WeymenKoo/dc-electronic-load/hardware/outputs/rev_e_v1/placement_top.png

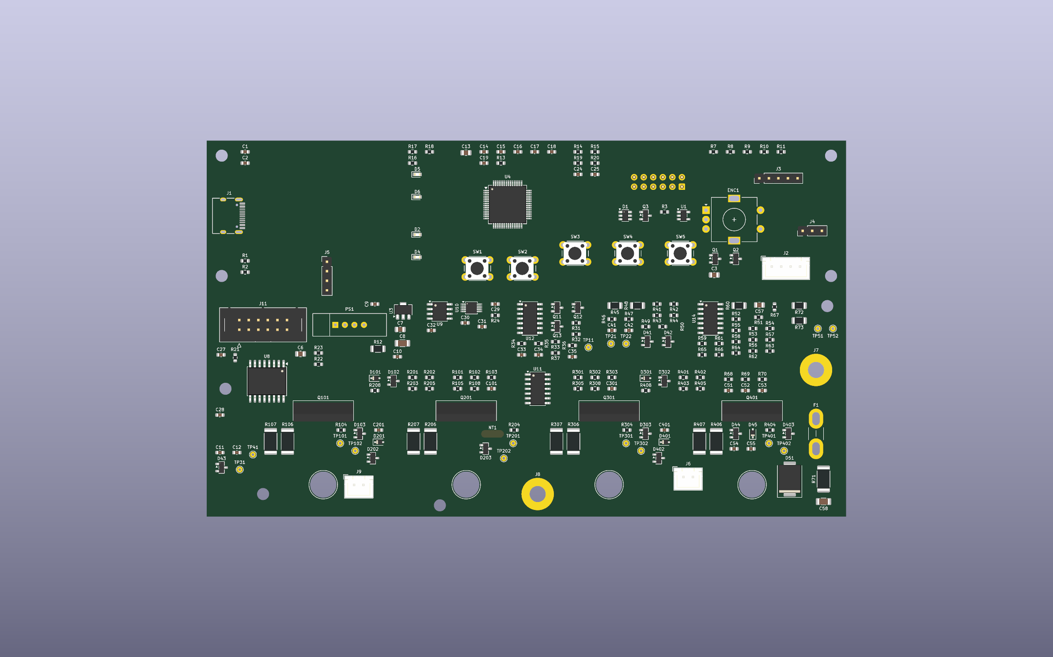
hardware/outputs/rev_e_v1/placement_top.png
