WeymenKoo/dc-electronic-load/simulation/rev_e/README.md

# Rev E decks: the Rev C analog stage with the TLV9154

The same five circuits as `../01_dc_transfer` to `../06_cv_mode` (deck 05, thermal, has no op-amp and is not repeated), generated by the same
`tools/build_decks.py --rev-e` with three differences: the op-amps are TI's TLV9152 PSpice macromodel (`../lib/tlv915x.lib`, one amplifier,
shared by the TLV9154), the channel offset resistor Rb is 15M instead of 22M (+2.6 mV against the TLV9154's 0.83 mV Vos limit), and deck 03's
lowest current corner is 50 mA instead of 25 mA (25 mA per channel is now inside the dead zone). Everything else, including every `.meas`, is
identical so the two result sets compare line by line. The Rev C decks and their results are untouched.

```
rev_e/
├── 01_dc_transfer/      <name>.asc, <name>.plt, plot_<name>.py, README.md, results/ (reference .log and fig*.png)   exactly like the Rev C folders
├── 02_step_response/
├── 03_loop_gain/
├── 04_faults/
├── 06_cv_mode/
└── measurements_summary.txt
```

**Run them from a local copy.** LTspice (the CrossOver build) cannot write its `.raw` incrementally into a Google Drive File Stream folder
("Trouble writing ... to the disk"): `../tools/ltrun_local.sh rev_e/<deck>/<deck>.asc` mirrors the deck and `../lib` into `$TMPDIR/ltrun_local`,
runs LTspice there and copies `.log`, `.raw` and `.net` back. In the LTspice GUI, copy the `simulation` folder somewhere local first.
The TI macromodel is slow to find the operating point when every op-amp output sits at 0 V (dead zone): deck 01 takes about 13 minutes, deck 03
about 4; the "Direct Newton iteration failed" lines followed by "Pseudo Transient succeeded" are that fallback, not a failed run.

| # | Result | Rev E (TLV9154) | Rev C (LT1014 / LT1013) | Figure |
|---|---|---|---|---|
| 01 | Transfer gain | 2.501 A/V | 2.500 A/V | fig01a |
| 01 | Full scale (LOAD_CTRL = 4.096 V) | 10.14 A (106 mA zero offset) | 10.17 A (72 mA) | fig01a |
| 01 | ISEN error after zero subtraction, full scale | −0.002 % | −0.008 % | fig01b |
| 01 | VSEN error against its ideal transfer | +0.13 mV (0.005 % of reading at 48 V) | < 0.02 mV | log |
| 02 | 10–90 % rise, 1 A → 9 A, planar FETs | 22.5–31 µs | 21–31 µs | fig02a |
| 02 | Overshoot, planar FETs | 0 % | 0 % | fig02 |
| 02 | Overshoot, IXTH big-die proxy, 1 µH | **53 % (13.6 A), then a ~300 kHz ring** | 0 % | fig02a |
| 03 | Phase margin, planar FETs, worst of 18 corners | 87.5° | ≥ 86° | fig03 |
| 03 | Gain margin, planar FETs, worst | 21.8 dB | ≥ 22 dB | fig03 |
| 03 | IXTH proxy, worst | 80.2° / **9.1 dB** | 80.3° / 13.2 dB | fig03 |
| 03 | Crossover, 2.5 A per channel | 16–36 kHz | 15–35 kHz | fig03 |
| 04 | Peak current on hot-plug / recovery at 8 A, planar FETs | 8.09 A = set point | 8.12 A = set point | fig04 |
| 04 | Same, IXTH proxy | **13.2 A** (hot-plug and recovery) | 8.12 A | fig04 |
| 04 | OTP trip: time to < 0.8 A | 1–33 µs | 2–35 µs | fig04 |
| 06 | CV on a current source, 1 A and 8 A, with or without 47 µF | 12.00 / 9.998 V, < 0.2 mV pp by 50 ms | 11.97 / 9.97 V, < 4 mV pp | fig06 |
| 06 | CV at 0.1 A, no capacitor | settled, 0.2 mV pp | settled, 3 mV pp | fig06 |
| 06 | CV at 0.1 A with 47 µF | **underdamped: 10.6 V pp ring at 50 ms, still 4.1 V pp at 149 ms** | 7.3 V pp, 1.7 V pp at 149 ms | fig06 |

**What this means for the design.** Deck 06: the CV loop holds 1 A and 8 A sources exactly (the rail-to-rail output removes the LT1013's
0.25 % floor error), but at 0.1 A with 47 µF across the DUT it rings harder and longer than with the LT1013; 0.1 A stays the stated CV minimum
and a capacitive source at that current should be loaded in CC or given a few seconds.

 The IRFP250N (and the IRFP240 / IRF530 fallbacks) keep the Rev C margins with the 6× faster op-amp; the
3.3k / 1n / 47R compensation stays. The big-die IXTH proxy, which stands in for IXYS linear-rated parts that are not in the BOM, loses gain margin
and overshoots on hot-plug; if one is ever fitted, raise Cc to 2.2 nF and re-run decks 02 to 04. The 15M offset resistor moves the dead zone from
72 mA to 106 mA (the first 42 DAC codes); the firmware clamp (code ≥ 42 → 0 A) is the same mechanism as before.

Model-dependent numbers: the TLV9152 macromodel is TI's (SBOMB53B, 2021); treat rise times and margins as ±30 % and verify on the bench
(bring-up step 8 in `../../docs/rev_e_specification.md`).
