WeymenKoo/dc-electronic-load/docs/comparison_cheap_loads.md

# Rev C compared with the AliExpress loads (DL24 / DL24P / DTL150 family)

Evidence is mostly forum measurements and one teardown of an older Atorch unit, not lab reports. Treat each row as "reported", and note that units vary.

| Reported problem on the cheap loads | Source | Rev C answer | Status |
|---|---|---|---|
| Gate spikes to 27.6 V on a ±20 V FET, ringing about 37 V; three FETs blown at about 40 V | [teardown](https://mirror.sevarg.net/2018/06/24/the-atorch-purple-fan-mosfet-destroyer/) | 15 V gate-source zener, Rg at the gate, compensated loop (PM ≥ 80°) | Simulated; bench step test pending |
| No fuse found; a shorted FET across a battery is unlimited | same | F1 15 A 58 V DC | Designed |
| Smoke at 20 V / 9 A, bang under 90 W on a 36 V pack, "practical maximum about 100 W" | [EEVblog DL24P thread](https://eevblog.com/forum/testgear/cheezeball-dc-load-dl24p-pump-or-dump/150) | 4 × TO-247 at 37.5 W each, Tj 127.5 °C at 150 W | Depends on heatsink Rsa, **still an estimate** |
| Advice to stay below 32 V and 10 A despite a 200 V / 20 A label | [done.land](https://done.land/tools/devices/electronicload/dl24atorch/) | 58 V, 10.2 A are the real limits, each with a reason | Designed |
| Weak LM321 driving the gate; instability and high current on reconnect | EEVblog, same thread | KILL line: peak = setpoint on hot-plug and recovery | Simulated, deck 04 |
| Non-CC modes likely in software, slow, with overshoot | EEVblog, same thread | Hardware CV loop | Simulated, deck 06 |
| Unbalanced FET heating, shunts of mismatched value | [EEVblog p. 14](https://eevblog.com/forum/testgear/cheezeball-dc-load-dl24p-pump-or-dump/325) | One op-amp loop per FET | Simulated, deck 01 |
| Series reverse-protection Schottky at 0.42 V, 85–100 °C; limits low-voltage use | EEVblog p. 14 | No series diode, works from about 0.6 V; reverse polarity clears the fuse instead | Designed |
| 4-wire voltage error growing with current | EEVblog, same thread | Separate sense amp and pair (J7) | Designed |
| Low-voltage cut-off re-enables on battery rebound | teardown | Firmware latch (requirement) | Firmware not written |
| Possibly used or counterfeit FETs in the unit | EEVblog p. 14 | You choose the source: buy from an authorised distributor | – |

## Where Rev C does NOT win
- **Price of a finished unit.** One older listing had a 150 W tester [at about $30](https://budgetlightforum.com/t/mini-review-150w-load-unit/43730). Rev E's parts come to US$23.46 at JLCPCB / LCSC prices (2026-11-03, `hardware/outputs/rev_e_v1/BOM_RevE_JLC.csv`) plus about $7 of off-board items (OLED module, 5 V blower, NTC, ribbon, M4 hardware) and $4 to $6 of PCB, so about $35 per instrument excluding the scrap heatsink and the enclosure. (Rev C's parts were about US$65–90 at distributor prices.) It beats a [Siglent SDL1020X-E at about $574](https://valuetronics.com/apps/aeo/ai/md/default/products/8359457521911.md), not a DL24.
- **Very low current.** A DL24 was reported usable down to about 10 mA. Rev C has a deliberate 72 mA dead zone in CC (Rev E: 106 mA, because the TLV9154's offset limit is larger) and a 0.1 A minimum in CV. For a small current source, use a resistor or decade box.
- **Readback resolution.** The 12-bit ADC gives 2.7 mA and 16 mV per LSB. For a precision current source, the DMM in series is the reference and the load only sets the compliance voltage.
- **Ground.** DUT− is common with USB ground, the same class of problem the DL24P thread reports. See the warning in the spec.
- **It exists today.** Firmware for every mode above CC is unwritten.

## Cost estimate (not quotes; check before ordering)
| Item | Estimate | Basis |
|---|---|---|
| 4 × IRFP250NPBF | $13 | [about $3.29 each at Mouser](https://www.flux.ai/jecstronic/irfp250npbf~3kd.md), aggregator figure |
| LT1014DSW#TRPBF | $10 | [about €9.73](https://punchouttest.digikey.es/en/products/detail/analog-devices-inc/LT1014DSW-TRPBF/962051); the non-reel #PBF showed out of stock |
| 2 × LT1013DS8 | $10–15 | my estimate, no price found |
| Passives including 0.1 % parts, LM339, small FETs, diodes | $10–15 | my estimate |
| Connectors, fuse + holder, 2 binding posts + 2 sense terminals | $10–15 | my estimate |
| 2 oz PCB | $5–15 | my estimate |

**Saving taken in Rev E:** the LT parts were replaced by two TLV9154 quads (16 V, Vos 0.83 mV max, $1.34 each at LCSC) with the zero-offset resistor changed from 22M to 15M, and the whole stage was re-simulated (`simulation/rev_e`). The IRFP250N is the genuine Infineon part at LCSC (C2580, $1.00), not the sub-$1 clones.
