WeymenKoo/dc-electronic-load/docs/design_notes_and_calculations_rev_b.xlsx

Sheet: Top
 | Study Material:
 | https://eepower.com/technical-articles/understanding-linear-mosfets-and-their-applications/#
 | https://eevblog.com/forum/projects/dynamic-electronic-load-project/
 | https://www.vishay.com/docs/91019/irf530.pdf
 | https://community.element14.com/members-area/personalblogs/b/blog/posts/lt-spice-loop-gain-and-an-electronic-load
 | https://www.electrical4u.com/bode-plot-gain-margin-phase-margin/#What-is-a-Bode-Plot
 | High level plan:
 | Control Board: |  |  |  |  |  | Power Board:
Led | MCU |  |  |  |  |  | Power MOSFET
 | DAC |  |  |  |  |  | Eload control circuit
Led | 12V buck 5V LDO 3V3 |  |  |  |  |  | DUT power monitoring
 | Input RPP, Fuse |  |  |  |  |  | DUT interface, Banana Plugs
 | Keypad 4x4 |  |  |  |  |  | Hardware OCP, Over Temp |  | Just a Fuse
 | Rotary Encoder |  |  |  |  |  | Heatsink
 | LCD display |  |  |  |  |  | RPP for DUT
 | Opamp Vref
 | Thermocouple circuit
 | Fan control circuit
 | B2B connector to power board |  |  | 3V3 | 3V3 | > | B2B connector to control board
 |  |  |  | 4.096V | Opamp Vref (4.096V) | >
 |  |  |  | A1 | DAC Voltage input for Eload | >
 |  |  |  | A2 | Eload Isense | <
 |  |  |  | A3 | Eload Vsense | <
 |  |  |  | D1 | OCP Trip signal | >
 |  |  |  | D2 | Them Runaway signal | >
 |  |  |  | G | Gnd | <>
 |  |  |  |  | Standoff Gnd
 | B2B Connector arrangement 16pin
 | 1 | 2 | 3 | 4 | 5 | 6 | 7 | 8
 | G | 5V | A1 | G | A2 | G | D2 | G
 | G | 3V3 | A3 | G | D1 | G | 5V | G
 | https://electronics.stackexchange.com/questions/207752/how-many-ground-and-power-pins-to-have-in-a-connector
 | Design Notes:
 | 1. Grounding for Signal Integrity and EMI Control:
 | Ground pins are interleaved between analog and digital signals, creating a shield to reduce cross-talk and EMI.
 | Both rows have ground pins near each reference voltage (3.3V and 5V) to help stabilize and isolate power delivery from signals, reducing potential noise interference.
 | 2. Symmetry for Connector Reversal Protection:
 | Power and ground pins are symmetrically placed across both rows, so accidental reversal won’t lead to shorts or cross-connection of signals.
 | Critical analog signals are placed with ground separation, enhancing signal accuracy and stability for current, voltage, and op-amp control.
 | 3. Pin Isolation and Shielding:
 | Analog signals are separated from digital signals by ground pins to reduce noise coupling and improve overall analog signal integrity.
 | Digital signals are spaced out with grounding to mitigate potential EMI from digital switching activities.

Sheet: MCU
Required features | Quantity | Purpose | Notes |  | MCU Selection:
UART | 1 | Serial Monitor on Laptop | UART to USB Bridge | 1 | ~~STM32F103CBT6~~ | Not enough ADC
SWD | 1 | Program and Debug |  |  | ~~Digikey:~~ | ~~https://www.digikey.ca/en/products/detail/stmicroelectronics/STM32F103CBT6/1754420 ~~
ADC | 3 | Vsense Isense Themocouple | Sensing circuit for the Eload part |  | ~~JLCPCB:~~ | ~~https://jlcpcb.com/partdetail/Stmicroelectronics-STM32F103CBT6/C8304 ~~
I2C Bus | 1 | External DAC with EEPROM LCD Display | Bus, make sure devices have different addr
PWM | 1 | Fan control |  | 2 | STM32F103RET6
Encoder | 1 | Eload Setting |  |  | JLCPCB: | https://jlcpcb.com/partdetail/Stmicroelectronics-STM32F103RET6/C8322
Digital In | 4 | Button Input
 |  | Pgood 5V |  | 3 | ~~Atmega~~ | ~~Only has 10bit adc~~
 |  | Pgood 3V3
 |  | Pgood 12V |  | 4 | ~~STM32F411CEU~~ | ~~Only has 1 adc~~
Digital Out | 2 | OCP trip | Signals to shut off power MOSFETs circuit
 |  | Temp Trip | Signals to shut off power MOSFETs circuit
 |  |  |  |  |  | OSC capacitors sizing
https://www.st.com/resource/en/application_note/an2586-getting-started-with-stm32f10xxx-hardware-development-stmicroelectronics.pdf |  |  |  |  |  | Reference:
 |  |  |  |  |  | https://blog.adafruit.com/2012/01/24/choosing-the-right-crystal-and-caps-for-your-design/
 | Decoupling capacitor placement

Sheet: IO
Rotary encoder
https://www.digikey.ca/en/products/detail/bourns-inc/PEC11L-4120K-S0020/4699173
https://www.bourns.com/docs/Product-Datasheets/PEC11L.pdf
https://www.digikey.ca/en/products/detail/jst-sales-america-inc/B16B-PHDSS/926671 | Connector
https://www.digikey.ca/en/products/detail/jst-sales-america-inc/PHDR-16VS/608615 | Plug
https://www.digikey.ca/en/products/detail/jst-sales-america-inc/APAPA22K152/6009461 | Wire

Sheet: DAC
MCP4725A
Datasheet: | https://www.lcsc.com/datasheet/lcsc_datasheet_1811151442_Microchip-Tech-MCP4725A0T-E-CH_C144198.pdf
JLCPCB: | https://jlcpcb.com/partdetail/MicrochipTech-MCP4725A0T_ECH/C144198
Digikey: | https://www.digikey.ca/en/products/detail/microchip-technology/MCP4725A0T-E-CH/1818537
Widely available, good datasheet, widely used online
https://www.sparkfun.com/products/12918
https://www.adafruit.com/product/935
Has builtin eeprom to store config data
Design: |  | Calculations:
 |  | 12bit | 4095 | decimal
 |  | Vref | 4.096 | V
 |  |  | 0.0010002442 | V/bit

Sheet: Power In
Power Flow chart:
Source 12V PSU | Barrel Connector |  | ~~Reverse Polarity Protection~~ | 03/11/2024: No need cuz barrel connector is mech polarized, also unlikely to vary in current draw
 |  |  | ~~~~OVP Circuit~~, 2A Fuse~~
Wall adapter
Bench PSU
4S Lipo
 | USB 5V |  | 12-20ish V buck to 5V | Tp
 |  |  |  | Pgood Led | https://www.lcsc.com/datasheet/lcsc_datasheet_1811081920_Texas-Instruments-TPS5430DDAR_C9864.pdf
 |  |  | OR
 |  | 5V LDO to 3V3 |  | 5V to 4.096V DAC Vref
 |  | Tp |  | Tp
 |  | Pgood Led |  | Place Close to DAC
DUT in RPP:
Low forward voltage drop

Sheet: Temp
Thermocouple design
Thermal budget
Heatsink sizing
Fan circuit design
 | https://www.ti.com/lit/an/sbaa274a/sbaa274a.pdf?ts=1730026208831
Fan control using NTC | https://www.youtube.com/watch?v=hU86hCRVi3g

Sheet: Eload Stability
4.096V for opamp votlage reference due to it being a stable source. 5V from buck converter is noisy
5V from USB is also very noisy
Max current sink for each mosfet | 5 | A | Max power across resistor | 2.5 | W
Source resistor | 0.1 | Ohm | Max current across Eload | 12.288 | A
Max gate votage | 0.6144 | V
R1 | 68000 | Ohm | Transfer function of Eload | 3 | A/V
R2 | 12000 | Ohm
Vcontrol Max | 4.096 | V

Sheet: MOSFET
https://www.vishay.com/docs/91019/irf530.pdf

Sheet: Pwr Monitor
Voltage sensor
https://www.ti.com/power-management/power-switches/efuse-hotswap-controllers/overview.html |  |  |  | ADC bit |  | ADC cnts | Vout | Vin
 |  |  |  | 4096 | 12 bit | 124.1212121 | 0.1 | 1.0000
https://www.ti.com/lit/ds/symlink/tps1663.pdf?ts=1730614123864 |  |  |  | 0.0008056640625 | V/bit | 248.2424242 | 0.2 | 2.0000
https://www.ti.com/lit/ds/symlink/lmv324.pdf |  |  |  | 3.3 | ADV vref | 372.3636364 | 0.3 | 3.0000
 |  |  |  |  |  | 496.4848485 | 0.4 | 4.0000
EUT Max spec |  |  |  |  |  | 620.6060606 | 0.5 | 5.0000
30 | V |  |  |  |  | 744.7272727 | 0.6 | 6.0000
5 | A |  |  |  |  | 868.8484848 | 0.7 | 7.0000
Vout = (R3/R1) * (V2-V1) |  |  |  |  |  | 992.969697 | 0.8 | 8.0000
3 | V |  |  |  |  | 1117.090909 | 0.9 | 9.0000
 |  |  |  |  |  | 1241.212121 | 1 | 10.0000
R1 | 20000 | Ohm |  |  |  | 1365.333333 | 1.1 | 11.0000
R3 | 2000 | Ohm |  |  |  | 1489.454545 | 1.2 | 12.0000
 |  |  |  |  |  | 1613.575758 | 1.3 | 13.0000
 |  |  |  |  |  | 1737.69697 | 1.4 | 14.0000
 |  |  |  |  |  | 1861.818182 | 1.5 | 15.0000
 |  |  |  |  |  | 1985.939394 | 1.6 | 16.0000
 |  |  |  |  |  | 2110.060606 | 1.7 | 17.0000
 |  |  |  |  |  | 2234.181818 | 1.8 | 18.0000
 |  |  |  |  |  | 2358.30303 | 1.9 | 19.0000
 |  |  |  |  |  | 2482.424242 | 2 | 20.0000
 |  |  |  |  |  | 2606.545455 | 2.1 | 21.0000
 |  |  |  |  |  | 2730.666667 | 2.2 | 22.0000
 |  |  |  |  |  | 2854.787879 | 2.3 | 23.0000
 |  |  |  |  |  | 2978.909091 | 2.4 | 24.0000
 |  |  |  |  |  | 3103.030303 | 2.5 | 25.0000
 |  |  |  |  |  | 3227.151515 | 2.6 | 26.0000
 |  |  |  |  |  | 3351.272727 | 2.7 | 27.0000
 |  |  |  |  |  | 3475.393939 | 2.8 | 28.0000
 |  |  |  |  |  | 3599.515152 | 2.9 | 29.0000
 |  |  |  |  |  | 3723.636364 | 3 | 30.0000
Current sensor
https://www.ti.com/product/INA240
https://www.ti.com/lit/ds/symlink/ina240.pdf?ts=1732175159029
https://www.ti.com/lit/ug/tidu447/tidu447.pdf?ts=1732194664933
For a 10A current shunt, and a 50mV voltage drop, what is a current shutn
ChatGPT said:
ChatGPT
For a 10A current shunt with a 50mV voltage drop, the shunt is a precision resistor designed to produce that 50mV voltage when 10A flows through it. Here's the calculation and what it means:
Resistance of the Shunt
Using Ohm’s Law (V=I×RV = I \times RV=I×R):
R=VIR = \frac{V}{I}R=IV R=50 mV10 A=5 mΩR = \frac{50 \, \text{mV}}{10 \, \text{A}} = 5 \, \text{m}\OmegaR=10A50mV=5mΩ
This means the shunt resistor has a resistance of 5 milliohms (5 mΩ).
Power Dissipation
The power dissipated by the shunt resistor due to the current flowing through it is:
P=I2×RP = I^2 \times RP=I2×R P=102×0.005=0.5 WP = 10^2 \times 0.005 = 0.5 \, \text{W}P=102×0.005=0.5W
This means the shunt needs to handle 0.5 watts of power without overheating.
What the Shunt Does
It provides a voltage output (50mV) proportional to the current (10A) flowing through it.
This voltage can be measured and used to determine the current: I=VRI = \frac{V}{R}I=RV
In this case, a current of 10A will produce 50mV across the shunt.
Applications
Current Measurement:
The voltage (50mV) can be fed into an analog-to-digital converter (ADC) or a differential amplifier to monitor the current.
Power Monitoring:
Combined with a voltage measurement, the shunt can help calculate power (P=V×IP = V \times IP=V×I).
Overcurrent Protection:
Used in circuits to detect if the current exceeds safe limits.
Considerations for a 10A Shunt
1. Material:
Use low-TCR materials like manganin to maintain consistent resistance over temperature variations.
2. Power Rating:
The resistor should handle at least 0.5W, with a safety margin (e.g., 1W or higher).
3. Kelvin Connections:
Use 4-wire (Kelvin) connections to eliminate errors from PCB trace resistance.
4. Physical Design:
Ensure the shunt can handle the thermal and mechanical stresses of a 10A current.
5. Parasitic Effects:
Minimize inductance for accurate measurement of AC or pulsed currents.
Would you like help selecting or designing a specific shunt resistor?
4o
You said:
what is a suitable gain of an opamp for an adc with refernce of 3v3 (20v/v, 50v/v, 100, 200)
ChatGPT said:
ChatGPT
To determine a suitable gain for the op-amp, we need to ensure the output voltage range matches the ADC's input range without clipping. Here's how to decide based on your conditions:
Key Parameters
1. ADC Reference Voltage: 3.3 V3.3 \, \text{V}3.3V (full-scale voltage for the ADC).
2. Shunt Voltage Range: 50 mV50 \, \text{mV}50mV maximum.
3. Gain: G=VADC max/Vshunt maxG = V_{\text{ADC max}} / V_{\text{shunt max}}G=VADC max/Vshunt max.
Gain Calculation
The maximum output voltage of the op-amp (after amplification) must not exceed the ADC reference voltage:
Voutput=Vshunt×GV_{\text{output}} = V_{\text{shunt}} \times GVoutput=Vshunt×G
For Vshunt max=50 mVV_{\text{shunt max}} = 50 \, \text{mV}Vshunt max=50mV:
G=VADC maxVshunt max=3.30.05=66G = \frac{V_{\text{ADC max}}}{V_{\text{shunt max}}} = \frac{3.3}{0.05} = 66G=Vshunt maxVADC max=0.053.3=66
This means the gain should be ≤ 66 to avoid clipping.
Evaluating Options
2. 50 V/V: |  |  | 1.24
Output: 50 mV×50=2.5 V50 \, \text{mV} \times 50 = 2.5 \, \text{V}50mV×50=2.5V
Fits within the 3.3V range.
Good trade-off for higher resolution.

Sheet: Reference
https://www.eevblog.com/forum/projects/yet-another-diy-electronic-load/25/
https://www.eevblog.com/forum/projects/dynamic-electronic-load-project/50/
