WeymenKoo/dc-electronic-load/archive/rev_b_netlists/netlist_RevB_power_board.txt

####  IO.SchDoc
 P1       Header_Male_2R_16P           61301621121                    
 XF1      FUSE_HOLDER-4                3568                           JLCPCB: 
C19727305
Fuse Holder, 20 A, 500 V, -50 to 145 de
 -- nets
  [+12V] P1.16(16)
  [+12V,PORT:+12V] 
  [+3V3] P1.3(3)
  [+3V3,PORT:+3V3] 
  [+4.096V] P1.4(4)
  [+4.096V] P1.13(13)
  [+4.096V,PORT:+4.096V] 
  [DUT Input,PORT:DUT+] XF1.3(3) XF1.4(4)
  [GND] P1.12(12) P1.2(2) P1.8(8)
  [GND] P1.1(1) P1.11(11) P1.15(15) P1.7(7)
  [GND,PORT:DUT-] 
  [GND,PORT:GND] 
  [PORT:DRAIN] XF1.1(1) XF1.2(2)
  [PORT:DUT_ISEN] P1.5(5)
  [PORT:DUT_VSEN] P1.10(10)
  [PORT:FAN-] P1.14(14)
  [PORT:LOAD_CTRL] P1.6(6)
  [PORT:TEMP_IN+] P1.9(9)
####  MOSFETs.SchDoc
 C3       Generic CAP 1210             =Value                         {'Value': '220pF'}
 C4       Generic CAP 1210             =Value                         {'Value': '220pF'}
 C5       11868f565c42a9108669ba33697e C3216X7S2A225K160AB            Multilayer Ceramic Capacitors 2.2uF ±10% 100V X7S SMD 1206
 J1       1e4615820a309e3ce90f9e6d957b 5001                           PC TEST POINT MINIATURE BLACK
 J2       1e4615820a309e3ce90f9e6d957b 5001                           PC TEST POINT MINIATURE BLACK
 J3       1e4615820a309e3ce90f9e6d957b 5001                           PC TEST POINT MINIATURE BLACK
 J4       1e4615820a309e3ce90f9e6d957b 5001                           PC TEST POINT MINIATURE BLACK
 J5       1e4615820a309e3ce90f9e6d957b 5001                           PC TEST POINT MINIATURE BLACK
 Q1       277670f45256a45703965f138927 IRF530PBF                      {'Manufacturer Part Number': 'IRF530PBF'}
 Q2       277670f45256a45703965f138927 IRF530PBF                      {'Manufacturer Part Number': 'IRF530PBF'}
 R12      1029c3af85768c4190bb7ad29bc6 =Value                         {'Manufacturer Part Number': 'RL2512FK-070R2L', 'Value': '200mO'}
 R13      1029c3af85768c4190bb7ad29bc6 =Value                         {'Manufacturer Part Number': 'RL2512FK-070R2L', 'Value': '200mO'}
 R14      1029c3af85768c4190bb7ad29bc6 =Value                         {'Manufacturer Part Number': 'RL2512FK-070R2L', 'Value': '200mO'}
 R15      1029c3af85768c4190bb7ad29bc6 =Value                         {'Manufacturer Part Number': 'RL2512FK-070R2L', 'Value': '200mO'}
 R16      Generic RES 0603             =Value                         {'Value': '68K'}
 R17      Generic RES 0603             =Value                         {'Value': '12K'}
 R18      1029c3af85768c4190bb7ad29bc6 CRCW12062R20FKEA               RES Thick Film, 2.2O, 1%, 0.25W, 100ppm/°C, 1206
 R6       Generic RES 0603             =Value                         {'Value': '100R'}
 R7       Generic RES 0603             =Value                         {'Value': '100R'}
 R8       Generic RES 0603             =Value                         {'Value': '3K3'}
 R9       Generic RES 0603             =Value                         {'Value': '3K3'}
 U3       499df5fc91ff7ad023bcaf249d8b LMV358AIDR                     IC OPAMP GP 2 CIRCUIT 8SOIC
 U3       499df5fc91ff7ad023bcaf249d8b LMV358AIDR                     IC OPAMP GP 2 CIRCUIT 8SOIC
 -- nets
  [+4.096V] U3.8(V+)
  [Control_Voltage] U3.3(+IN A)
  [Control_Voltage] U3.5(+IN B)
  [Control_Voltage] J3.1(1) R16.1(1) R17.2(2)
  [GND] C5.2(2)
  [GND] U3.4(V-)
  [GND] R17.1(1)
  [Gate1] J2.1(1) Q1.1(G) R6.2(2)
  [Gate2] J1.1(1) Q2.1(G) R7.2(2)
  [PORT:DRAIN] Q1.2(D) Q2.2(D) R18.2(2)
  [PORT:LOAD_CTRL] R16.2(2)
  [PORT:Rshunt] R12.1(1) R13.1(1) R14.1(1) R15.1(1)
  [Source1] J5.1(1) Q1.3(S) R12.2(2) R13.2(2) R9.2(2)
  [Source2] J4.1(1) Q2.3(S) R14.2(2) R15.2(2) R8.2(2)
  [-] C4.1(1) R9.1(1) U3.2(-IN A)
  [-] C3.1(1) R8.1(1) U3.6(-IN B)
  [-] C4.2(2) R6.1(1) U3.1(OUT A)
  [-] C3.2(2) R7.1(1) U3.7(OUT B)
  [-] C5.1(1) R18.1(1)
####  Power Monitor.SchDoc
 C1       Generic CAP 1210             =Value                         {'Value': '100nF'}
 C2       Generic CAP 1210             =Value                         {'Value': '100nF'}
 R1       Generic RES 0603             =Value                         {'Value': '2K'}
 R10      Generic RES 0603             =Value                         {'Value': '0R'}
 R11      Generic RES 0603             =Value                         {'Value': '0R'}
 R2       Generic RES 0603             =Value                         {'Value': '20K'}
 R3       Generic RES 0603             =Value                         {'Value': '20K'}
 R4       Generic RES 0603             =Value                         {'Value': '2K'}
 R5       1029c3af85768c4190bb7ad29bc6 WSLP25125L000FEA               WSLP25125L000FEA Res Metal Strip 2512 0.005 Ohm 1% 3W ±110pp
 TP1      TP1                          TP1                            Testpoint double sided
 TP2      TP1                          TP1                            Testpoint double sided
 U1       499df5fc91ff7ad023bcaf249d8b LMV358AIDR                     IC OPAMP GP 2 CIRCUIT 8SOIC
C182039
 U1       499df5fc91ff7ad023bcaf249d8b LMV358AIDR                     IC OPAMP GP 2 CIRCUIT 8SOIC
C182039
 U2       98c6b1d0971071ba4d7dac1d4a4e INA240A2PWR                    {'Manufacturer Part Number': 'INA240A2PWR'}
 -- nets
  [+4.096V] C2.2(2) U2.5(VS)
  [+4.096V] C1.2(2) U1.8(V+)
  [DUT_ISEN_P,PORT:Rshunt] R5.2(2) U2.2(IN+)
  [GND] C2.1(1)
  [GND] R4.2(2)
  [GND] R10.1(1) R11.1(1) U2.1(NC) U2.4(GND)
  [GND] R5.1(1) U2.3(IN-)
  [GND] C1.1(1)
  [GND] U1.4(V-)
  [PORT:DUT+] R2.1(1)
  [PORT:DUT-] R3.1(1)
  [PORT:DUT_ISEN] TP2.1(1) U2.8(OUT)
  [PORT:DUT_VSEN] TP1.1(1) U1.1(OUT A) U1.2(-IN A)
  [-] R3.2(2) R4.1(1) U1.6(-IN B)
  [-] R11.2(2) U2.7(REF1)
  [-] R1.1(1) R2.2(2) U1.5(+IN B)
  [-] R10.2(2) U2.6(REF2)
  [-] R1.2(2) U1.3(+IN A) U1.7(OUT B)
####  Top.SchDoc
 J6       49575d61908034f7a5505a4f8bf3 S3B-XH-SM4-TB(LF)(SN)          CONN HEADER SMD R/A 3POS 2.5MM
 -- nets
  [+12V] J6.2(2)
  [FAN] J6.3(3)
  [GND] J6.4(MNT 1) J6.5(MNT 2)
  [-] J6.1(1)
 SHEETSYM  
  sheettxt U_IO
  sheettxt IO.SchDoc
 SHEETSYM  
  sheettxt U_Power Monitor
  sheettxt Power Monitor.SchDoc
 SHEETSYM  
  sheettxt U_MOSFETs
  sheettxt MOSFETs.SchDoc
