WeymenKoo/dc-electronic-load/simulation/00_baseline_rev_b/results/schematic_preview.png

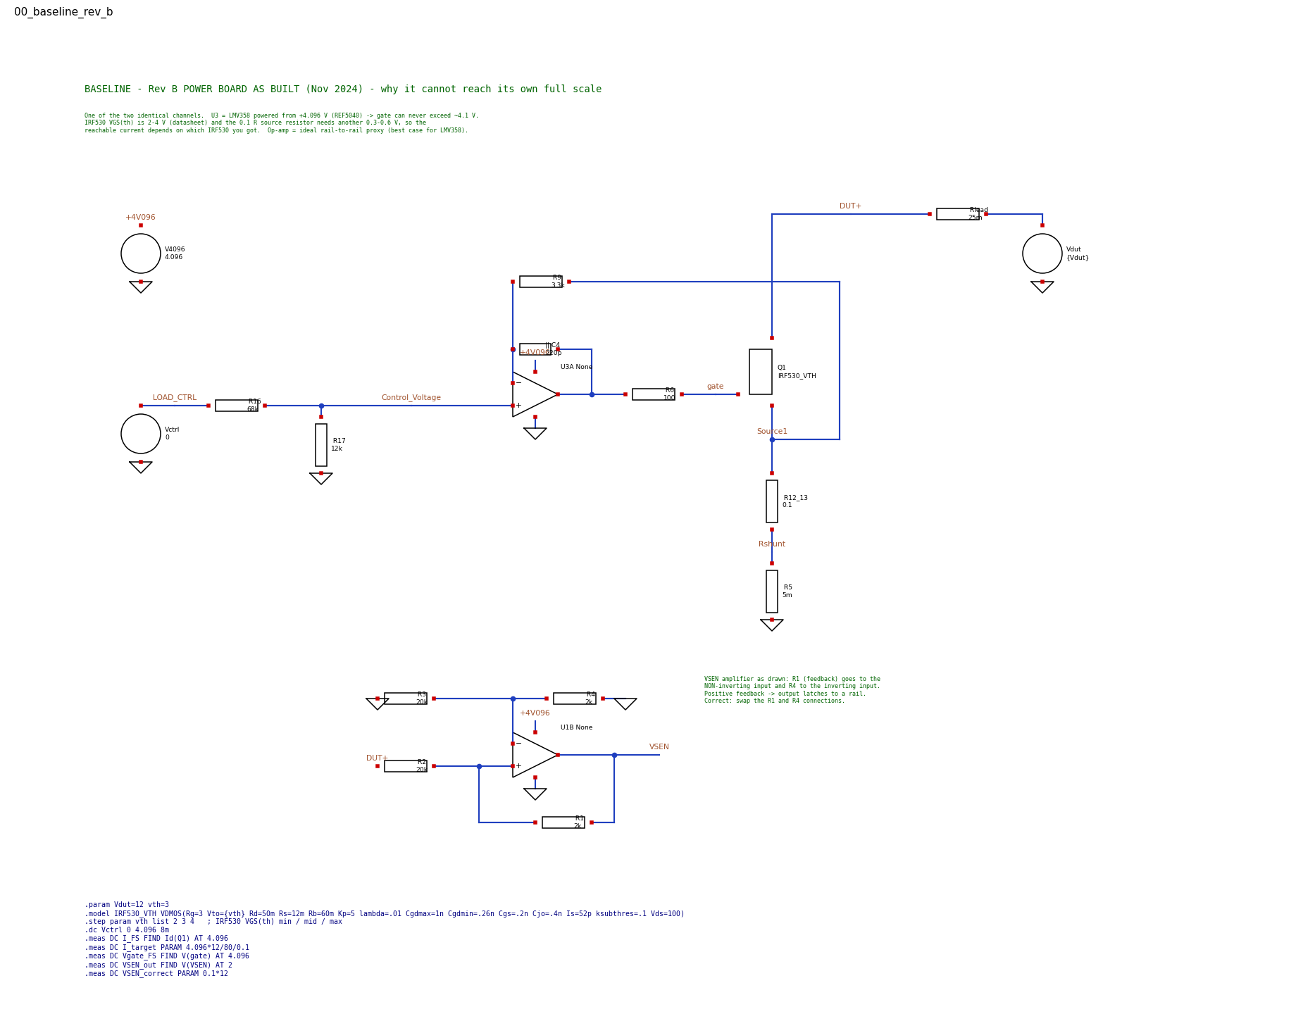
simulation/00_baseline_rev_b/results/schematic_preview.png
