WeymenKoo/dc-electronic-load/simulation/05_thermal/results/schematic_preview.png

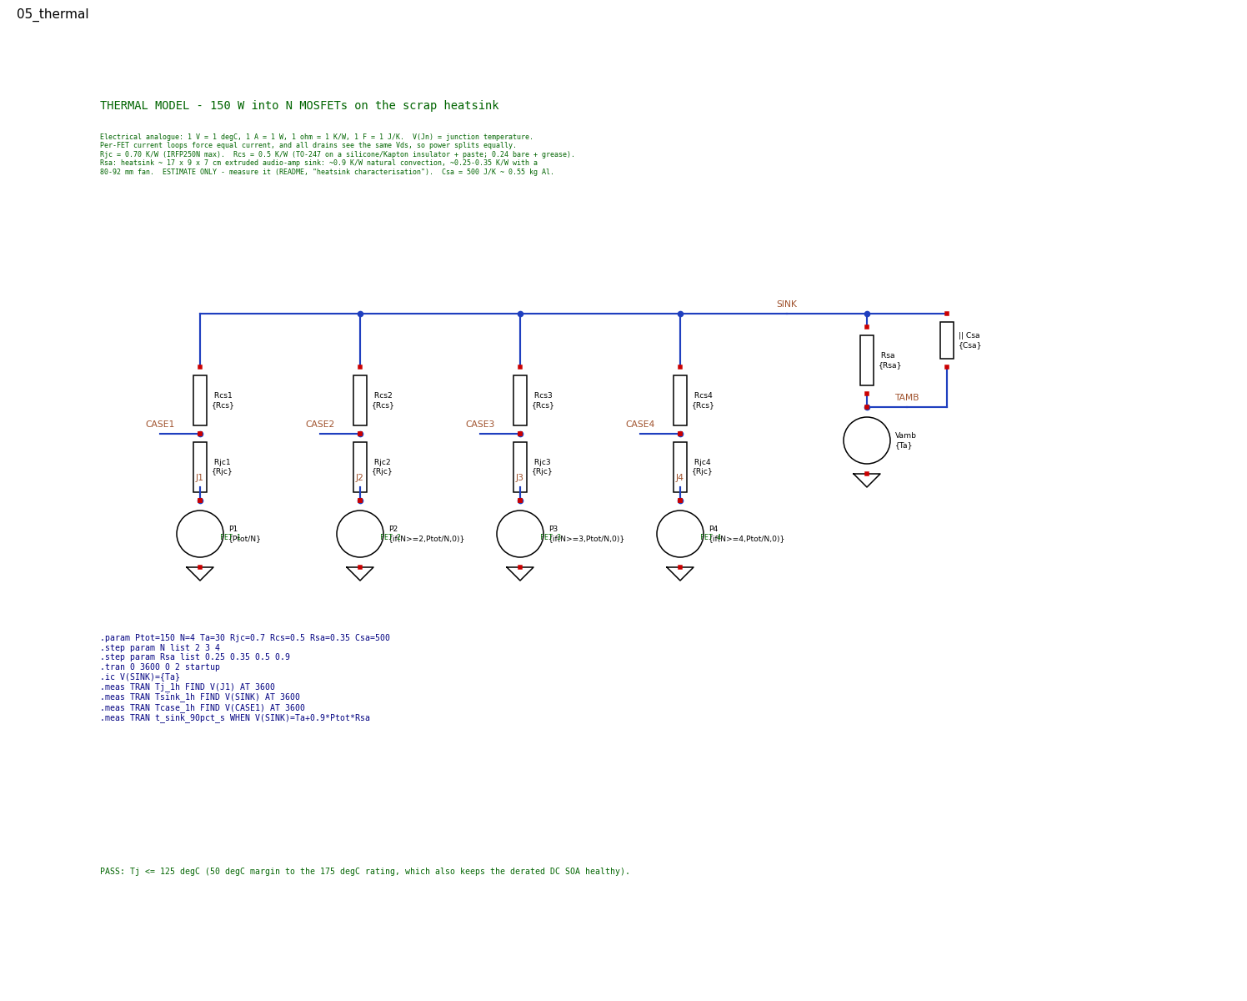
simulation/05_thermal/results/schematic_preview.png
