WeymenKoo/dc-electronic-load/simulation/rev_e/01_dc_transfer/results/schematic_preview.png

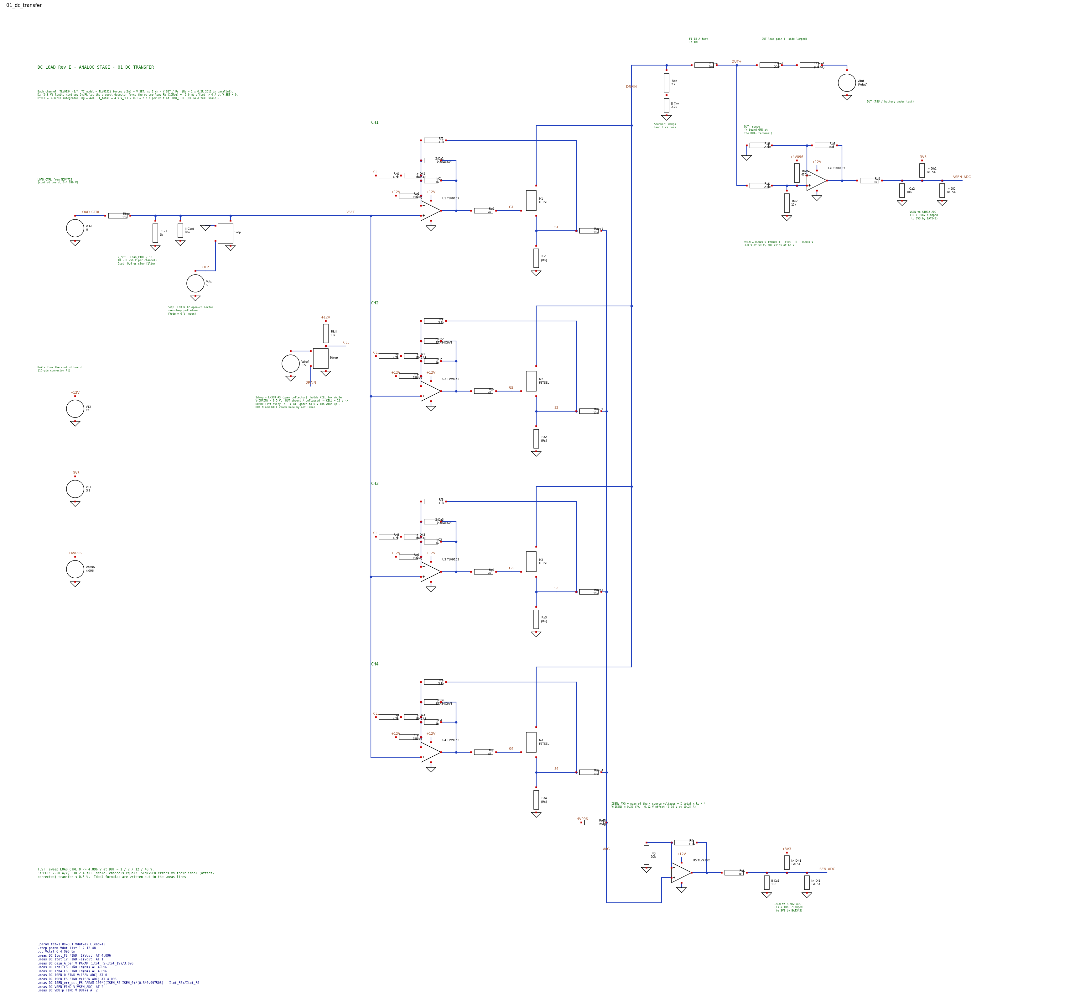
simulation/rev_e/01_dc_transfer/results/schematic_preview.png
