WeymenKoo/dc-electronic-load/simulation/rev_e/03_loop_gain/results/schematic_preview.png

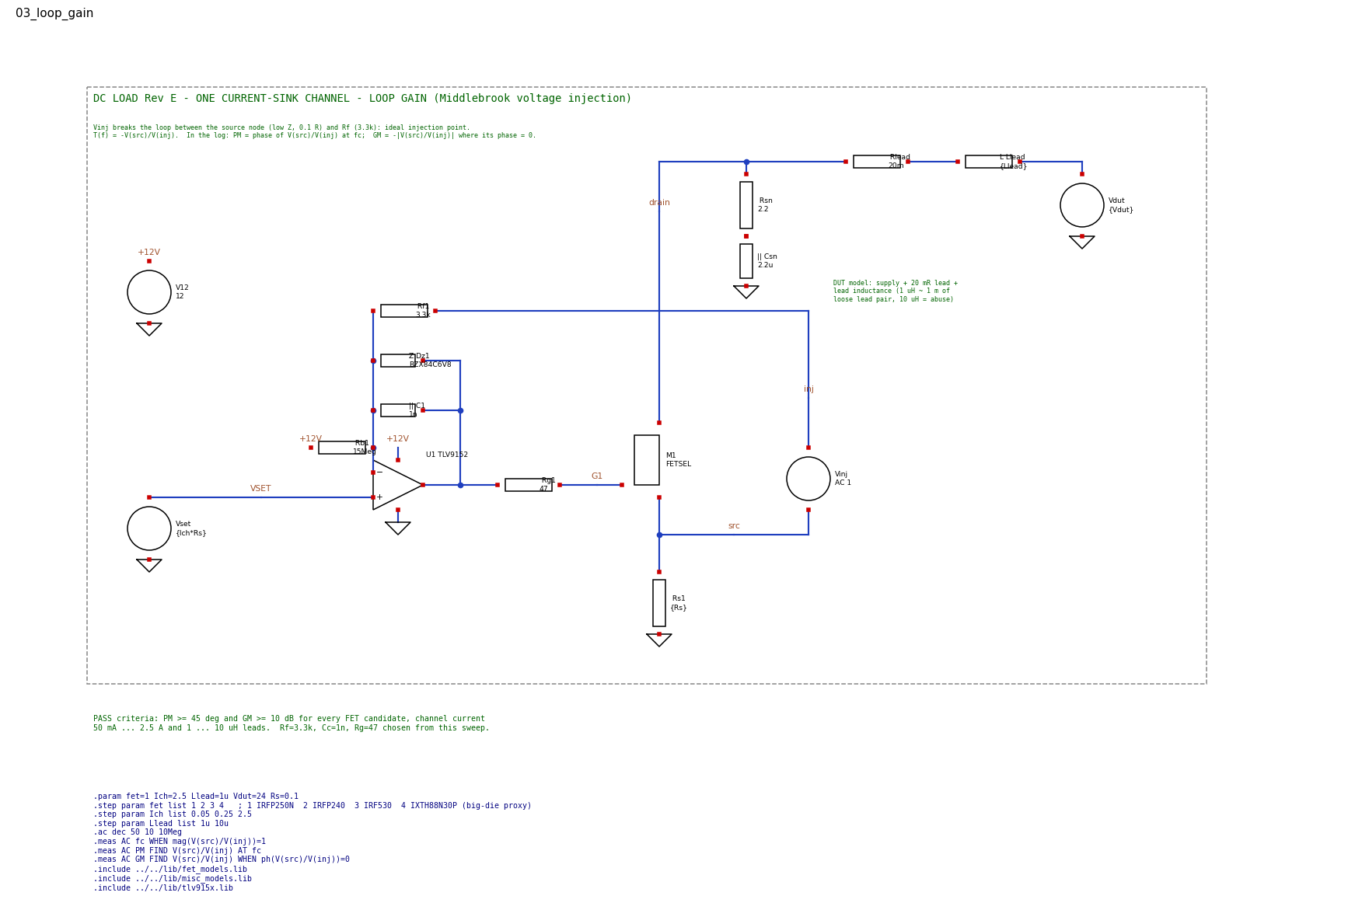
simulation/rev_e/03_loop_gain/results/schematic_preview.png
