WeymenKoo/dc-electronic-load/hardware/outputs/rev_e_v1/BOM_RevE.csv

Refs | Value | Footprint | MPN | LCSC | Tolerance | Qty
C1,C2,C11,C18,C32 | 1uF | Capacitor_SMD:C_0603_1608Metric |  |  |  | 5
C3,C6 | 10uF | Capacitor_SMD:C_0805_2012Metric |  |  |  | 2
C7,C57 | 10uF 25V | Capacitor_SMD:C_0805_2012Metric |  |  |  | 2
C8 | 22uF 25V | Capacitor_SMD:C_1206_3216Metric |  |  |  | 1
C9,C12,C14,C15,C16,C17,C19,C27,C28,C29,C31,C34,C51 | 100nF | Capacitor_SMD:C_0603_1608Metric |  |  |  | 13
C10 | 1uF 25V | Capacitor_SMD:C_0603_1608Metric |  |  |  | 1
C13 | 4.7uF | Capacitor_SMD:C_0805_2012Metric |  |  |  | 1
C24,C25 | 10nF | Capacitor_SMD:C_0603_1608Metric |  |  |  | 2
C30,C33 | 10nF C0G | Capacitor_SMD:C_0603_1608Metric |  |  |  | 2
C35 | 47nF X7R | Capacitor_SMD:C_0603_1608Metric |  |  |  | 1
C41,C42 | 10nF C0G 50V | Capacitor_SMD:C_0603_1608Metric |  |  |  | 2
C52 | 100nF X7R | Capacitor_SMD:C_0603_1608Metric |  |  |  | 1
C53,C54,C55 | 100nF 50V | Capacitor_SMD:C_0603_1608Metric |  |  |  | 3
C58 | 2.2uF 100V X7R | Capacitor_SMD:C_1206_3216Metric |  | C170101 |  | 1
C101,C201,C301,C401 | 1nF C0G 50V | Capacitor_SMD:C_0603_1608Metric |  |  |  | 4
CBL1 | IDC ribbon 2x6, ~80 mm |  | 12-way 1.27 mm ribbon, about 80 mm, two 2x6 IDC sockets (FC-12P type, LCSC C65556 or AliExpress), pin 1 to pin 1 |  |  | 1
D1 | USBLC6-2SC6 | Package_TO_SOT_SMD:SOT-23-6 |  | C5261088 |  | 1
D2 | LED green | LED_SMD:LED_0603_1608Metric | KT-0603G | C12624 |  | 1
D4 | LED blue | LED_SMD:LED_0603_1608Metric | KT-0603B | C2288 |  | 1
D5 | LED green | LED_SMD:LED_0603_1608Metric | KT-0603N | C12624 |  | 1
D6 | LED red | LED_SMD:LED_0603_1608Metric | KT-0603D | C2286 |  | 1
D41,D42 | BAT54S | Package_TO_SOT_SMD:SOT-23 |  | C12765 |  | 2
D43 | BZX84C12 | Package_TO_SOT_SMD:SOT-23 |  | C118577 |  | 1
D44 | BAT54C | Package_TO_SOT_SMD:SOT-23 |  | C2135 |  | 1
D45,D101,D201,D301,D401 | 1N4148WS | Diode_SMD:D_SOD-323 |  | C2128 |  | 5
D51 | SMCJ70A TVS | Diode_SMD:D_SMC |  | C2943781 |  | 1
D102,D202,D302,D402 | BZX84C6V8 | Package_TO_SOT_SMD:SOT-23 |  | C118571 |  | 4
D103,D203,D303,D403 | BZX84C15 | Package_TO_SOT_SMD:SOT-23 |  | C328579 |  | 4
ENC1 | PEC11R-4215F-S0024 | Rotary_Encoder:RotaryEncoder_Alps_EC11E-Switch_Vertical_H20mm | Bourns PEC11R-4215F-S0024 (24 detents, push switch, 15 mm flatted shaft; any EC11 with switch fits) | C143790 |  | 1
F1 | 15A 58VDC mini blade | Fuse:Fuse_Blade_Mini_directSolder | Littelfuse 0997015.WXN, soldered in (pluggable option: holder 178.6764.0001, LCSC C142933) | C207027 |  | 1
J1 | USB-C 16P | Connector_USB:USB_C_Receptacle_HRO_TYPE-C-31-M-12 | HRO TYPE-C-31-M-12 (16 pin, USB 2.0) | C165948 |  | 1
J2 | FAN 4-pin | Connector_JST:JST_XH_B4B-XH-A_1x04_P2.50mm_Vertical | JST B4B-XH-A(LF)(SN) | C144395 |  | 1
J3 | SWD | Connector_PinHeader_2.54mm:PinHeader_1x05_P2.54mm_Vertical | B-2100S05P-A110 | C124379 |  | 1
J4 | UART 3V3 | Connector_PinHeader_2.54mm:PinHeader_1x03_P2.54mm_Vertical | B-2100S03P-A110 | C124376 |  | 1
J5 | I2C OLED | Connector_PinHeader_2.54mm:PinHeader_1x04_P2.54mm_Vertical | B-2100S04P-A110 (the OLED module itself comes from AliExpress) | C124378 |  | 1
J6 | NTC 10k B3950 | Connector_JST:JST_XH_B2B-XH-A_1x02_P2.50mm_Vertical | JST B2B-XH-A(LF)(SN); NTC = 10k B3950 ring-lug thermistor | C158012 |  | 1
J7 | DUT+ | MountingHole:MountingHole_4.3mm_M4_Pad | M4 x 12 bolt, nut, 2 washers (hardware store) |  |  | 1
J8 | DUT- | MountingHole:MountingHole_4.3mm_M4_Pad | M4 x 12 bolt, nut, 2 washers (hardware store) |  |  | 1
J9 | SENSE | Connector_JST:JST_XH_B2B-XH-A_1x02_P2.50mm_Vertical | JST B2B-XH-A(LF)(SN) | C158012 |  | 1
J10 | IDC 2x6 CTRL | Connector_IDC:IDC-Header_2x06_P2.54mm_Vertical | 2x6 shrouded box header 2.54 mm, BOOMELE 2.54-2*6P (LCSC C9136). Pin n = ribbon conductor n | C9136 |  | 1
J11 | IDC 2x6 PWR | Connector_IDC:IDC-Header_2x06_P2.54mm_Vertical | 2x6 shrouded box header 2.54 mm, BOOMELE 2.54-2*6P (LCSC C9136). Pin n = ribbon conductor n | C9136 |  | 1
NT1 | STAR | NetTie:NetTie-2_SMD_Pad2.0mm |  |  |  | 1
PS1 | B0512S-1W | dcload:SIP-4_P2.54mm_DCDC_1W | DEXU B0512S-1W (LCSC C5244116, 1.5 kV); alt Mornsun B0512S-1WR3 (C5358214, 3 kV) | C5244116 |  | 1
Q1 | AO3401A | Package_TO_SOT_SMD:SOT-23 |  | C15127 |  | 1
Q2,Q3,Q11,Q12,Q13 | 2N7002 | Package_TO_SOT_SMD:SOT-23 |  | C8545 |  | 5
Q101,Q201,Q301,Q401 | IRFP250NPBF | Package_TO_SOT_THT:TO-247-3_Vertical | IRFP250NPBF (Infineon, LCSC C2580; not the sub-$1 clones) | C2580 |  | 4
R1,R2 | 5.1k | Resistor_SMD:R_0603_1608Metric |  |  | 1% | 2
R3,R10,R13,R16,R17,R18,R24,R33,R37 | 1k | Resistor_SMD:R_0603_1608Metric |  |  |  | 9
R7,R9,R19,R20,R21,R22,R23,R52,R56,R61,R64,R70 | 10k | Resistor_SMD:R_0603_1608Metric |  |  |  | 12
R8,R65,R105,R205,R305,R405 | 100k | Resistor_SMD:R_0603_1608Metric |  |  |  | 6
R12 | 4.7R | Resistor_SMD:R_1206_3216Metric |  |  |  | 1
R14,R15 | 4.7k | Resistor_SMD:R_0603_1608Metric |  |  |  | 2
R31 | 15k | Resistor_SMD:R_0603_1608Metric |  |  | 1% | 1
R32,R44,R50 | 1k | Resistor_SMD:R_0603_1608Metric |  |  | 1% | 3
R34,R35,R57 | 100k | Resistor_SMD:R_0603_1608Metric |  |  | 1% | 3
R36,R42,R46,R49,R66,R108,R208,R308,R408 | 10k | Resistor_SMD:R_0603_1608Metric |  |  | 1% | 9
R41,R67 | 1M | Resistor_SMD:R_0603_1608Metric |  |  | 1% | 2
R43 | 110k | Resistor_SMD:R_0603_1608Metric |  |  | 1% | 1
R45,R48 | 200k | Resistor_SMD:R_1206_3216Metric |  | C17954 | 1% | 2
R47 | 470k | Resistor_SMD:R_0603_1608Metric |  |  | 1% | 1
R51,R54,R58,R62,R69 | 10.0k | Resistor_SMD:R_0603_1608Metric |  |  | 1% | 5
R53 | 90.9k | Resistor_SMD:R_0603_1608Metric |  |  | 1% | 1
R55 | 402k | Resistor_SMD:R_0603_1608Metric |  |  | 1% | 1
R59 | 165k | Resistor_SMD:R_0603_1608Metric |  |  | 1% | 1
R60 | 47k | Resistor_SMD:R_1206_3216Metric |  | C102201 | 1% | 1
R63 | 27.4k | Resistor_SMD:R_0603_1608Metric |  |  | 1% | 1
R68 | 5.90k | Resistor_SMD:R_0603_1608Metric |  |  | 1% | 1
R71 | 2.2R 1W | Resistor_SMD:R_2512_6332Metric |  | C25480 | 5% | 1
R72,R73 | 100R | Resistor_SMD:R_1206_3216Metric |  | C17901 |  | 2
R101,R201,R301,R401 | 4.7k | Resistor_SMD:R_0603_1608Metric |  |  | 1% | 4
R102,R202,R302,R402 | 15M | Resistor_SMD:R_0603_1608Metric |  |  | 5% | 4
R103,R203,R303,R403 | 3.3k | Resistor_SMD:R_0603_1608Metric |  |  | 1% | 4
R104,R204,R304,R404 | 47 | Resistor_SMD:R_0603_1608Metric |  |  | 1% | 4
R106,R107,R206,R207,R306,R307,R406,R407 | 0R2 2W | Resistor_SMD:R_2512_6332Metric |  | C5375444 | 1% | 8
SW1 | RESET | Button_Switch_THT:SW_PUSH_6mm | KH-6X6X5H-TJ | C2837515 |  | 1
SW2 | BOOT | Button_Switch_THT:SW_PUSH_6mm | KH-6X6X5H-TJ | C2837515 |  | 1
SW3 | ON/OFF | Button_Switch_THT:SW_PUSH_6mm | KH-6X6X5H-TJ 6 x 6 mm tact switch | C2837515 |  | 1
SW4 | MODE | Button_Switch_THT:SW_PUSH_6mm | KH-6X6X5H-TJ 6 x 6 mm tact switch | C2837515 |  | 1
SW5 | MENU | Button_Switch_THT:SW_PUSH_6mm | KH-6X6X5H-TJ 6 x 6 mm tact switch | C2837515 |  | 1
TP11 | VSET | TestPoint:TestPoint_THTPad_D1.5mm_Drill0.7mm |  |  |  | 1
TP21 | ISEN_ADC | TestPoint:TestPoint_THTPad_D1.5mm_Drill0.7mm |  |  |  | 1
TP22 | VSEN_ADC | TestPoint:TestPoint_THTPad_D1.5mm_Drill0.7mm |  |  |  | 1
TP31 | CV_SET | TestPoint:TestPoint_THTPad_D1.5mm_Drill0.7mm |  |  |  | 1
TP41 | KILL | TestPoint:TestPoint_THTPad_D1.5mm_Drill0.7mm |  |  |  | 1
TP51 | DUT+ | TestPoint:TestPoint_THTPad_D1.5mm_Drill0.7mm |  |  |  | 1
TP52 | DRAIN | TestPoint:TestPoint_THTPad_D1.5mm_Drill0.7mm |  |  |  | 1
TP101,TP201,TP301,TP401 | GATE | TestPoint:TestPoint_THTPad_D1.5mm_Drill0.7mm |  |  |  | 4
TP102,TP202,TP302,TP402 | SOURCE | TestPoint:TestPoint_THTPad_D1.5mm_Drill0.7mm |  |  |  | 4
U1 | AP2112K-3.3 | Package_TO_SOT_SMD:SOT-23-5 |  | C23380830 |  | 1
U3 | L78L05 | Package_TO_SOT_SMD:SOT-89-3 | L78L05ABUTR (SOT-89) | C42738 |  | 1
U4 | STM32G0B1RBT6 | Package_QFP:LQFP-64_10x10mm_P0.5mm | STM32G0B1RBT6 | C5143679 |  | 1
U8 | CA-IS3761HW | Package_SO:SOIC-16W_7.5x10.3mm_P1.27mm | Chipanalog CA-IS3761HW, 5 kVrms, default-HIGH outputs (pin-compatible: TI ISO7761DW, C2871529) | C528656 |  | 1
U9 | MCP4822 | Package_SO:SOIC-8_3.9x4.9mm_P1.27mm | MCP4822-E/SN | C16040 |  | 1
U10 | ADS1118 | Package_SO:TSSOP-10_3x3mm_P0.5mm | ADS1118IDGSR | C55347 |  | 1
U11,U12 | TLV9154 | Package_SO:SOIC-14_3.9x8.7mm_P1.27mm | TLV9154IDR | C2873614 |  | 2
U14 | LM339 | Package_SO:SOIC-14_3.9x8.7mm_P1.27mm | LM339DR | C5236695 |  | 1
