WeymenKoo/dc-electronic-load/archive/rev_a2_2024-07_cheaper_altium/Project Outputs for CHEAPER Dc load/ExportSTEP/DCLoad.step

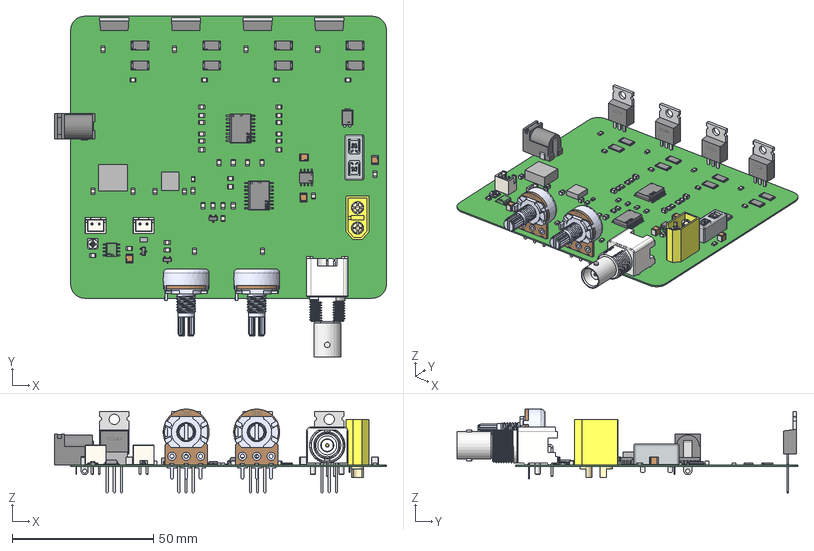
[picture p6: CAD file, 2026-10-31, an earlier design]
archive/rev_a2_2024-07_cheaper_altium/Project Outputs for CHEAPER Dc load/ExportSTEP/DCLoad.step
117.7 x 120.8 x 29.7 mm
POT_WH148_15MM x 14
Extruded x 135
BOUR-TC33X-2_2
pins x 5
part number & logo x 2
B2B-XH-A x 2
JST Logo adjustable x 2
terminals x 4
logo x 7
IC_BODY
circle
IC_LEG x 4
Texas Instruments
IC_LEG_MIR8 x 4
housing
cover
base_2
base
marking
c-5227161-7-b-3d
TE connectivity Logo 1 (2)
pj-002a
logo2
keystone-PN3568
Leader x 3
Diod Logo
Notch
Yageo Logo x 8
Infineon IRF5305PBF 2 x 4
Infineon IRF5305PBF 1 x 4
Infineon IRF5305PBF 4 x 4
Infineon IRF5305PBF 3 x 12
