WeymenKoo/dc-electronic-load/simulation/rev_e/02_step_response/results/fig02_step_response.png

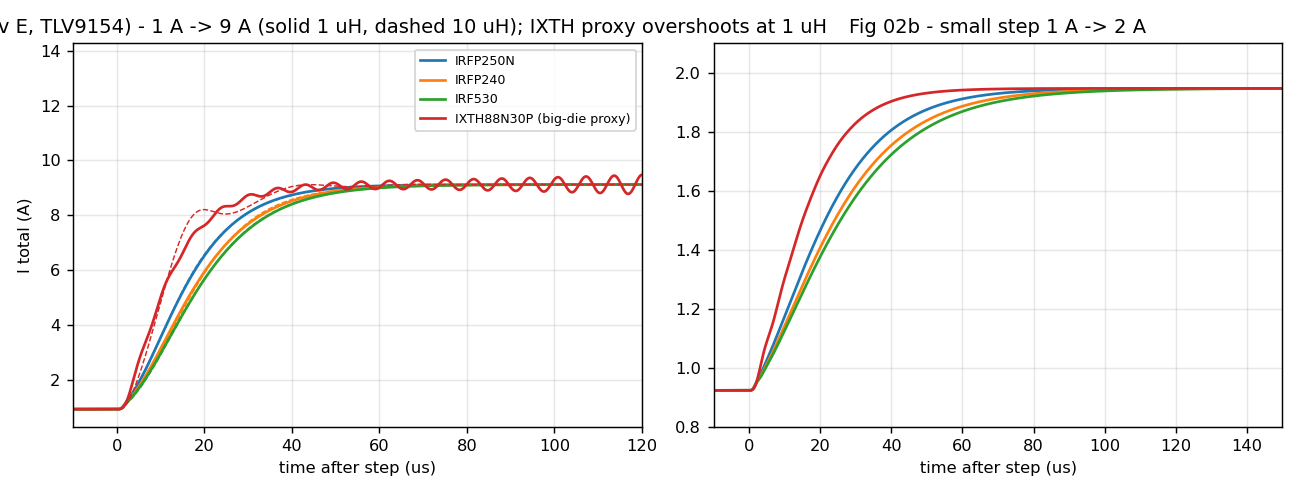
simulation/rev_e/02_step_response/results/fig02_step_response.png
