WeymenKoo/dc-electronic-load/simulation/measurements_summary.txt

===== 00_baseline_rev_b/00_baseline_rev_b.log
  i_fs                   5.681 | 2.047 | 0.04357
  i_target               6.144 | 6.144 | 6.144
  vgate_fs               4.096 | 4.096 | 4.096
  vsen_out               4.1 | 4.1 | 4.1
  vsen_correct           1.2 | 1.2 | 1.2
===== 01_dc_transfer/01_dc_transfer.log
  itot_fs                10.17 | 10.17 | 10.17 | 10.17
  itot_1v                2.427 | 2.427 | 2.427 | 2.428
  gain_a_per_v           2.5 | 2.5 | 2.5 | 2.5
  ich1_fs                2.542 | 2.542 | 2.542 | 2.542
  ich4_fs                2.542 | 2.542 | 2.542 | 2.542
  isen_0                 0.1216 | 0.1216 | 0.1216 | 0.1216
  isen_fs                3.164 | 3.164 | 3.164 | 3.164
  isen_err_pct_fs        -0.007666 | -0.007713 | -0.008182 | -0.009861
  vsen                   0.1294 | 0.1784 | 0.6684 | 2.433
  vdutp                  0.8965 | 1.897 | 11.9 | 47.9
  vsen_ideal             0.1294 | 0.1784 | 0.6684 | 2.433
  vsen_err_mv            -0.001843 | -0.002742 | -0.006313 | -0.01854
  vsen_err_pct_of_reading -0.0042 | -0.002952 | -0.001083 | -0.00079
  ploss_fs               7.48 | 17.65 | 119.3 | 485.4
===== 02_step_response/02_step_response.log
  t_rise_us              2.638e-05 | 2.982e-05 | 3.139e-05 | 2.101e-05 | 2.645e-05 | 2.862e-05 | 3.088e-05 | 2.406e-05
  ipk_up                 9.145 | 9.145 | 9.145 | 9.144 | 9.145 | 9.145 | 9.145 | 9.148
  i_hi                   9.145 | 9.145 | 9.145 | 9.144 | 9.145 | 9.145 | 9.145 | 9.144
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
  tcase_1h               105 | 92.5 | 86.25 | 120 | 107.5 | 101.2 | 142.5 | 130 | 123.7 | 202.5 | 190 | 183.7
  t_sink_90pct_s         86.65 | 86.65 | 86.65 | 254.7 | 254.7 | 254.7 | 447.9 | 447.9 | 447.9 | 923.1 | 923.1 | 923.1
