WeymenKoo/dc-electronic-load/simulation/rev_e/measurements_summary.txt

===== rev_e/01_dc_transfer/01_dc_transfer.log
  itot_fs                10.14 | 10.14 | 10.14 | 10.14
  itot_1v                2.4 | 2.4 | 2.4 | 2.4
  gain_a_per_v           2.501 | 2.501 | 2.501 | 2.501
  ich1_fs                2.535 | 2.535 | 2.535 | 2.535
  ich4_fs                2.535 | 2.535 | 2.535 | 2.535
  isen_0                 0.124 | 0.124 | 0.124 | 0.124
  isen_fs                3.159 | 3.159 | 3.159 | 3.159
  isen_err_pct_fs        -9.005e-05 | -0.0001285 | -0.0006065 | -0.002299
  vsen                   0.1295 | 0.1785 | 0.6686 | 2.433
  vdutp                  0.8971 | 1.897 | 11.9 | 47.9
  vsen_ideal             0.1294 | 0.1784 | 0.6685 | 2.433
  vsen_err_mv            0.1256 | 0.1251 | 0.1254 | 0.1268
  vsen_err_pct_of_reading 0.2862 | 0.1347 | 0.02151 | 0.005404
  ploss_fs               7.468 | 17.61 | 119 | 484.1
===== rev_e/02_step_response/02_step_response.log
  t_rise_us              2.64e-05 | 2.976e-05 | 3.128e-05 | 2.255e-05 | 2.652e-05 | 2.854e-05 | 3.08e-05 | 2.502e-05
  ipk_up                 9.117 | 9.117 | 9.117 | 13.63 | 9.117 | 9.117 | 9.117 | 9.126
  i_hi                   9.117 | 9.117 | 9.117 | 9.203 | 9.117 | 9.117 | 9.117 | 9.117
  i_lo                   0.9229 | 0.9229 | 0.9229 | 0.9229 | 0.9229 | 0.9229 | 0.9229 | 0.9229
  overshoot_pct          0 | 0 | 0 | 53.49 | 0 | 0 | 0 | 0.1017
  i_at_20us              6.741 | 6.163 | 5.895 | 7.766 | 6.782 | 6.121 | 5.899 | 8.179
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
  v_after_istep          12 | 12.57 | 12 | 12 | 12 | 12
  v_10v                  9.998 | 11.83 | 9.998 | 9.998 | 9.998 | 9.998
  vpp_10v                0 | 4.13 | 0 | 0 | 0 | 9.537e-07
  iload                  0.11 | 0.101 | 1.1 | 1.1 | 8.8 | 8.8
