WeymenKoo/dc-electronic-load/simulation/00_baseline_rev_b/results/fig00_baseline_rev_b.png

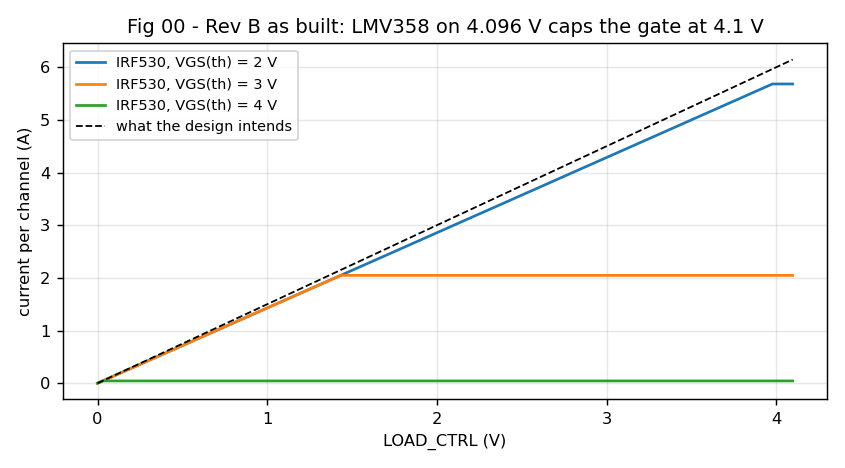
simulation/00_baseline_rev_b/results/fig00_baseline_rev_b.png
