WeymenKoo/dc-electronic-load/simulation/05_thermal/results/fig05_thermal.png

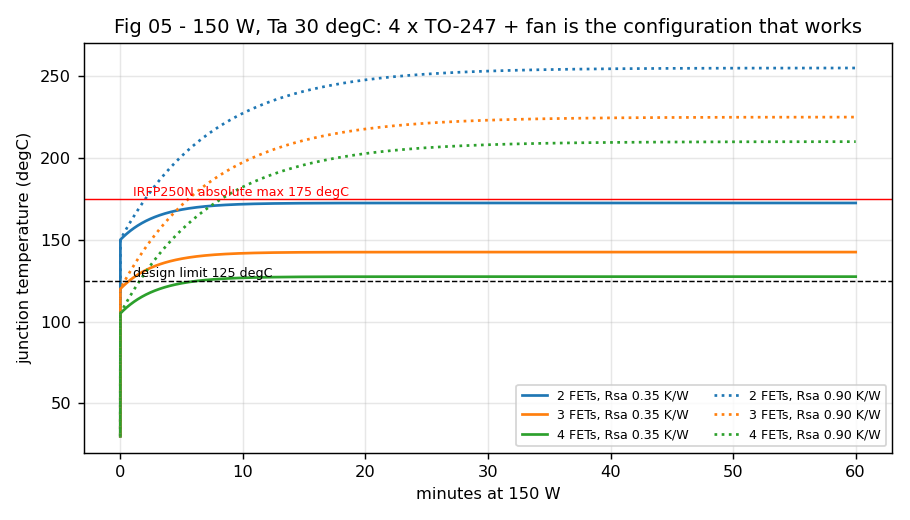
simulation/05_thermal/results/fig05_thermal.png
