WeymenKoo/dc-electronic-load/simulation/rev_e/01_dc_transfer/results/fig01_dc_transfer.png

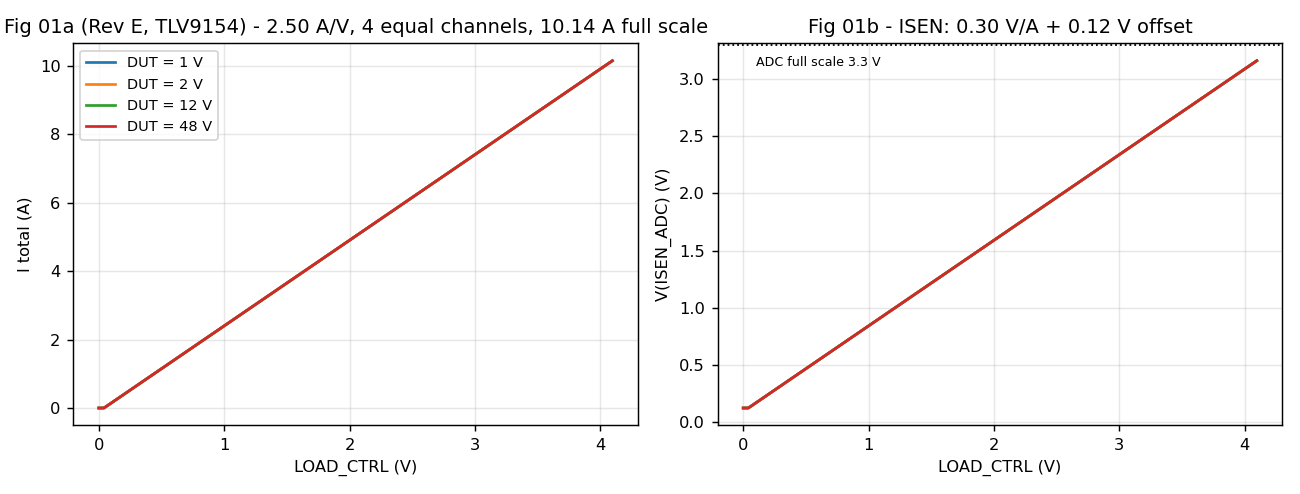
simulation/rev_e/01_dc_transfer/results/fig01_dc_transfer.png
