WeymenKoo/dc-electronic-load/simulation/rev_e/03_loop_gain/results/fig03_loop_gain.png

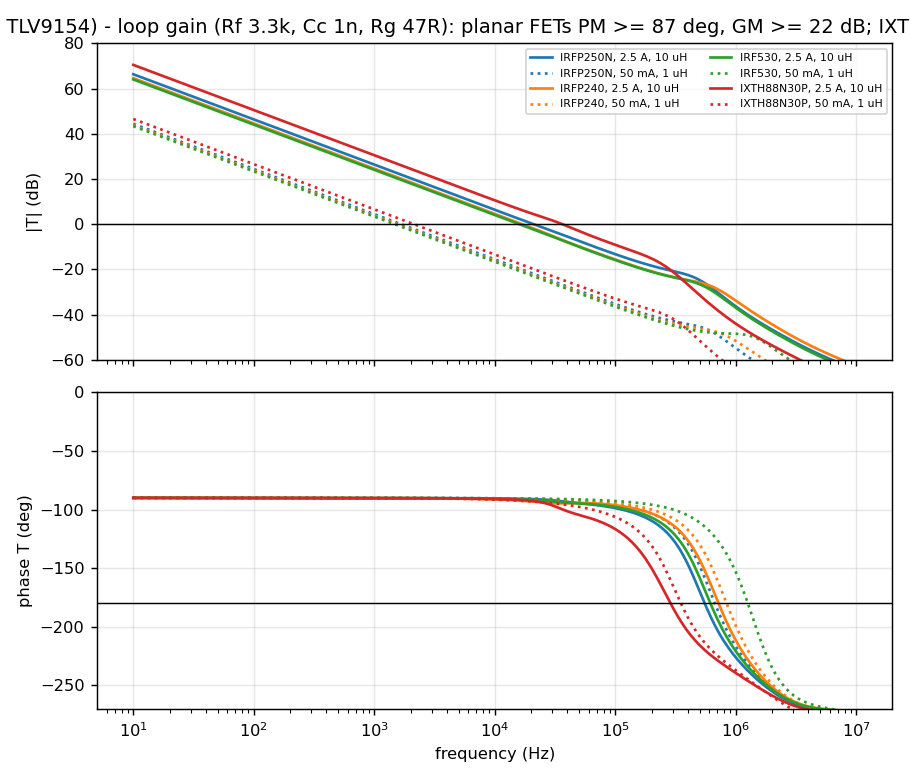
simulation/rev_e/03_loop_gain/results/fig03_loop_gain.png
