WeymenKoo/dc-electronic-load/simulation/rev_e/04_faults/results/fig04_faults.png

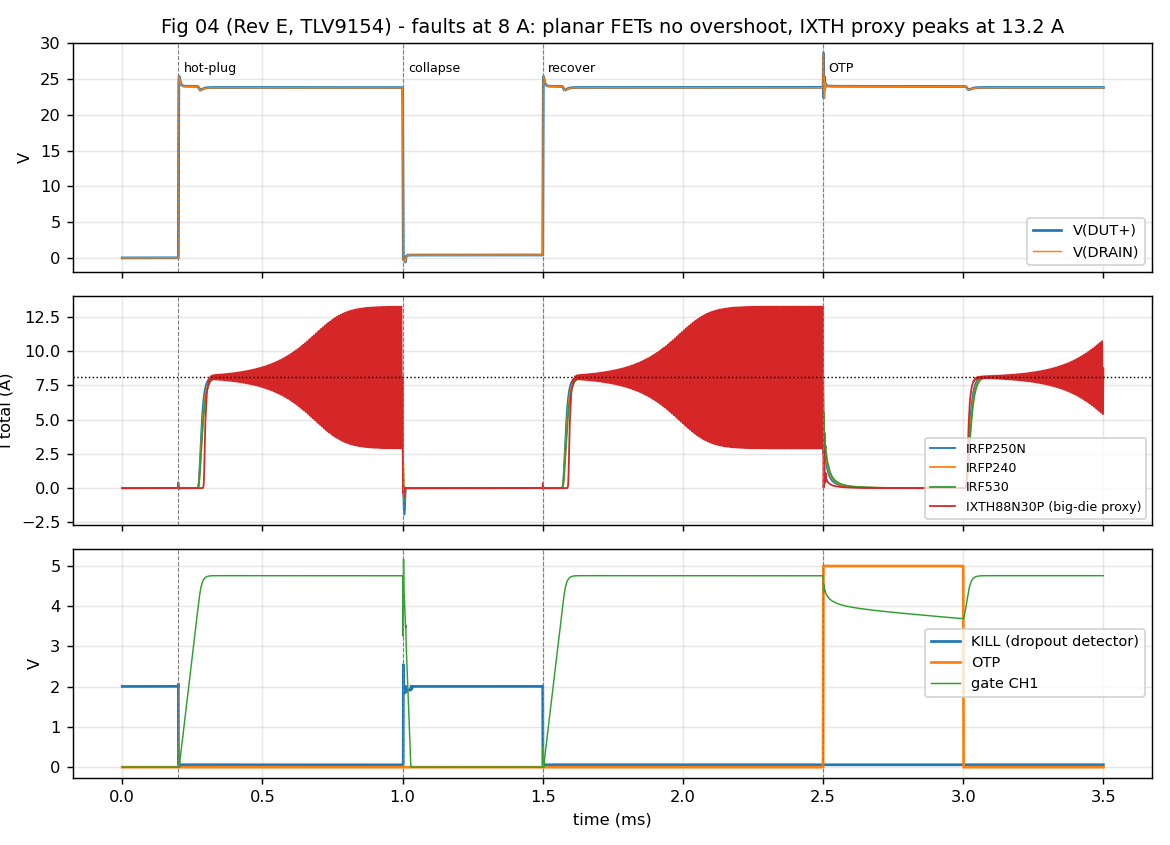
simulation/rev_e/04_faults/results/fig04_faults.png
