WeymenKoo/dc-electronic-load/simulation/rev_e/06_cv_mode/results/fig06_cv_mode.png

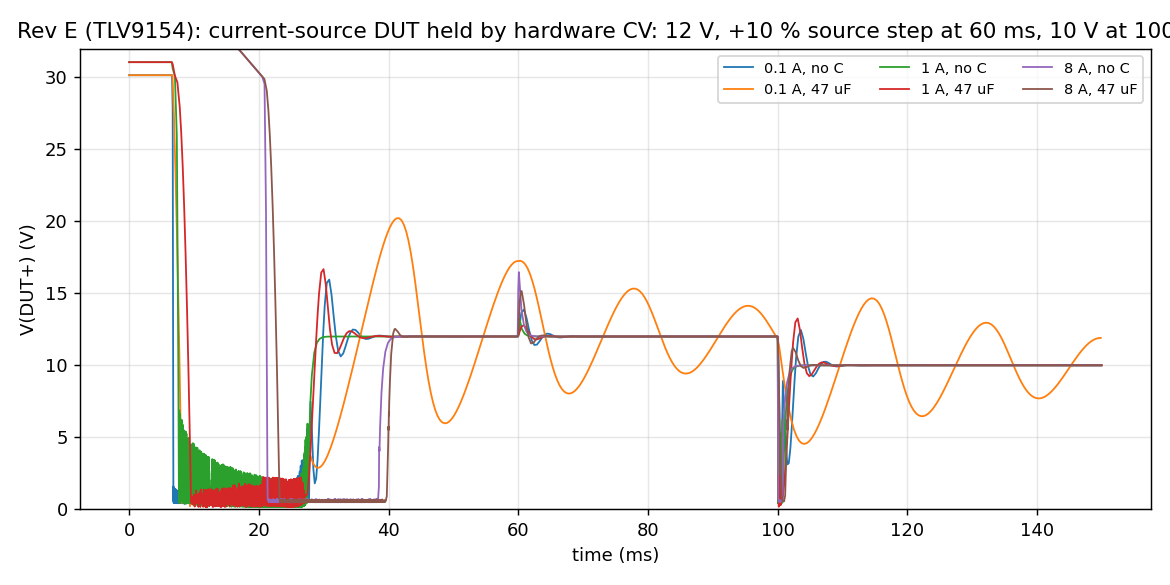
simulation/rev_e/06_cv_mode/results/fig06_cv_mode.png
