WeymenKoo/dc-electronic-load/hardware/outputs/rev_e_v1/DC_Load_RevE_placement.pdf

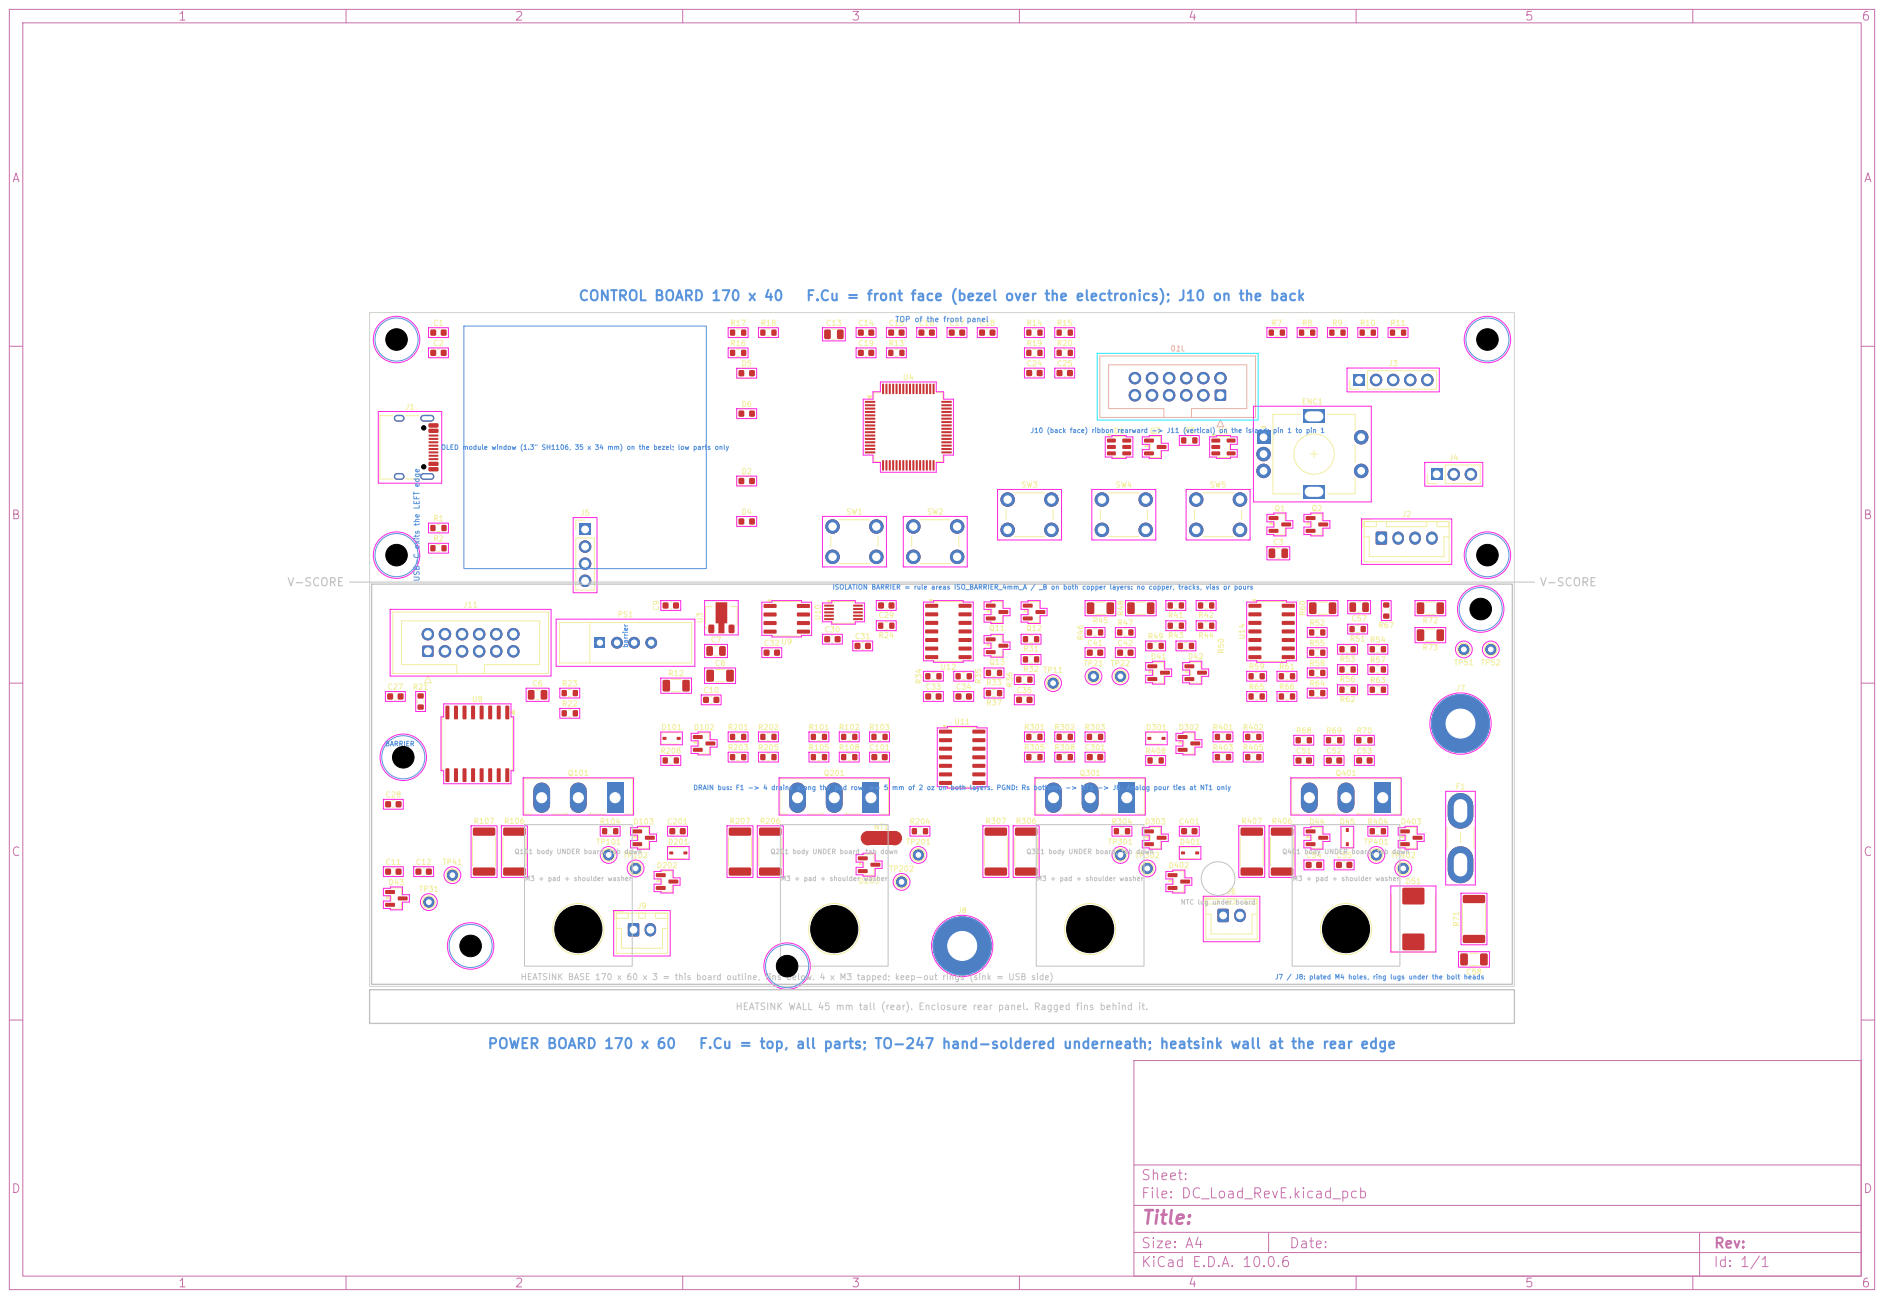
[picture p15: page 1]

ISOLATION BARRIER = rule areas ISO_BARRIER_4mm_A / _B on both copper layers: no copper, tracks, vias or pours

Size: A4 | Rev:
KiCad E.D.A. 10.0.6 | Id: 1/1
