WeymenKoo/dc-electronic-load/archive/rev_a2_2024-07_cheaper_altium/Project Outputs for CHEAPER Dc load/Job1.PDF

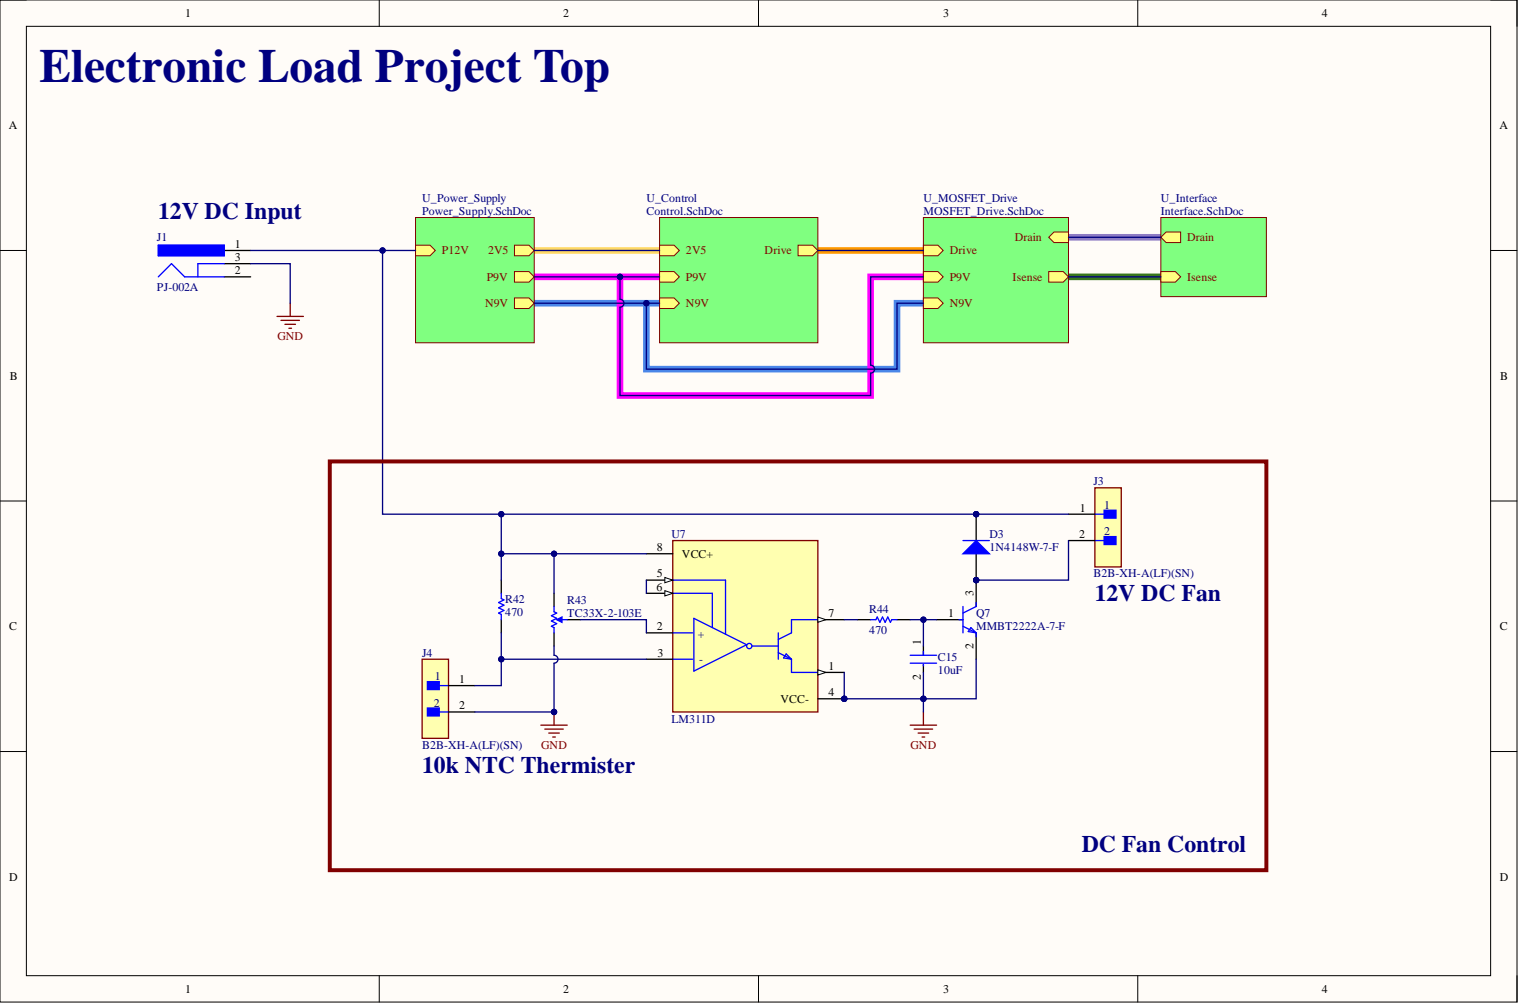
[picture p44: page 1]

Electronic Load Project Top

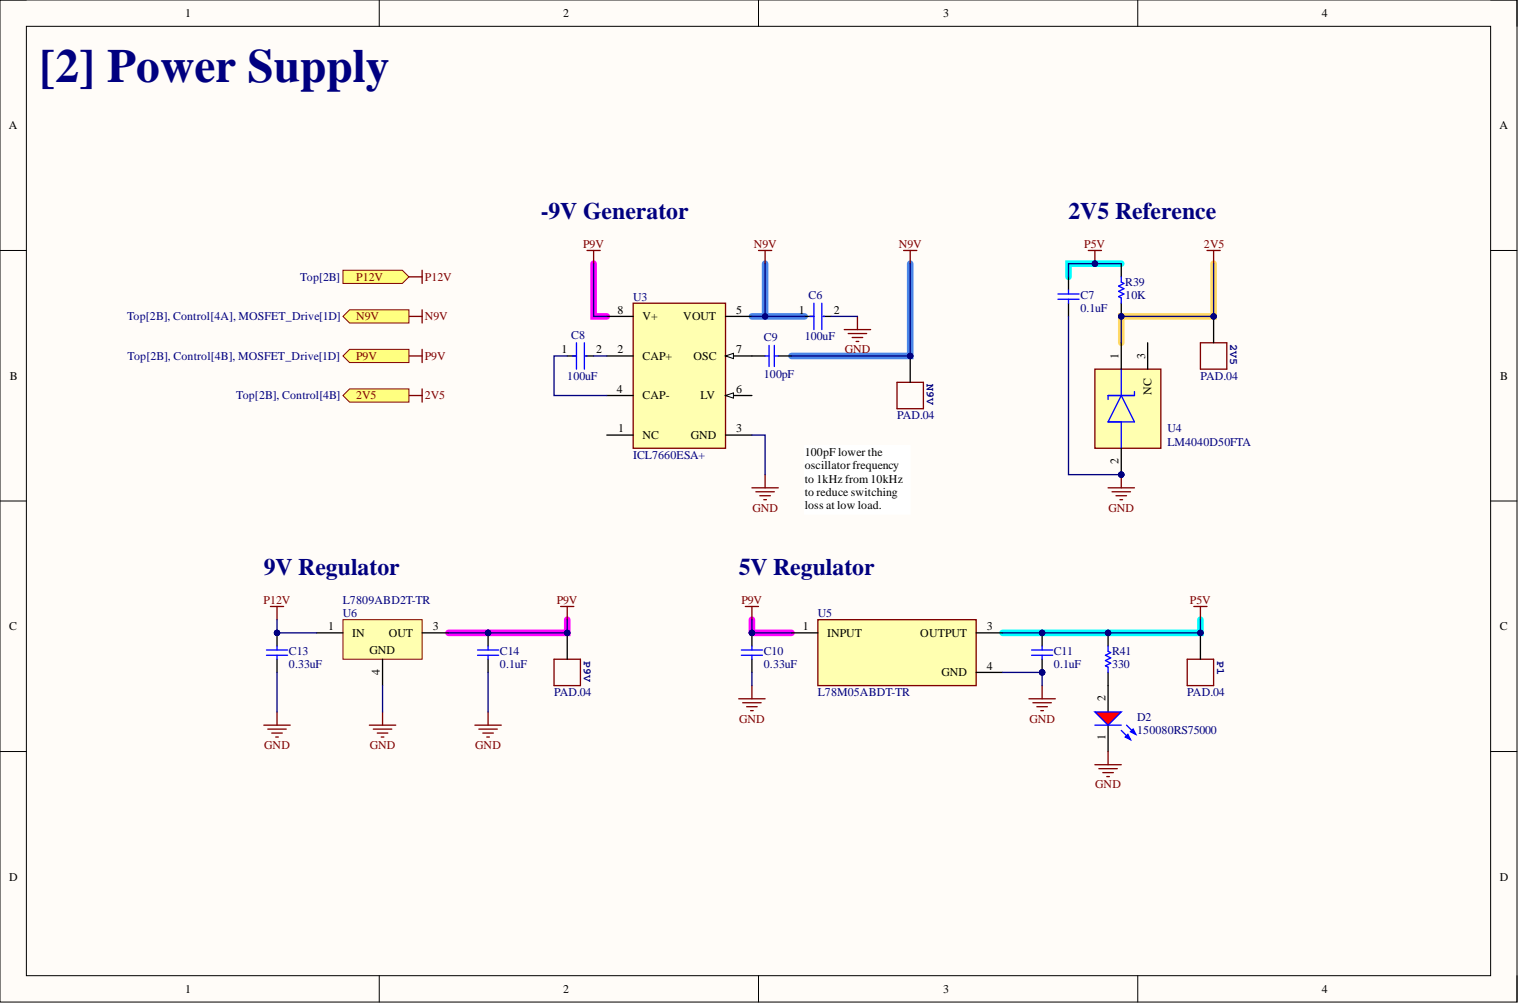
[picture p45: page 2]

CAP+ 2 | GND

100pF lower the
oscillator frequency
to 1kHz from 10kHz
to reduce switching
loss at low load.

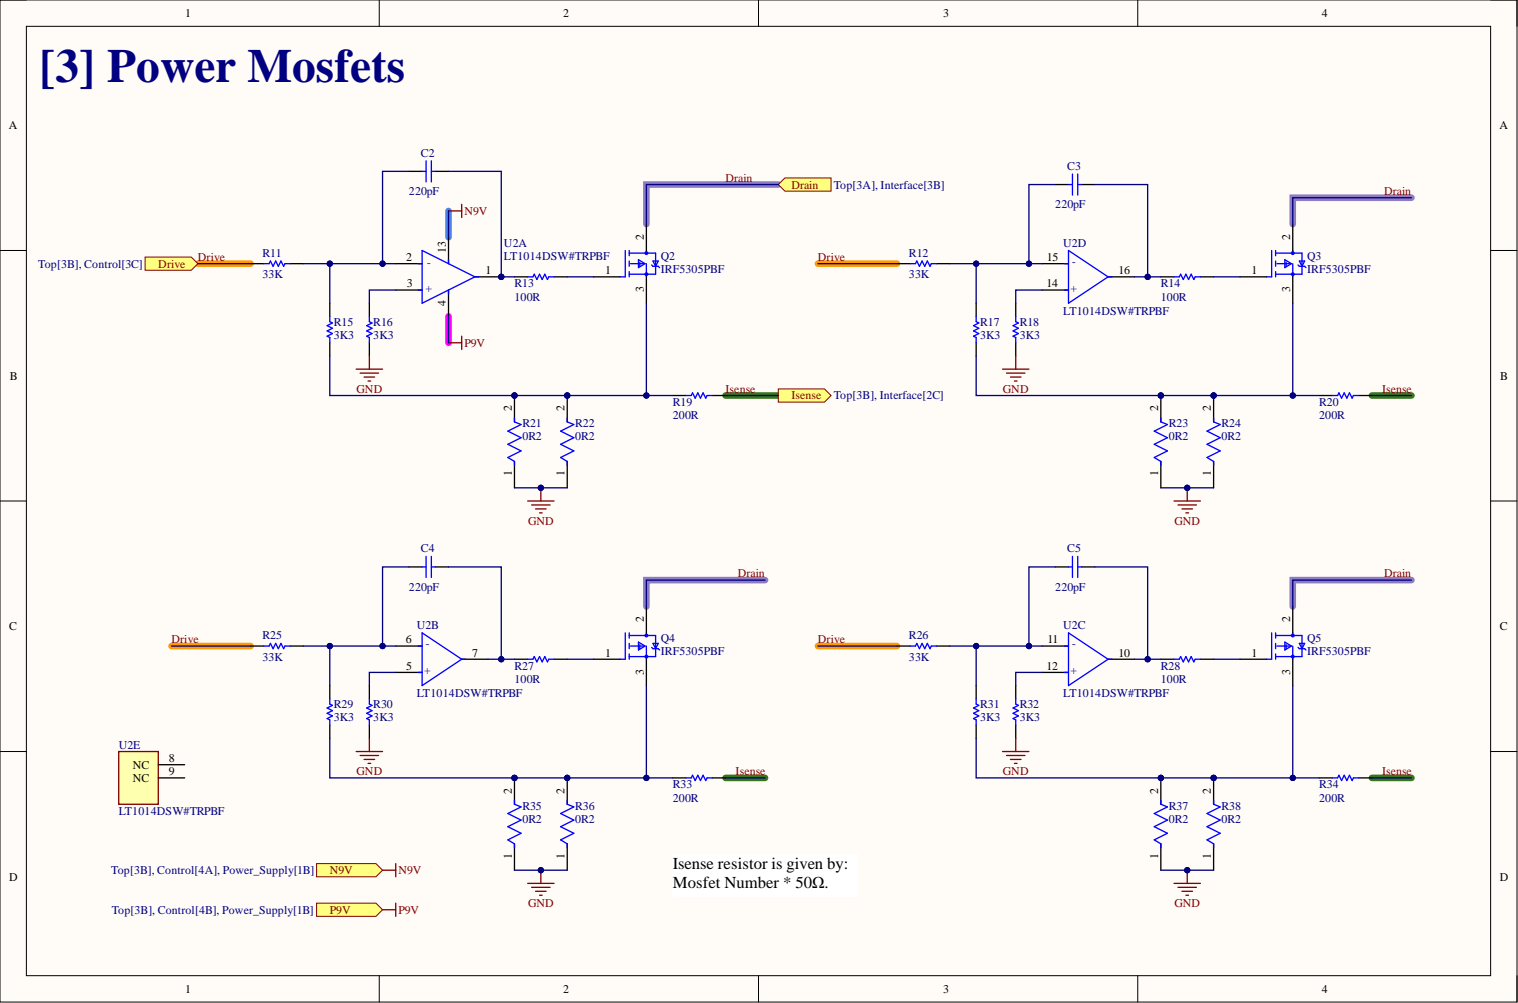
[picture p46: page 3]

Isense resistor is given by:

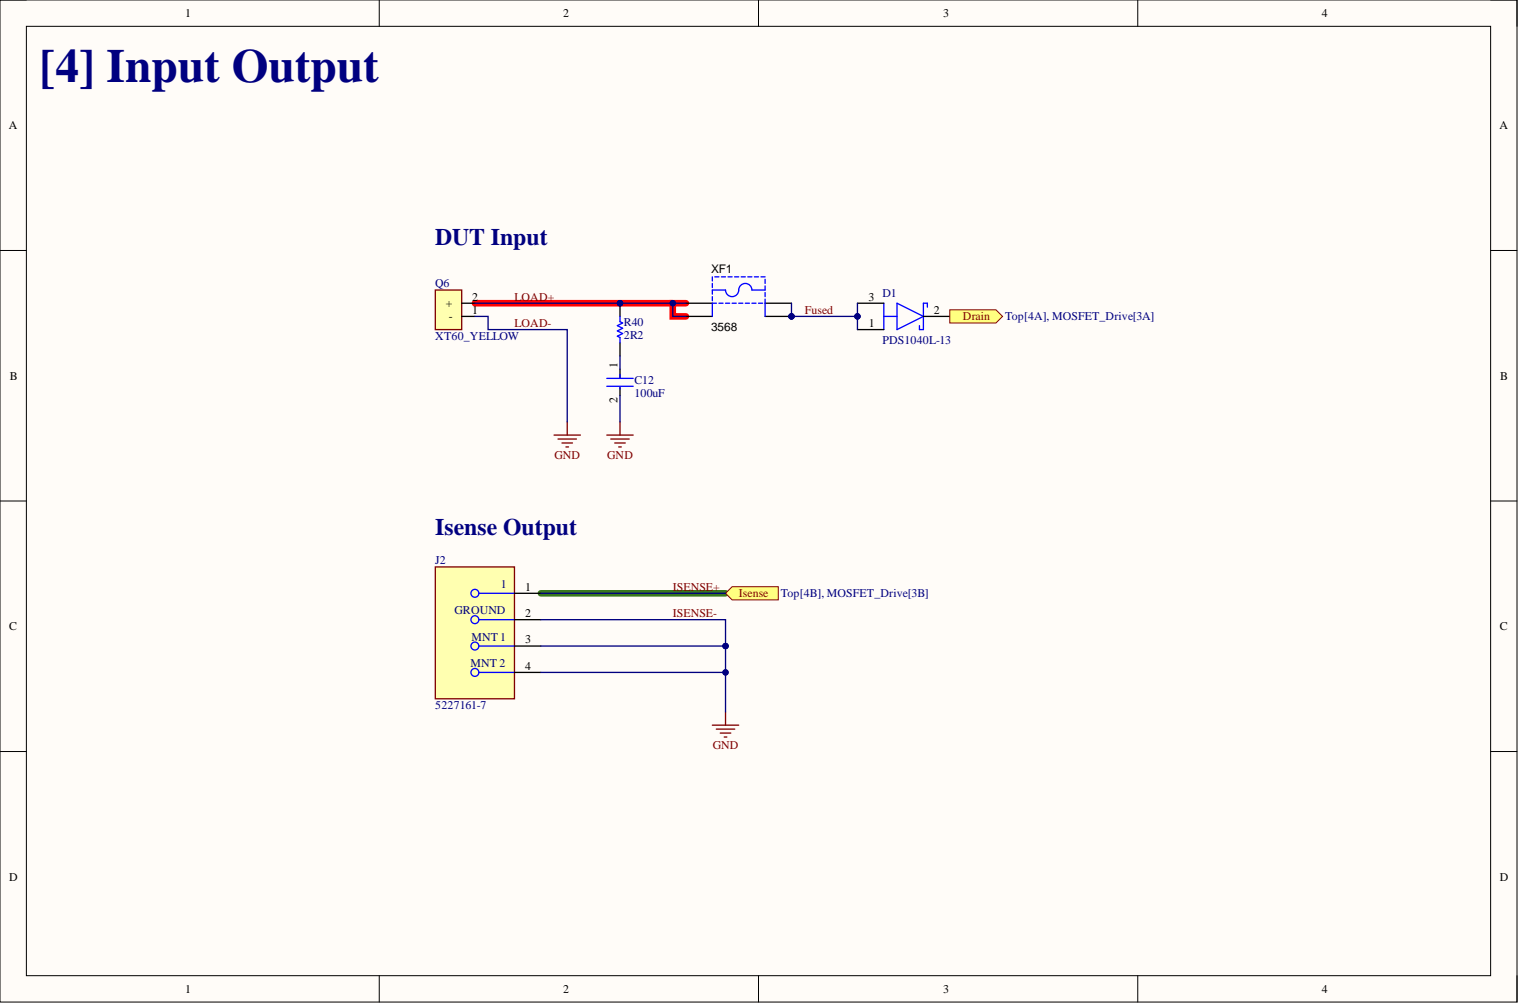
[picture p47: page 4]

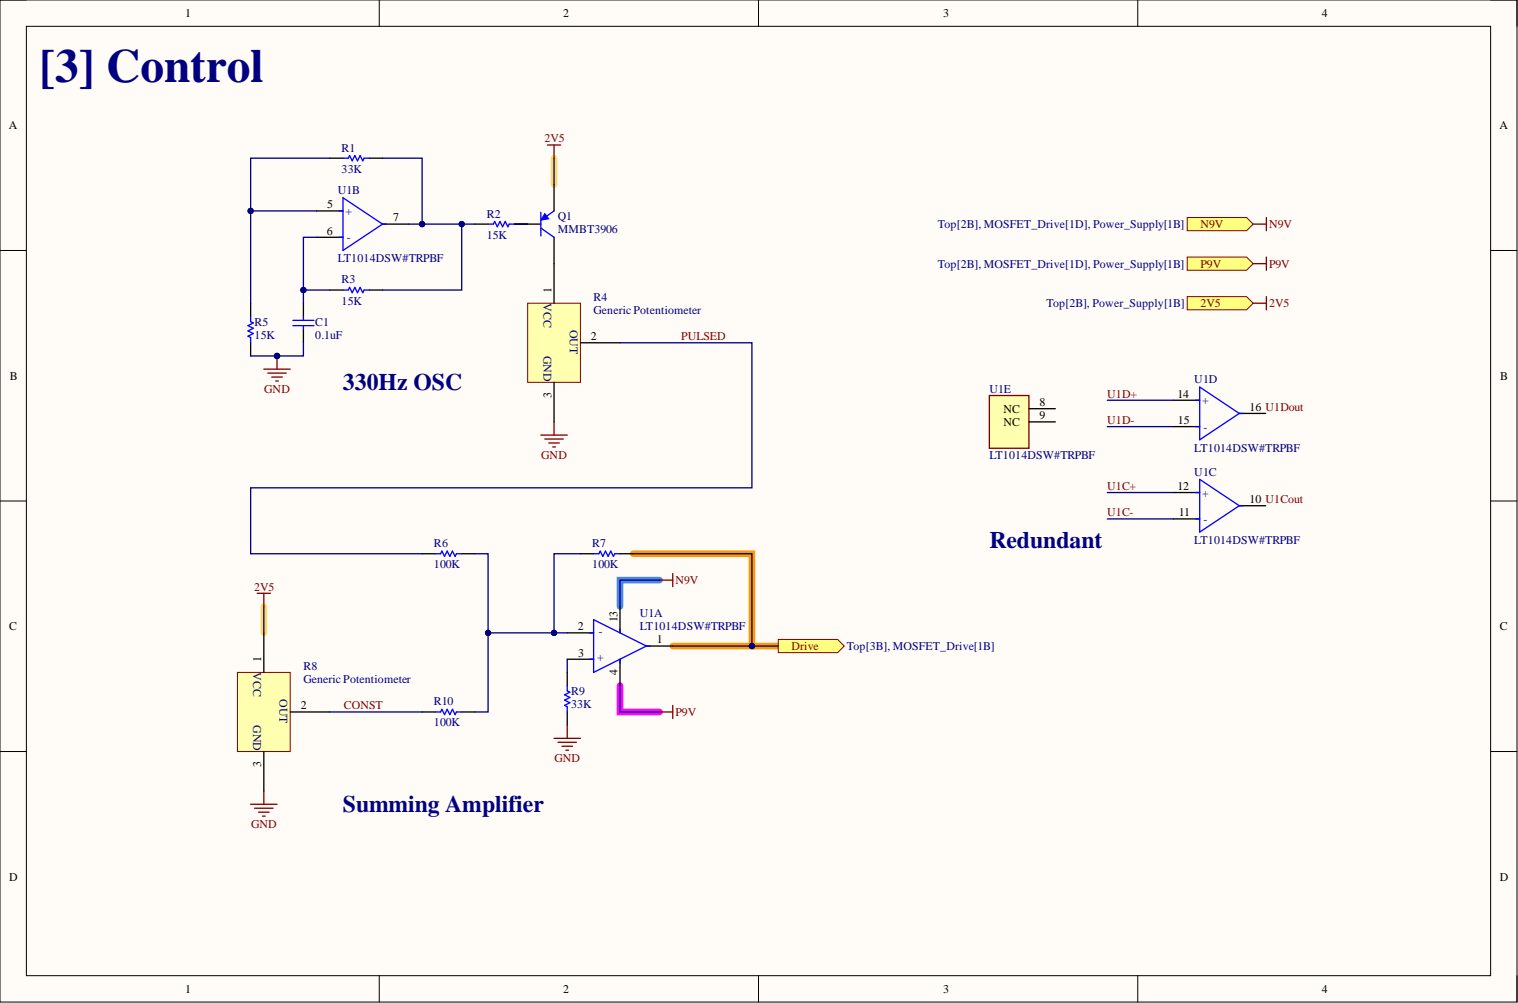
[picture p48: page 5]
