WeymenKoo/dc-electronic-load/simulation/rev_e/02_step_response/02_step_response.asc

C1: cap; 1n
C2: cap; 1n
C3: cap; 1n
C4: cap; 1n
Ca1: cap; 10n
Ca2: cap; 10n
Cset: cap; 10n
Csn: cap; 2.2u
Dh1: schottky; BAT54
Dh2: schottky; BAT54
Dk1: diode; 1N4148
Dk2: diode; 1N4148
Dk3: diode; 1N4148
Dk4: diode; 1N4148
Dl1: schottky; BAT54
Dl2: schottky; BAT54
Dz1: zener; BZX84C6V8
Dz2: zener; BZX84C6V8
Dz3: zener; BZX84C6V8
Dz4: zener; BZX84C6V8
Llead: ind; {Llead}
M1: nmos; FETSEL
M2: nmos; FETSEL
M3: nmos; FETSEL
M4: nmos; FETSEL
Ravg1: res; 10k
Ravg2: res; 10k
Ravg3: res; 10k
Ravg4: res; 10k
Rb1: res; 15Meg
Rb2: res; 15Meg
Rb3: res; 15Meg
Rb4: res; 15Meg
Rbot: res; 1k
Rf1: res; 3.3k
Rf2: res; 3.3k
Rf3: res; 3.3k
Rf4: res; 3.3k
Rfi: res; 110k
Rfuse: res; 5m
Rg1: res; 47
Rg2: res; 47
Rg3: res; 47
Rg4: res; 47
Rgi: res; 10k
Rk1: res; 4.7k
Rk2: res; 4.7k
Rk3: res; 4.7k
Rk4: res; 4.7k
Rkill: res; 10k
Rlead: res; 20m
Ro1: res; 1k
Ro2: res; 1k
Roffi: res; 1Meg
Roffv: res; 470k
Rs1: res; {Rs}
Rs2: res; {Rs}
Rs3: res; {Rs}
Rs4: res; {Rs}
Rsn: res; 2.2
Rtop: res; 15k
Rv1: res; 200k
Rv2: res; 10k
Rv3: res; 200k
Rv4: res; 10k
Sdrop: sw; SWDROP
Sotp: sw; SWOTP
U1: opamp2; TLV9152
U2: opamp2; TLV9152
U3: opamp2; TLV9152
U4: opamp2; TLV9152
U5: opamp2; TLV9152
U6: opamp2; TLV9152
V12: voltage; 12
V33: voltage; 3.3
V4096: voltage; 4.096
Vctrl: voltage; PWL(0 0.4096 100u 0.4096 101u 3.6864 400u 3.6864 401u 0.4096 700u 0.4096 701u 0.8192 1m 0.8192 1.001m 0.4096)
Vdref: voltage; 0.5
Vdut: voltage; {Vdut}
Votp: voltage; 0
Named nets: 0, LOAD_CTRL, OTP, +12V, KILL, DRAIN, VSET, G1, G2, G3, G4, S1, S2, S3, S4, AVG, +4V096, +3V3, ISEN_ADC, DUT+, VSEN_ADC
LOAD_CTRL from MCP4725
(control board, 0-4.096 V)
V_SET = LOAD_CTRL / 16
(0 - 0.256 V per channel)
Cset: 9.4 us slew filter
Sotp: LM339 #2 open-collector
over-temp pull-down
(Votp = 0 V: open)
Sdrop = LM339 #3 (open collector): holds KILL low while
V(DRAIN) > 0.5 V.  DUT absent / collapsed -> KILL = 12 V ->
Dk/Rk lift every In- -> all gates to 0 V (no wind-up).
DRAIN and KILL reach here by net label.
CH1
CH2
CH3
CH4
ISEN to STM32 ADC
(1k + 10n, clamped
 to 3V3 by BAT54S)
ISEN: AVG = mean of the 4 source voltages = I_total x Rs / 4
V(ISEN) = 0.30 V/A + 0.12 V offset (3.19 V at 10.24 A)
F1 15 A fast
(5 mR)
DUT lead pair (+ side lumped)
DUT (PSU / battery under test)
Snubber: damps
lead L vs Coss
VSEN to STM32 ADC
(1k + 10n, clamped
 to 3V3 by BAT54S)
DUT- sense
(= board GND at
the DUT- terminal)
VSEN = 0.049 x (V(DUT+) - V(DUT-)) + 0.085 V
3.0 V at 59 V, ADC clips at 65 V
Rails from the control board
(16-pin connector P1)
DC LOAD Rev E - ANALOG STAGE - 02 STEP RESPONSE
Each channel: TLV9154 (1/4, TI model = TLV9152) forces V(Sn) = V_SET, so I_ch = V_SET / Rs  (Rs = 2 x 0.2R 2512 in parallel).
Dz (6.8 V) limits wind-up; Dk/Rk let the dropout detector force the op-amp low; Rb (15Meg) = +2.6 mV offset -> 0 A at V_SET = 0.
Rf/Cc = 3.3k/1n integrator, Rg = 47R.  I_total = 4 x V_SET / 0.1 = 2.5 A per volt of LOAD_CTRL (10.24 A full scale).
.param fet=1 Rs=0.1 Vdut=24 Llead=1u
.step param fet list 1 2 3 4
.step param Llead list 1u 10u
.tran 0 1.3m 0 100n
.meas TRAN t_rise_us TRIG (I(Rs1)+I(Rs2)+I(Rs3)+I(Rs4))=2.6 RISE=1 TARG (I(Rs1)+I(Rs2)+I(Rs3)+I(Rs4))=8.4 RISE=1
.meas TRAN Ipk_up MAX (I(Rs1)+I(Rs2)+I(Rs3)+I(Rs4)) FROM 100u TO 400u
.meas TRAN I_hi FIND (I(Rs1)+I(Rs2)+I(Rs3)+I(Rs4)) AT 395u
.meas TRAN I_lo FIND (I(Rs1)+I(Rs2)+I(Rs3)+I(Rs4)) AT 95u
.meas TRAN overshoot_pct PARAM 100*(Ipk_up-I_hi)/(I_hi-I_lo)
.meas TRAN I_at_20us FIND (I(Rs1)+I(Rs2)+I(Rs3)+I(Rs4)) AT 121u
.meas TRAN I_at_50us FIND (I(Rs1)+I(Rs2)+I(Rs3)+I(Rs4)) AT 151u
.meas TRAN t_fall_us TRIG (I(Rs1)+I(Rs2)+I(Rs3)+I(Rs4))=8.4 FALL=1 TARG (I(Rs1)+I(Rs2)+I(Rs3)+I(Rs4))=2.6 FALL=1
.meas TRAN Imin_dn MIN (I(Rs1)+I(Rs2)+I(Rs3)+I(Rs4)) FROM 400u TO 700u
.meas TRAN undershoot_pct PARAM 100*(I_lo-Imin_dn)/(I_hi-I_lo)
.meas TRAN Ipk_small MAX (I(Rs1)+I(Rs2)+I(Rs3)+I(Rs4)) FROM 700u TO 1m
.meas TRAN I_small FIND (I(Rs1)+I(Rs2)+I(Rs3)+I(Rs4)) AT 995u
.meas TRAN small_overshoot_pct PARAM 100*(Ipk_small-I_small)/(I_small-I_lo)
.include ../../lib/fet_models.lib
.include ../../lib/tlv915x.lib
.model SWOTP SW(Ron=2 Roff=1G Vt=1 Vh=0)    ; LM339 + 2N7002 pull-down
.model SWDROP SW(Ron=50 Roff=1G Vt=0 Vh=50m) ; LM339 output, 50 mV hysteresis
.include ../../lib/misc_models.lib
TEST: LOAD_CTRL steps 1 A -> 9 A -> 1 A (large signal) then 1 A -> 2 A (small signal),
1 us DAC edge, DUT = 24 V with 1 uH / 10 uH leads, all four MOSFET candidates.
EXPECT: no ringing, overshoot < 5 %, 10-90 % rise in tens of us (filter + loop).
