WeymenKoo/dc-electronic-load/simulation/00_baseline_rev_b/00_baseline_rev_b.asc

C4: cap; 220p
Q1: nmos; IRF530_VTH
R1: res; 2k
R2: res; 20k
R3: res; 20k
R4: res; 2k
R5: res; 5m
R6: res; 100
R9: res; 3.3k
R12_13: res; 0.1
R16: res; 68k
R17: res; 12k
Rlead: res; 25m
U1B: UniversalOpAmp2; Avol=100k GBW=1Meg Slew=1Meg; Ilimit=40m Rail=0 Vos=0
U3A: UniversalOpAmp2; Avol=100k GBW=1Meg Slew=1Meg; Ilimit=40m Rail=0 Vos=0
V4096: voltage; 4.096
Vctrl: voltage; 0
Vdut: voltage; {Vdut}
Named nets: 0, LOAD_CTRL, Control_Voltage, +4V096, gate, Source1, Rshunt, DUT+, VSEN
BASELINE - Rev B POWER BOARD AS BUILT (Nov 2024) - why it cannot reach its own full scale
One of the two identical channels.  U3 = LMV358 powered from +4.096 V (REF5040) -> gate can never exceed ~4.1 V.
IRF530 VGS(th) is 2-4 V (datasheet) and the 0.1 R source resistor needs another 0.3-0.6 V, so the
reachable current depends on which IRF530 you got.  Op-amp = ideal rail-to-rail proxy (best case for LMV358).
VSEN amplifier as drawn: R1 (feedback) goes to the
NON-inverting input and R4 to the inverting input.
Positive feedback -> output latches to a rail.
Correct: swap the R1 and R4 connections.
.param Vdut=12 vth=3
.model IRF530_VTH VDMOS(Rg=3 Vto={vth} Rd=50m Rs=12m Rb=60m Kp=5 lambda=.01 Cgdmax=1n Cgdmin=.26n Cgs=.2n Cjo=.4n Is=52p ksubthres=.1 Vds=100)
.step param vth list 2 3 4   ; IRF530 VGS(th) min / mid / max
.dc Vctrl 0 4.096 8m
.meas DC I_FS FIND Id(Q1) AT 4.096
.meas DC I_target PARAM 4.096*12/80/0.1
.meas DC Vgate_FS FIND V(gate) AT 4.096
.meas DC VSEN_out FIND V(VSEN) AT 2
.meas DC VSEN_correct PARAM 0.1*12
