WeymenKoo/dc-electronic-load/simulation/rev_e/03_loop_gain/03_loop_gain.asc

C1: cap; 1n
Csn: cap; 2.2u
Dz1: zener; BZX84C6V8
Llead: ind; {Llead}
M1: nmos; FETSEL
Rb1: res; 15Meg
Rf1: res; 3.3k
Rg1: res; 47
Rlead: res; 20m
Rs1: res; {Rs}
Rsn: res; 2.2
U1: opamp2; TLV9152
V12: voltage; 12
Vdut: voltage; {Vdut}
Vinj: voltage; AC 1
Vset: voltage; {Ich*Rs}
Named nets: +12V, 0, G1, VSET, inj, src, drain
DC LOAD Rev E - ONE CURRENT-SINK CHANNEL - LOOP GAIN (Middlebrook voltage injection)
Vinj breaks the loop between the source node (low Z, 0.1 R) and Rf (3.3k): ideal injection point.
T(f) = -V(src)/V(inj).  In the log: PM = phase of V(src)/V(inj) at fc;  GM = -|V(src)/V(inj)| where its phase = 0.
DUT model: supply + 20 mR lead +
lead inductance (1 uH ~ 1 m of
loose lead pair, 10 uH = abuse)
PASS criteria: PM >= 45 deg and GM >= 10 dB for every FET candidate, channel current
50 mA ... 2.5 A and 1 ... 10 uH leads.  Rf=3.3k, Cc=1n, Rg=47 chosen from this sweep.
.param fet=1 Ich=2.5 Llead=1u Vdut=24 Rs=0.1
.step param fet list 1 2 3 4   ; 1 IRFP250N  2 IRFP240  3 IRF530  4 IXTH88N30P (big-die proxy)
.step param Ich list 0.05 0.25 2.5
.step param Llead list 1u 10u
.ac dec 50 10 10Meg
.meas AC fc WHEN mag(V(src)/V(inj))=1
.meas AC PM FIND V(src)/V(inj) AT fc
.meas AC GM FIND V(src)/V(inj) WHEN ph(V(src)/V(inj))=0
.include ../../lib/fet_models.lib
.include ../../lib/misc_models.lib
.include ../../lib/tlv915x.lib
