WeymenKoo/dc-electronic-load/simulation/rev_e/04_faults/04_faults.asc

C1: cap; 1n
C2: cap; 1n
C3: cap; 1n
C4: cap; 1n
Ca1: cap; 10n
Ca2: cap; 10n
Cset: cap; 10n
Csn: cap; 2.2u
Dh1: schottky; BAT54
Dh2: schottky; BAT54
Dk1: diode; 1N4148
Dk2: diode; 1N4148
Dk3: diode; 1N4148
Dk4: diode; 1N4148
Dl1: schottky; BAT54
Dl2: schottky; BAT54
Dz1: zener; BZX84C6V8
Dz2: zener; BZX84C6V8
Dz3: zener; BZX84C6V8
Dz4: zener; BZX84C6V8
Llead: ind; {Llead}
M1: nmos; FETSEL
M2: nmos; FETSEL
M3: nmos; FETSEL
M4: nmos; FETSEL
Ravg1: res; 10k
Ravg2: res; 10k
Ravg3: res; 10k
Ravg4: res; 10k
Rb1: res; 15Meg
Rb2: res; 15Meg
Rb3: res; 15Meg
Rb4: res; 15Meg
Rbot: res; 1k
Rf1: res; 3.3k
Rf2: res; 3.3k
Rf3: res; 3.3k
Rf4: res; 3.3k
Rfi: res; 110k
Rfuse: res; 5m
Rg1: res; 47
Rg2: res; 47
Rg3: res; 47
Rg4: res; 47
Rgi: res; 10k
Rk1: res; 4.7k
Rk2: res; 4.7k
Rk3: res; 4.7k
Rk4: res; 4.7k
Rkill: res; 10k
Rlead: res; 20m
Ro1: res; 1k
Ro2: res; 1k
Roffi: res; 1Meg
Roffv: res; 470k
Rs1: res; {Rs}
Rs2: res; {Rs}
Rs3: res; {Rs}
Rs4: res; {Rs}
Rsn: res; 2.2
Rtop: res; 15k
Rv1: res; 200k
Rv2: res; 10k
Rv3: res; 200k
Rv4: res; 10k
Sdrop: sw; SWDROP
Sotp: sw; SWOTP
U1: opamp2; TLV9152
U2: opamp2; TLV9152
U3: opamp2; TLV9152
U4: opamp2; TLV9152
U5: opamp2; TLV9152
U6: opamp2; TLV9152
V12: voltage; 12
V33: voltage; 3.3
V4096: voltage; 4.096
Vctrl: voltage; 3.2768
Vdref: voltage; 0.5
Vdut: voltage; PWL(0 0 200u 0 201u 24 1m 24 1.001m 0.4 1.5m 0.4 1.501m 24 3.5m 24)
Votp: voltage; PWL(0 0 2.5m 0 2.501m 5 3m 5 3.001m 0)
Named nets: 0, LOAD_CTRL, OTP, +12V, KILL, DRAIN, VSET, G1, G2, G3, G4, S1, S2, S3, S4, AVG, +4V096, +3V3, ISEN_ADC, DUT+, VSEN_ADC
LOAD_CTRL from MCP4725
(control board, 0-4.096 V)
V_SET = LOAD_CTRL / 16
(0 - 0.256 V per channel)
Cset: 9.4 us slew filter
Sotp: LM339 #2 open-collector
over-temp pull-down
(Votp = 0 V: open)
Sdrop = LM339 #3 (open collector): holds KILL low while
V(DRAIN) > 0.5 V.  DUT absent / collapsed -> KILL = 12 V ->
Dk/Rk lift every In- -> all gates to 0 V (no wind-up).
DRAIN and KILL reach here by net label.
CH1
CH2
CH3
CH4
ISEN to STM32 ADC
(1k + 10n, clamped
 to 3V3 by BAT54S)
ISEN: AVG = mean of the 4 source voltages = I_total x Rs / 4
V(ISEN) = 0.30 V/A + 0.12 V offset (3.19 V at 10.24 A)
F1 15 A fast
(5 mR)
DUT lead pair (+ side lumped)
DUT (PSU / battery under test)
Snubber: damps
lead L vs Coss
VSEN to STM32 ADC
(1k + 10n, clamped
 to 3V3 by BAT54S)
DUT- sense
(= board GND at
the DUT- terminal)
VSEN = 0.049 x (V(DUT+) - V(DUT-)) + 0.085 V
3.0 V at 59 V, ADC clips at 65 V
Rails from the control board
(16-pin connector P1)
DC LOAD Rev E - ANALOG STAGE - 04 FAULT CASES
Set point fixed at 8 A (LOAD_CTRL = 3.2768 V).  Timeline:
 0.2 ms  DUT hot-plugged with the load already enabled (0 -> 24 V in 1 us)
 1.0 ms  DUT collapses to 0.4 V for 0.5 ms (op-amps rail high = integrator wind-up)
 1.5 ms  DUT recovers to 24 V in 1 us  -> current overshoot from wind-up
 2.5 ms  over-temperature trip pulls V_SET to 0 for 0.5 ms
.param fet=1 Rs=0.1 Llead=1u
.step param fet list 1 2 3 4
.tran 0 3.5m 0 100n
.meas TRAN Ipk_hotplug MAX (I(Rs1)+I(Rs2)+I(Rs3)+I(Rs4)) FROM 200u TO 1m
.meas TRAN I_during_dropout FIND (I(Rs1)+I(Rs2)+I(Rs3)+I(Rs4)) AT 1.4m
.meas TRAN Ipk_recovery MAX (I(Rs1)+I(Rs2)+I(Rs3)+I(Rs4)) FROM 1.5m TO 2.4m
.meas TRAN I_rec_20us FIND (I(Rs1)+I(Rs2)+I(Rs3)+I(Rs4)) AT 1.521m
.meas TRAN I_rec_100us FIND (I(Rs1)+I(Rs2)+I(Rs3)+I(Rs4)) AT 1.601m
.meas TRAN Epk_recovery_mJ INTEG 1000*V(DRAIN)*(I(Rs1)+I(Rs2)+I(Rs3)+I(Rs4)) FROM 1.5m TO 1.7m
.meas TRAN t_otp_off TRIG V(OTP)=1 RISE=1 TARG (I(Rs1)+I(Rs2)+I(Rs3)+I(Rs4))=0.8 TD=2.5m FALL=1
.meas TRAN I_otp FIND (I(Rs1)+I(Rs2)+I(Rs3)+I(Rs4)) AT 2.9m
.include ../../lib/fet_models.lib
.include ../../lib/tlv915x.lib
.model SWOTP SW(Ron=2 Roff=1G Vt=1 Vh=0)    ; LM339 + 2N7002 pull-down
.model SWDROP SW(Ron=50 Roff=1G Vt=0 Vh=50m) ; LM339 output, 50 mV hysteresis
.include ../../lib/misc_models.lib
EXPECT: hot-plug overshoot small; dropout recovery shows wind-up overshoot (quantified in log);
OTP pull-down turns all 4 channels off within ~tens of us.
