WeymenKoo/dc-electronic-load/simulation/rev_e/06_cv_mode/06_cv_mode.asc

C1: cap; 1n
C2: cap; 1n
C3: cap; 1n
C4: cap; 1n
Ca1: cap; 10n
Ca2: cap; 10n
Ccv: cap; 47n
Cdut: cap; {Cx}
Cset: cap; 10n
Csn: cap; 2.2u
Dcomp: diode; DCL
Dh1: schottky; BAT54
Dh2: schottky; BAT54
Dk1: diode; 1N4148
Dk2: diode; 1N4148
Dk3: diode; 1N4148
Dk4: diode; 1N4148
Dl1: schottky; BAT54
Dl2: schottky; BAT54
Dz1: zener; BZX84C6V8
Dz2: zener; BZX84C6V8
Dz3: zener; BZX84C6V8
Dz4: zener; BZX84C6V8
Idut: current; PWL(0 {Isrc} 60m {Isrc} 60.01m {1.1*Isrc})
Llead: ind; {Llead}
M1: nmos; FETSEL
M2: nmos; FETSEL
M3: nmos; FETSEL
M4: nmos; FETSEL
Mcv: nmos; M2N7002
Ravg1: res; 10k
Ravg2: res; 10k
Ravg3: res; 10k
Ravg4: res; 10k
Rb1: res; 15Meg
Rb2: res; 15Meg
Rb3: res; 15Meg
Rb4: res; 15Meg
Rbot: res; 1k
Rcv1: res; 100k
Rcv2: res; 10k
Rcvg: res; 1k
Rf1: res; 3.3k
Rf2: res; 3.3k
Rf3: res; 3.3k
Rf4: res; 3.3k
Rfi: res; 110k
Rfuse: res; 5m
Rg1: res; 47
Rg2: res; 47
Rg3: res; 47
Rg4: res; 47
Rgi: res; 10k
Rk1: res; 4.7k
Rk2: res; 4.7k
Rk3: res; 4.7k
Rk4: res; 4.7k
Rkill: res; 10k
Rlead: res; 20m
Ro1: res; 1k
Ro2: res; 1k
Roffi: res; 1Meg
Roffv: res; 470k
Rs1: res; {Rs}
Rs2: res; {Rs}
Rs3: res; {Rs}
Rs4: res; {Rs}
Rsn: res; 2.2
Rtop: res; 15k
Rv1: res; 200k
Rv2: res; 10k
Rv3: res; 200k
Rv4: res; 10k
Sdrop: sw; SWDROP
Sotp: sw; SWOTP
U1: opamp2; TLV9152
U2: opamp2; TLV9152
U3: opamp2; TLV9152
U4: opamp2; TLV9152
U5: opamp2; TLV9152
U6: opamp2; TLV9152
U7: opamp2; TLV9152
V12: voltage; 12
V33: voltage; 3.3
V4096: voltage; 4.096
Vcomp: voltage; 30
Vctrl: voltage; PWL(0 0 5m 0 25m 4.096)
Vcv: voltage; PWL(0 {12*0.049+0.0854} 100m {12*0.049+0.0854} 100.1m {10*0.049+0.0854})
Vdref: voltage; 0.5
Votp: voltage; 0
Named nets: 0, LOAD_CTRL, OTP, +12V, KILL, DRAIN, VSET, G1, G2, G3, G4, S1, S2, S3, S4, AVG, +4V096, +3V3, ISEN_ADC, DUT+, VSEN_ADC, VSEN_OA, QG, CVSET
LOAD_CTRL from MCP4725
(control board, 0-4.096 V)
V_SET = LOAD_CTRL / 16
(0 - 0.256 V per channel)
Cset: 9.4 us slew filter
Sotp: LM339 #2 open-collector
over-temp pull-down
(Votp = 0 V: open)
Sdrop = LM339 #3 (open collector): holds KILL low while
V(DRAIN) > 0.5 V.  DUT absent / collapsed -> KILL = 12 V ->
Dk/Rk lift every In- -> all gates to 0 V (no wind-up).
DRAIN and KILL reach here by net label.
CH1
CH2
CH3
CH4
ISEN to STM32 ADC
(1k + 10n, clamped
 to 3V3 by BAT54S)
ISEN: AVG = mean of the 4 source voltages = I_total x Rs / 4
V(ISEN) = 0.30 V/A + 0.12 V offset (3.19 V at 10.24 A)
F1 15 A fast
(5 mR)
DUT lead pair (+ side lumped)
DUT (PSU / battery under test)
Snubber: damps
lead L vs Coss
VSEN to STM32 ADC
(1k + 10n, clamped
 to 3V3 by BAT54S)
DUT- sense
(= board GND at
the DUT- terminal)
VSEN = 0.049 x (V(DUT+) - V(DUT-)) + 0.085 V
3.0 V at 59 V, ADC clips at 65 V
Rails from the control board
(16-pin connector P1)
DC LOAD Rev E - ANALOG STAGE - 06 HARDWARE CV MODE (current-source DUT)
Each channel: TLV9154 (1/4, TI model = TLV9152) forces V(Sn) = V_SET, so I_ch = V_SET / Rs  (Rs = 2 x 0.2R 2512 in parallel).
Dz (6.8 V) limits wind-up; Dk/Rk let the dropout detector force the op-amp low; Rb (15Meg) = +2.6 mV offset -> 0 A at V_SET = 0.
Rf/Cc = 3.3k/1n integrator, Rg = 47R.  I_total = 4 x V_SET / 0.1 = 2.5 A per volt of LOAD_CTRL (10.24 A full scale).
CV: V_DUT below CV_SET -> U7 output rises -> Mcv pulls V_SET down -> load sinks less. CV_SET = 0: U7 low, Mcv off, plain CC.
.param fet=1 Rs=0.1 Llead=1u
.step param Cx list 1p 47u
.step param Isrc list 0.1 1 8
.tran 0 150m 0 10u
.meas TRAN v_12V FIND V(DUT+) AT 59m
.meas TRAN vpp_12V PP V(DUT+) FROM 50m TO 59m
.meas TRAN vpk_Istep MAX V(DUT+) FROM 60m TO 99m
.meas TRAN v_after_Istep FIND V(DUT+) AT 99m
.meas TRAN v_10V FIND V(DUT+) AT 149m
.meas TRAN vpp_10V PP V(DUT+) FROM 140m TO 149m
.meas TRAN Iload FIND (I(Rs1)+I(Rs2)+I(Rs3)+I(Rs4)) AT 149m
.model M2N7002 VDMOS(Rg=3 Vto=1.6 Rd=0.2 Rs=0.5 Kp=0.16 Cgdmax=30p Cgdmin=5p Cgs=20p Cjo=10p Is=1p ksubthres=.1)
.model DCL D(Is=1n N=0.1 Rs=1)
.include ../../lib/fet_models.lib
.include ../../lib/tlv915x.lib
.model SWOTP SW(Ron=2 Roff=1G Vt=1 Vh=0)    ; LM339 + 2N7002 pull-down
.model SWDROP SW(Ron=50 Roff=1G Vt=0 Vh=50m) ; LM339 output, 50 mV hysteresis
.include ../../lib/misc_models.lib
TEST: current-source DUT (30 V compliance) with CV set to 12 V, LOAD_CTRL ramped 0 -> full scale over 20 ms.
At 60 ms the source steps +10 %, at 100 ms CV_SET steps to 10 V.
EXPECT: V(DUT+) settles to the CV setting with no sustained oscillation for 0.1 - 8 A, with and without 47 uF across the DUT.
