WeymenKoo/dc-electronic-load/(list of files, drawings)

Other design files:
archive/rev_a2_2024-07_cheaper_altium/CHEAPER Dc load.PrjPcb
archive/rev_a2_2024-07_cheaper_altium/Control.SchDoc
archive/rev_a2_2024-07_cheaper_altium/DCLoad.PcbDoc
archive/rev_a2_2024-07_cheaper_altium/Digital IO.SchDoc
archive/rev_a2_2024-07_cheaper_altium/Interface.SchDoc
archive/rev_a2_2024-07_cheaper_altium/MOSFET_Drive.SchDoc
archive/rev_a2_2024-07_cheaper_altium/Power_Supply.SchDoc
archive/rev_a2_2024-07_cheaper_altium/Top.SchDoc
archive/rev_a_2024-05_altium/DCLoad.PcbDoc
archive/rev_a_2024-05_altium/DCLoad.PrjPcb
archive/rev_a_2024-05_altium/ElectronicLoad.SchDoc
archive/rev_a_2024-05_altium/Microcontroller.SchDoc
archive/rev_a_2024-05_altium/Peripherals.SchDoc
archive/rev_a_2024-05_altium/PowerDistribution.SchDoc
archive/rev_a_2024-05_altium/RemoteVsense.SchDoc
archive/rev_b_2024-11_control_board_altium/DAC.SchDoc
archive/rev_b_2024-11_control_board_altium/DC Electronic Load Redemption Edition.PrjPcb
archive/rev_b_2024-11_control_board_altium/DC Load Control Board.PcbDoc
archive/rev_b_2024-11_control_board_altium/Microcontroller.SchDoc
archive/rev_b_2024-11_control_board_altium/Power Distribution.SchDoc
archive/rev_b_2024-11_control_board_altium/Thermal.SchDoc
archive/rev_b_2024-11_control_board_altium/Top.SchDoc
archive/rev_b_2024-11_power_board_altium/DC Electronic Load Power MOSFETS.PrjPcb
archive/rev_b_2024-11_power_board_altium/IO.SchDoc
archive/rev_b_2024-11_power_board_altium/MOSFETs.SchDoc
archive/rev_b_2024-11_power_board_altium/Power Electronics.PcbDoc
archive/rev_b_2024-11_power_board_altium/Power Monitor.SchDoc
archive/rev_b_2024-11_power_board_altium/Top.SchDoc
archive/rev_b_2024-11_ui_board_altium/DC Electronic Load UI Board.PrjPcb
archive/rev_b_2024-11_ui_board_altium/User_IO.SchDoc
