WeymenKoo/dc-electronic-load/hardware/rev_e/DC_Load_RevE.kicad_pcb

## KiCad design hardware/rev_e/DC_Load_RevE.kicad_pcb (2026-11-03)

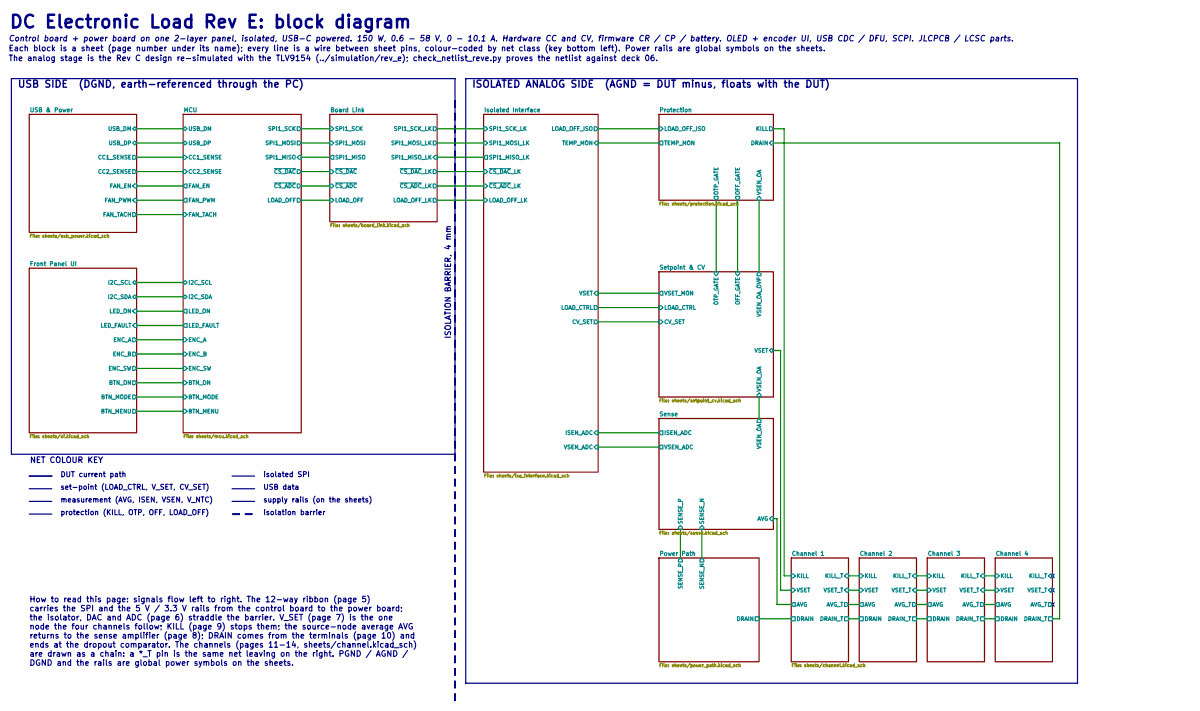
[picture p49: schematic DC_Load_RevE.kicad_sch, DC Electronic Load Rev E: block diagram]

Notes on the sheet:
DC Electronic Load Rev E: block diagram
Control board + power board on one 2-layer panel, isolated, USB-C powered. 150 W, 0.6 - 58 V, 0 - 10.1 A. Hardware CC and CV, firmware CR / CP / battery. OLED + encoder UI, USB CDC / DFU, SCPI. JLCPCB / LCSC parts.
Each block is a sheet (page number under its name); every line is a wire between sheet pins, colour-coded by net class (key bottom left). Power rails are global symbols on the sheets.
The analog stage is the Rev C design re-simulated with the TLV9154 (../simulation/rev_e); check_netlist_reve.py proves the netlist against deck 06.
USB SIDE (DGND, earth-referenced through the PC)
ISOLATED ANALOG SIDE (AGND = DUT minus, floats with the DUT)
ISOLATION BARRIER, 4 mm
NET COLOUR KEY
DUT current path
set-point (LOAD_CTRL, V_SET, CV_SET)
measurement (AVG, ISEN, VSEN, V_NTC)
protection (KILL, OTP, OFF, LOAD_OFF)
isolated SPI
USB data
supply rails (on the sheets)
isolation barrier
How to read this page: signals flow left to right. The 12-way ribbon (page 5) carries the SPI and the 5 V / 3.3 V rails from the control board to the power board; the isolator, DAC and ADC (page 6) straddle the barrier. V_SET (page 7) is the one node the four channels follow; KILL (page 9) stops th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

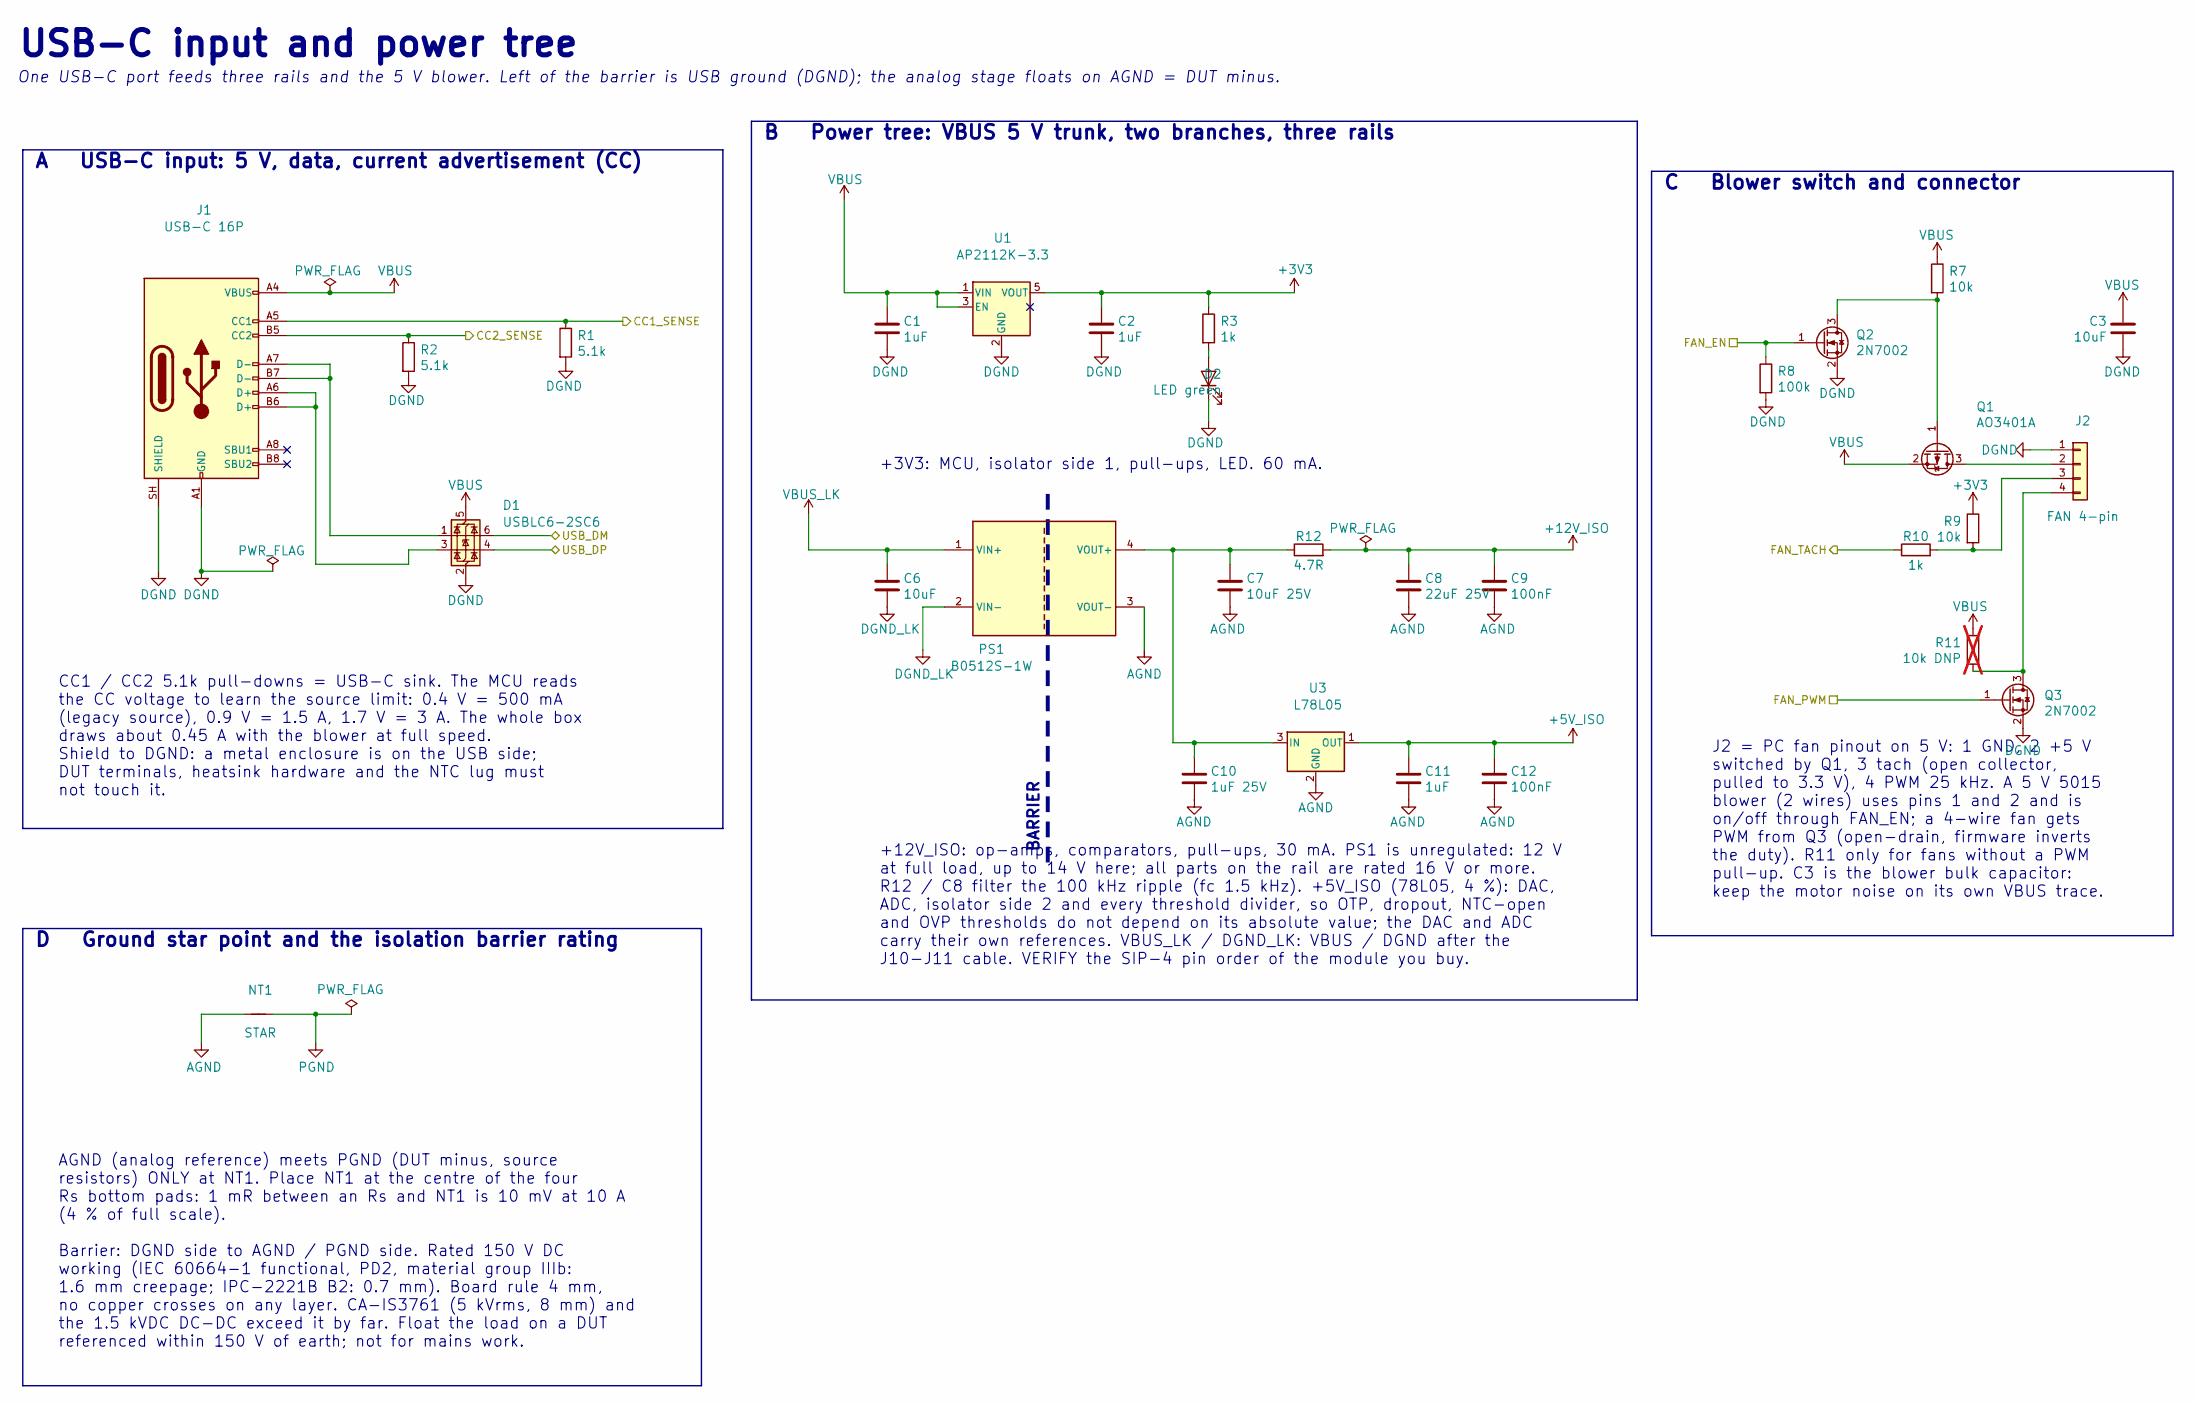
[picture p50: schematic usb_power.kicad_sch, USB-C input and power tree]

Parts:
C1, C2, C11: 1uF; C_0603_1608Metric
C3, C6: 10uF; C_0805_2012Metric
C7: 10uF 25V; C_0805_2012Metric
C8: 22uF 25V; C_1206_3216Metric
C9, C12: 100nF; C_0603_1608Metric
C10: 1uF 25V; C_0603_1608Metric
D1: USBLC6-2SC6; SOT-23-6; LCSC C5261088
D2: LED green; LED_0603_1608Metric; MPN KT-0603G; LCSC C12624
J1: USB-C 16P; USB_C_Receptacle_HRO_TYPE-C-31-M-12; MPN HRO TYPE-C-31-M-12 (16 pin, USB 2.0); LCSC C165948
J2: FAN 4-pin; JST_XH_B4B-XH-A_1x04_P2.50mm_Vertical; MPN JST B4B-XH-A(LF)(SN); LCSC C144395
NT1: STAR; NetTie-2_SMD_Pad2.0mm
PS1: B0512S-1W; SIP-4_P2.54mm_DCDC_1W; MPN DEXU B0512S-1W (LCSC C5244116, 1.5 kV);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; LCSC C5244116
Q1: AO3401A; SOT-23; LCSC C15127
Q2, Q3: 2N7002; SOT-23; LCSC C8545
R1, R2: 5.1k; R_0603_1608Metric; Tolerance 1%
R3, R10: 1k; R_0603_1608Metric
R7, R9: 10k; R_0603_1608Metric
R8: 100k; R_0603_1608Metric
R11: 10k DNP; R_0603_1608Metric; not fitted
R12: 4.7R; R_1206_3216Metric
U1: AP2112K-3.3; SOT-23-5; LCSC C23380830
U3: L78L05; SOT-89-3; MPN L78L05ABUTR (SOT-89); LCSC C42738

Connections:
+3V3: C2.1, R3.1, R9.1, U1.5 (VOUT); also elsewhere on the board
+5V_ISO: C11.1, C12.1, U3.1 (OUT); also elsewhere on the board
+12V_ISO: C8.1, C9.1, R12.2; also elsewhere on the board
/MCU/CC1_SENSE: J1.A5 (CC1), R1.1; also elsewhere on the board
/MCU/CC2_SENSE: J1.B5 (CC2), R2.1; also elsewhere on the board
/MCU/FAN_EN: Q2.1 (G), R8.1; also elsewhere on the board
/MCU/FAN_PWM: Q3.1 (G); also elsewhere on the board
/MCU/FAN_TACH: R10.1; also elsewhere on the board
/MCU/USB_DM: D1.6 (I/O1); also elsewhere on the board
/MCU/USB_DP: D1.4 (I/O2); also elsewhere on the board
AGND: C7.2, C8.2, C9.2, C10.2, C11.2, C12.2, NT1.1, PS1.3 (VOUT-), U3.2 (GND); also elsewhere on the board
DGND: C1.2, C2.2, C3.2, D1.2 (GND), D2.1 (K), J1.A1 (GND), J1.A12 (GND), J1.B1 (GND), J1.B12 (GND), J1.SH (SHIELD), J2.1, Q2.2 (S), Q3.2 (S), R1.2, R2.2, R8.2, U1.2 (GND); also elsewhere on the board
DGND_LK: C6.2, PS1.2 (VIN-); also elsewhere on the board
unnamed: D1.1 (I/O1), J1.A7 (D-), J1.B7 (D-)
unnamed: D1.3 (I/O2), J1.A6 (D+), J1.B6 (D+)
unnamed: D2.2 (A), R3.2
unnamed: J2.2, Q1.3 (D)
unnamed: J2.3, R9.2, R10.2
unnamed: J2.4, Q3.3 (D), R11.2
unnamed: C7.1, C10.1, PS1.4 (VOUT+), R12.1, U3.3 (IN)
unnamed: Q1.1 (G), Q2.3 (D), R7.2
PGND: NT1.2; also elsewhere on the board
VBUS: C1.1, C3.1, D1.5 (VBUS), J1.A4 (VBUS), J1.A9 (VBUS), J1.B4 (VBUS), J1.B9 (VBUS), Q1.2 (S), R7.1, R11.1, U1.1 (VIN), U1.3 (EN); also elsewhere on the board
VBUS_LK: C6.1, PS1.1 (VIN+); also elsewhere on the board

Notes on the sheet:
USB-C input and power tree
One USB-C port feeds three rails and the 5 V blower. Left of the barrier is USB ground (DGND); the analog stage floats on AGND = DUT minus.
CC1 / CC2 5.1k pull-downs = USB-C sink. The MCU reads the CC voltage to learn the source limit: 0.4 V = 500 mA (legacy source), 0.9 V = 1.5 A, 1.7 V = 3 A. The whole box draws about 0.45 A with the blower at full speed. Shield to DGND: a metal enclosure is on the USB side; DUT terminals, heatsink h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
A USB-C input: 5 V, data, current advertisement (CC)
AGND (analog reference) meets PGND (DUT minus, source resistors) ONLY at NT1. Place NT1 at the centre of the four Rs bottom pads: 1 mR between an Rs and NT1 is 10 mV at 10 A (4 % of full scale). Barrier: DGND side to AGND / PGND side. Rated 150 V DC working (IEC 60664-1 functional, PD2, material gr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
D Ground star point and the isolation barrier rating
+3V3: MCU, isolator side 1, pull-ups, LED. 60 mA.
BARRIER
+12V_ISO: op-amps, comparators, pull-ups, 30 mA. PS1 is unregulated: 12 V at full load, up to 14 V here; all parts on the rail are rated 16 V or more. R12 / C8 filter the 100 kHz ripple (fc 1.5 kHz). +5V_ISO (78L05, 4 %): DAC, ADC, isolator side 2 and every threshold divider, so OTP, dropout, NTC-o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
B Power tree: VBUS 5 V trunk, two branches, three rails
J2 = PC fan pinout on 5 V: 1 GND, 2 +5 V switched by Q1, 3 tach (open collector, pulled to 3.3 V), 4 PWM 25 kHz. A 5 V 5015 blower (2 wires) uses pins 1 and 2 and is on/off through FAN_EN; a 4-wire fan gets PWM from Q3 (open-drain, firmware inverts the duty). R11 only for fans without a PWM pull-up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
C Blower switch and connector

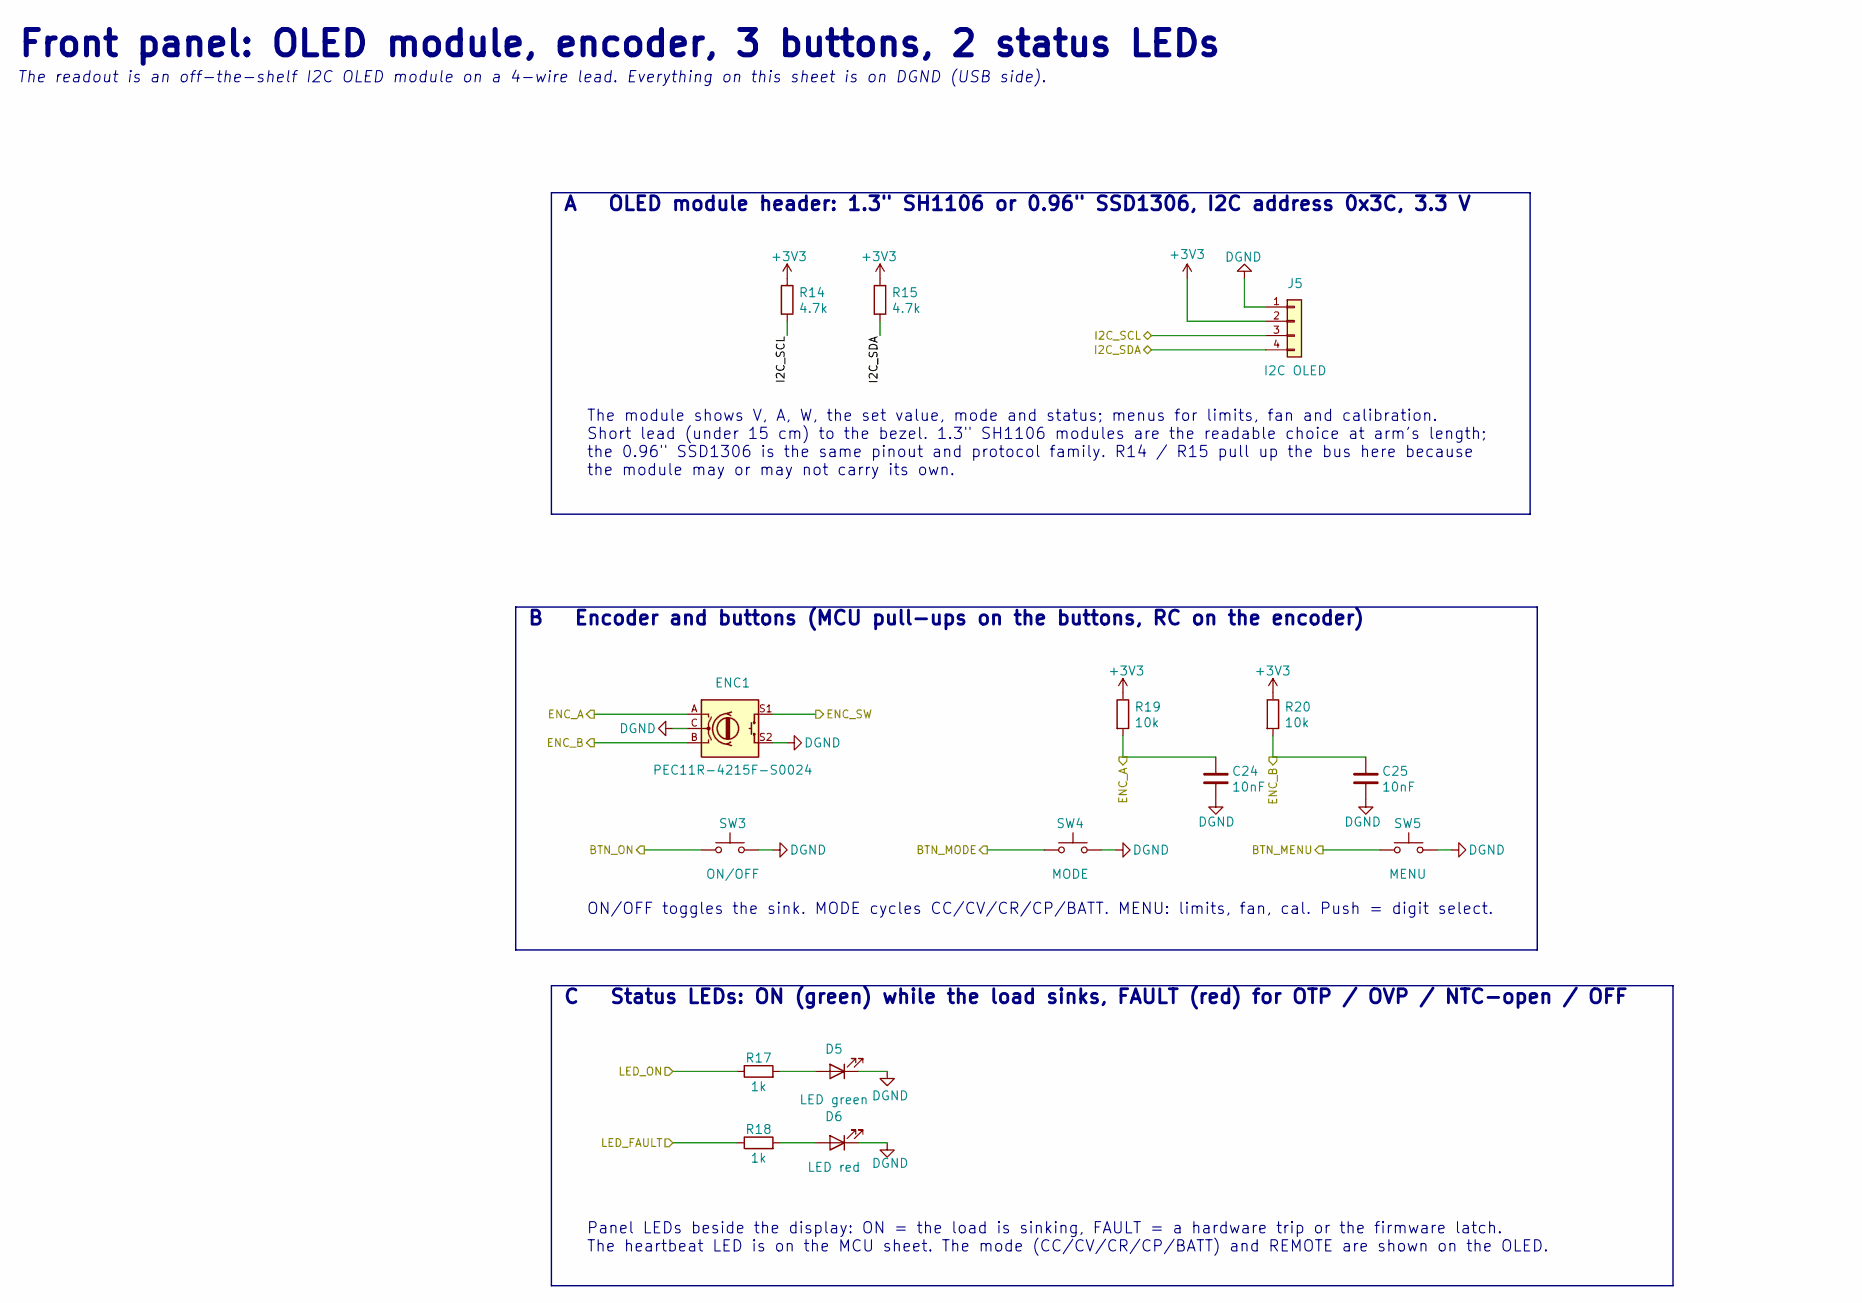
[picture p51: schematic ui.kicad_sch, Front panel: OLED module, encoder, 3 buttons, 2 status LEDs]

Parts:
C24, C25: 10nF; C_0603_1608Metric
D5: LED green; LED_0603_1608Metric; MPN KT-0603N; LCSC C12624
D6: LED red; LED_0603_1608Metric; MPN KT-0603D; LCSC C2286
ENC1: PEC11R-4215F-S0024; RotaryEncoder_Alps_EC11E-Switch_Vertical_H20mm; MPN Bourns PEC11R-4215F-S0024 (24 detents, 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; LCSC C143790
J5: I2C OLED; PinHeader_1x04_P2.54mm_Vertical; MPN B-2100S04P-A110 (the OLED module itself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; LCSC C124378
R14, R15: 4.7k; R_0603_1608Metric
R17, R18: 1k; R_0603_1608Metric
R19, R20: 10k; R_0603_1608Metric
SW3: ON/OFF; SW_PUSH_6mm; MPN KH-6X6X5H-TJ 6 x 6 mm tact switch; LCSC C2837515
SW4: MODE; SW_PUSH_6mm; MPN KH-6X6X5H-TJ 6 x 6 mm tact switch; LCSC C2837515
SW5: MENU; SW_PUSH_6mm; MPN KH-6X6X5H-TJ 6 x 6 mm tact switch; LCSC C2837515

Connections:
+3V3: J5.2, R14.1, R15.1, R19.1, R20.1; also elsewhere on the board
/Front Panel UI/BTN_MENU: SW5.1; also elsewhere on the board
/Front Panel UI/BTN_MODE: SW4.1; also elsewhere on the board
/Front Panel UI/BTN_ON: SW3.1; also elsewhere on the board
/Front Panel UI/ENC_A: C24.1, ENC1.A, R19.2; also elsewhere on the board
/Front Panel UI/ENC_B: C25.1, ENC1.B, R20.2; also elsewhere on the board
/Front Panel UI/ENC_SW: ENC1.S1; also elsewhere on the board
/Front Panel UI/I2C_SCL: J5.3, R14.2; also elsewhere on the board
/Front Panel UI/I2C_SDA: J5.4, R15.2; also elsewhere on the board
/Front Panel UI/LED_FAULT: R18.1; also elsewhere on the board
/Front Panel UI/LED_ON: R17.1; also elsewhere on the board
DGND: C24.2, C25.2, D5.1 (K), D6.1 (K), ENC1.C, ENC1.S2, J5.1, SW3.2, SW4.2, SW5.2; also elsewhere on the board
unnamed: D5.2 (A), R17.2
unnamed: D6.2 (A), R18.2

Notes on the sheet:
Front panel: OLED module, encoder, 3 buttons, 2 status LEDs
The readout is an off-the-shelf I2C OLED module on a 4-wire lead. Everything on this sheet is on DGND (USB side).
The module shows V, A, W, the set value, mode and status; menus for limits, fan and calibration. Short lead (under 15 cm) to the bezel. 1.3" SH1106 modules are the readable choice at arm's length; the 0.96" SSD1306 is the same pinout and protocol family. R14 / R15 pull up the bus here because the m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
A OLED module header: 1.3" SH1106 or 0.96" SSD1306, I2C address 0x3C, 3.3 V
ON/OFF toggles the sink. MODE cycles CC/CV/CR/CP/BATT. MENU: limits, fan, cal. Push = digit select.
B Encoder and buttons (MCU pull-ups on the buttons, RC on the encoder)
Panel LEDs beside the display: ON = the load is sinking, FAULT = a hardware trip or the firmware latch. The heartbeat LED is on the MCU sheet. The mode (CC/CV/CR/CP/BATT) and REMOTE are shown on the OLED.
C Status LEDs: ON (green) while the load sinks, FAULT (red) for OTP / OVP / NTC-open / OFF

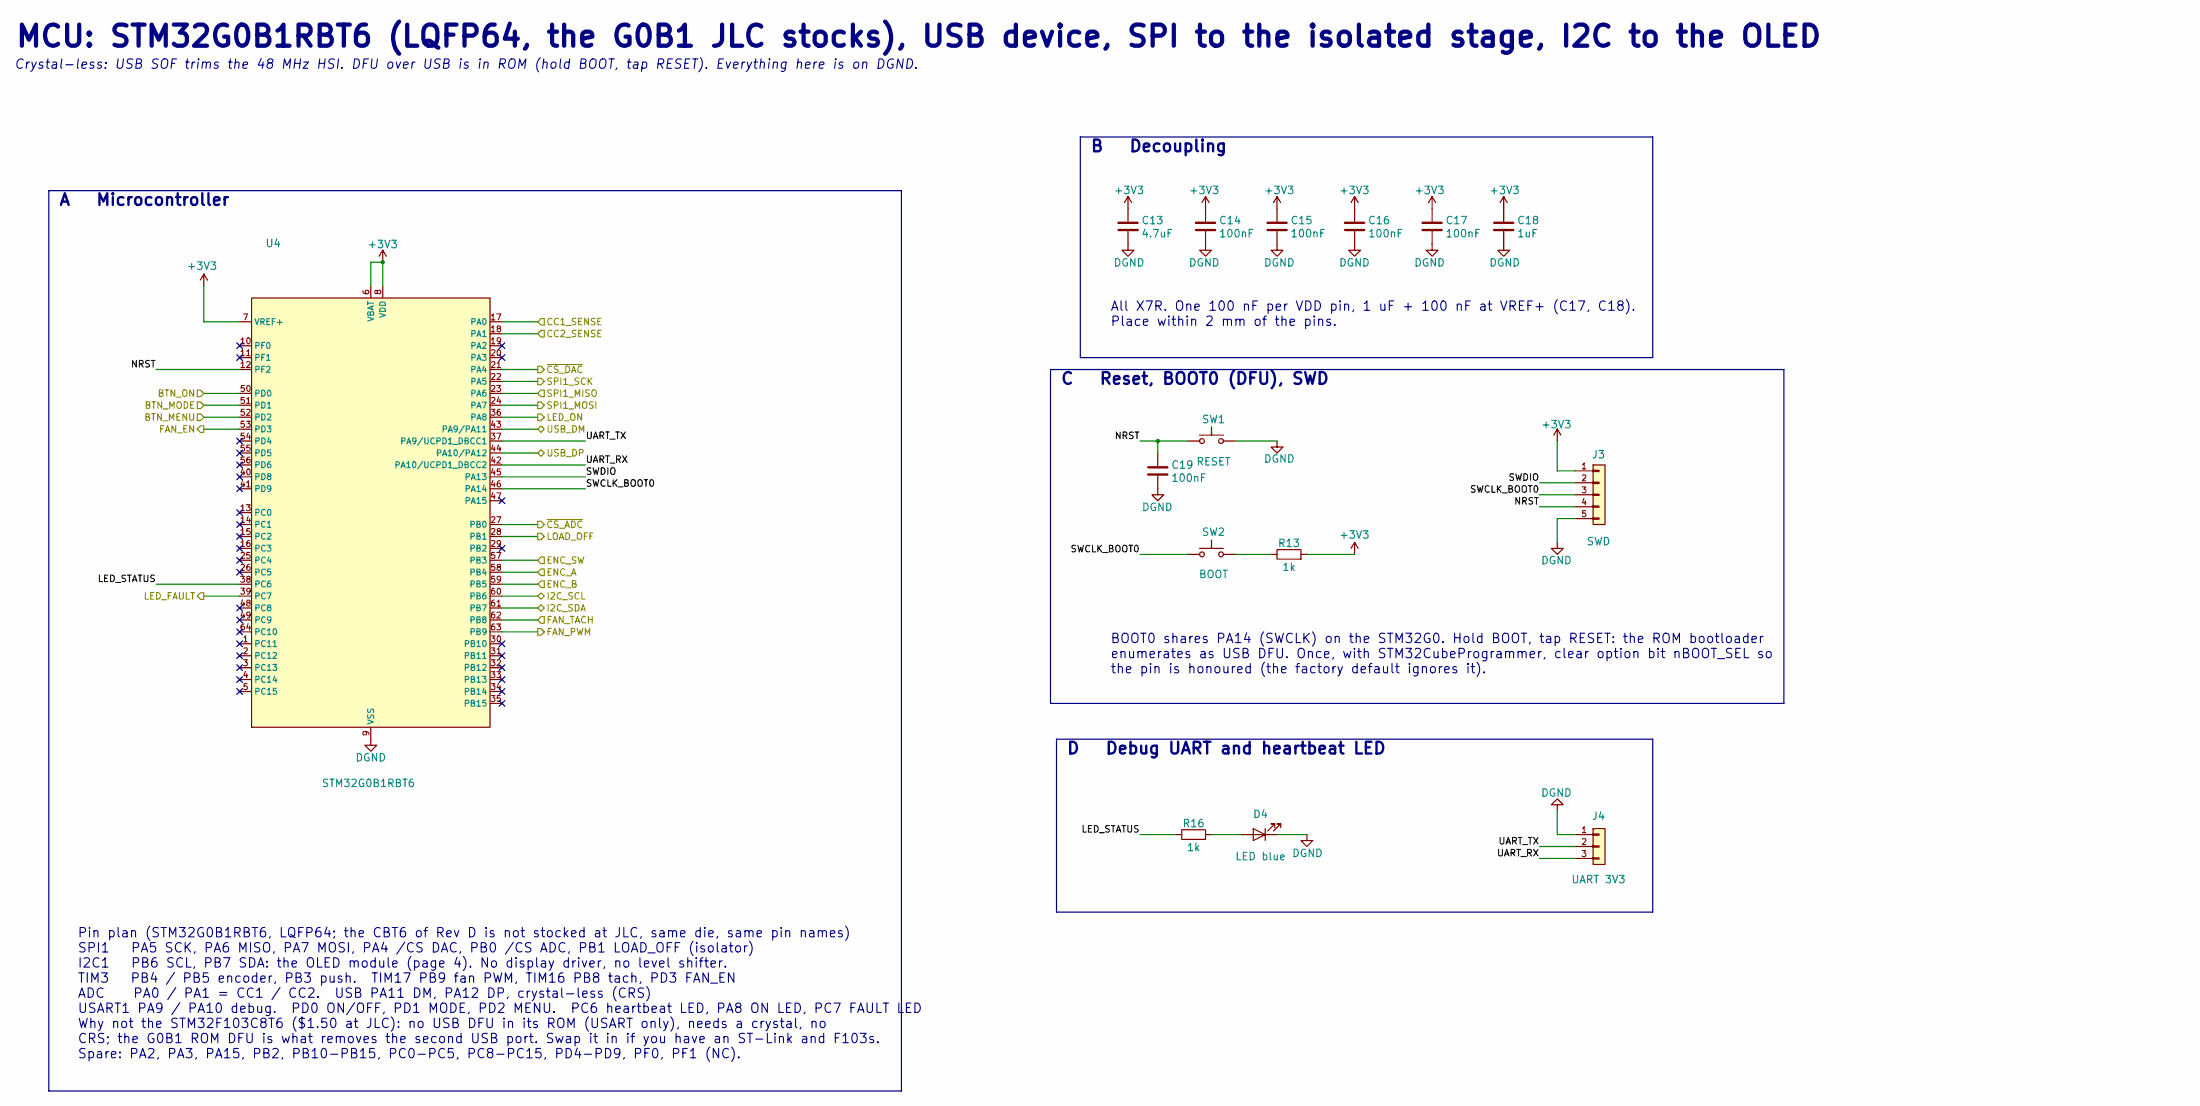
[picture p52: schematic mcu.kicad_sch, MCU: STM32G0B1RBT6 (LQFP64, the G0B1 JLC stocks), USB devic…]

Parts:
C13: 4.7uF; C_0805_2012Metric
C14, C15, C16, C17, C19: 100nF; C_0603_1608Metric
C18: 1uF; C_0603_1608Metric
D4: LED blue; LED_0603_1608Metric; MPN KT-0603B; LCSC C2288
J3: SWD; PinHeader_1x05_P2.54mm_Vertical; MPN B-2100S05P-A110; LCSC C124379
J4: UART 3V3; PinHeader_1x03_P2.54mm_Vertical; MPN B-2100S03P-A110; LCSC C124376
R13, R16: 1k; R_0603_1608Metric
SW1: RESET; SW_PUSH_6mm; MPN KH-6X6X5H-TJ; LCSC C2837515
SW2: BOOT; SW_PUSH_6mm; MPN KH-6X6X5H-TJ; LCSC C2837515
U4: STM32G0B1RBT6; LQFP-64_10x10mm_P0.5mm; MPN STM32G0B1RBT6; LCSC C5143679

Connections:
+3V3: C13.1, C14.1, C15.1, C16.1, C17.1, C18.1, J3.1, R13.2, U4.6 (VBAT), U4.7 (VREF+), U4.8 (VDD); also elsewhere on the board
/Board Link/LOAD_OFF: U4.28 (PB1); also elsewhere on the board
/Board Link/SPI1_MISO: U4.23 (PA6); also elsewhere on the board
/Board Link/SPI1_MOSI: U4.24 (PA7); also elsewhere on the board
/Board Link/SPI1_SCK: U4.22 (PA5); also elsewhere on the board
/Board Link/~CS_ADC: U4.27 (PB0); also elsewhere on the board
/Board Link/~CS_DAC: U4.21 (PA4); also elsewhere on the board
/Front Panel UI/BTN_MENU: U4.52 (PD2); also elsewhere on the board
/Front Panel UI/BTN_MODE: U4.51 (PD1); also elsewhere on the board
/Front Panel UI/BTN_ON: U4.50 (PD0); also elsewhere on the board
/Front Panel UI/ENC_A: U4.58 (PB4); also elsewhere on the board
/Front Panel UI/ENC_B: U4.59 (PB5); also elsewhere on the board
/Front Panel UI/ENC_SW: U4.57 (PB3); also elsewhere on the board
/Front Panel UI/I2C_SCL: U4.60 (PB6); also elsewhere on the board
/Front Panel UI/I2C_SDA: U4.61 (PB7); also elsewhere on the board
/Front Panel UI/LED_FAULT: U4.39 (PC7); also elsewhere on the board
/Front Panel UI/LED_ON: U4.36 (PA8); also elsewhere on the board
/MCU/CC1_SENSE: U4.17 (PA0); also elsewhere on the board
/MCU/CC2_SENSE: U4.18 (PA1); also elsewhere on the board
/MCU/FAN_EN: U4.53 (PD3); also elsewhere on the board
/MCU/FAN_PWM: U4.63 (PB9); also elsewhere on the board
/MCU/FAN_TACH: U4.62 (PB8); also elsewhere on the board
/MCU/LED_STATUS: R16.1, U4.38 (PC6)
/MCU/NRST: C19.1, J3.4, SW1.1, U4.12 (PF2)
/MCU/SWCLK_BOOT0: J3.3, SW2.1, U4.46 (PA14)
/MCU/SWDIO: J3.2, U4.45 (PA13)
/MCU/UART_RX: J4.3, U4.42 (PA10/UCPD1_DBCC2)
/MCU/UART_TX: J4.2, U4.37 (PA9/UCPD1_DBCC1)
/MCU/USB_DM: U4.43 (PA9/PA11); also elsewhere on the board
/MCU/USB_DP: U4.44 (PA10/PA12); also elsewhere on the board
DGND: C13.2, C14.2, C15.2, C16.2, C17.2, C18.2, C19.2, D4.1 (K), J3.5, J4.1, SW1.2, U4.9 (VSS); also elsewhere on the board
unnamed: D4.2 (A), R16.2
unnamed: R13.1, SW2.2

Notes on the sheet:
MCU: STM32G0B1RBT6 (LQFP64, the G0B1 JLC stocks), USB device, SPI to the isolated stage, I2C to the OLED
Crystal-less: USB SOF trims the 48 MHz HSI. DFU over USB is in ROM (hold BOOT, tap RESET). Everything here is on DGND.
Pin plan (STM32G0B1RBT6, LQFP64; the CBT6 of Rev D is not stocked at JLC, same die, same pin names) SPI1 PA5 SCK, PA6 MISO, PA7 MOSI, PA4 /CS DAC, PB0 /CS ADC, PB1 LOAD_OFF (isolator) I2C1 PB6 SCL, PB7 SDA: the OLED module (page 4). No display driver, no level shifter. TIM3 PB4 / PB5 encoder, PB3 p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
A Microcontroller
All X7R. One 100 nF per VDD pin, 1 uF + 100 nF at VREF+ (C17, C18). Place within 2 mm of the pins.
B Decoupling
BOOT0 shares PA14 (SWCLK) on the STM32G0. Hold BOOT, tap RESET: the ROM bootloader enumerates as USB DFU. Once, with STM32CubeProgrammer, clear option bit nBOOT_SEL so the pin is honoured (the factory default ignores it).
C Reset, BOOT0 (DFU), SWD
D Debug UART and heartbeat LED

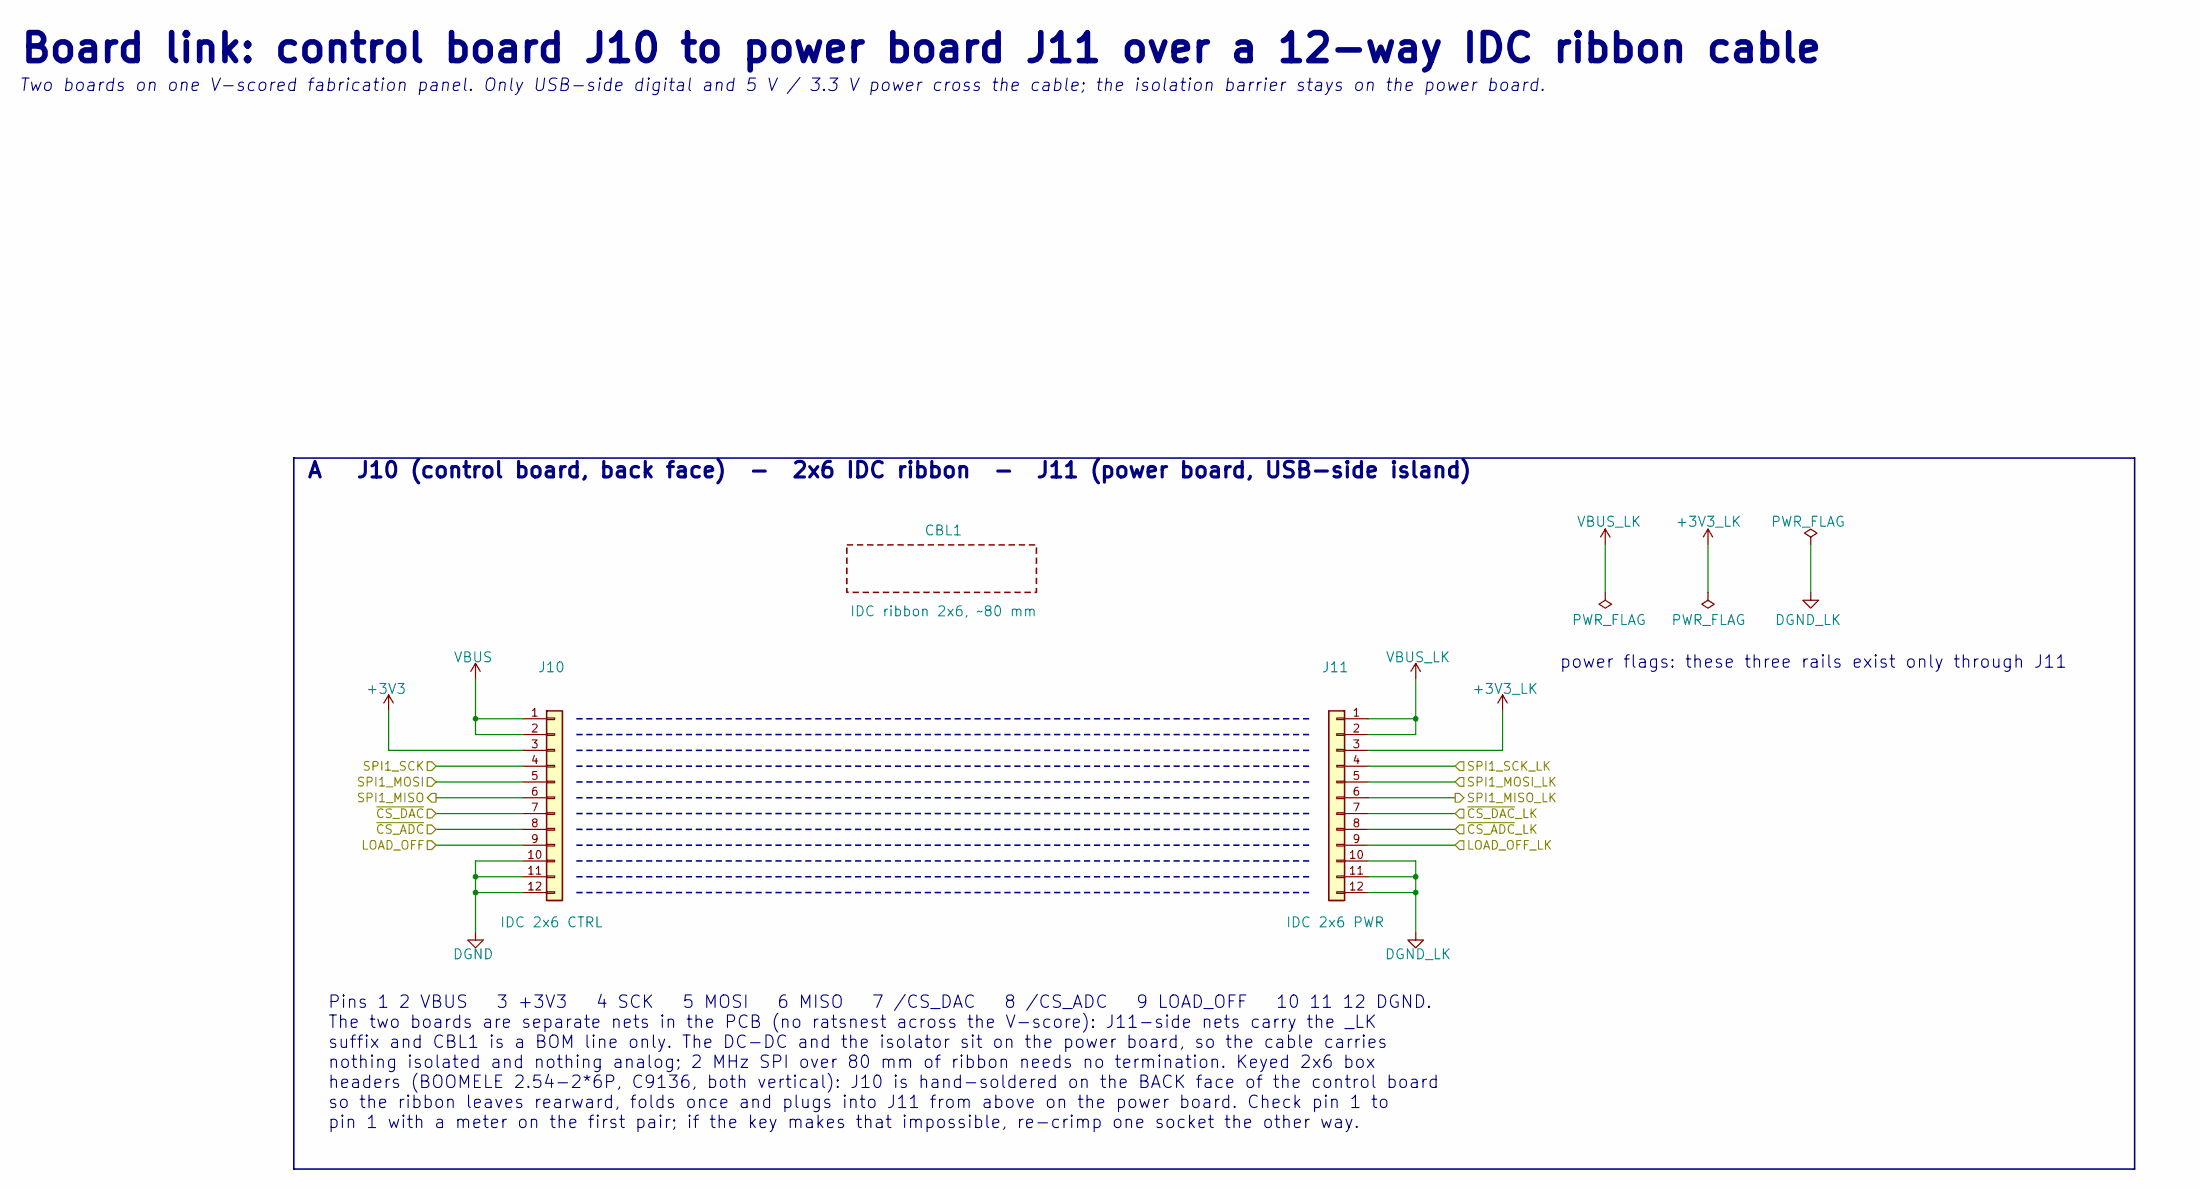
[picture p53: schematic board_link.kicad_sch, Board link: control board J10 to power board J11 over a 12-…]

Parts:
CBL1: IDC ribbon 2x6, ~80 mm; MPN 12-way 1.27 mm ribbon, about 80 mm, two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
J10: IDC 2x6 CTRL; IDC-Header_2x06_P2.54mm_Vertical; MPN 2x6 shrouded box header 2.54 mm, BOOMEL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; LCSC C9136
J11: IDC 2x6 PWR; IDC-Header_2x06_P2.54mm_Vertical; MPN 2x6 shrouded box header 2.54 mm, BOOMEL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; LCSC C9136

Connections:
+3V3: J10.3; also elsewhere on the board
+3V3_LK: J11.3; also elsewhere on the board
/Board Link/LOAD_OFF: J10.9; also elsewhere on the board
/Board Link/LOAD_OFF_LK: J11.9; also elsewhere on the board
/Board Link/SPI1_MISO: J10.6; also elsewhere on the board
/Board Link/SPI1_MISO_LK: J11.6; also elsewhere on the board
/Board Link/SPI1_MOSI: J10.5; also elsewhere on the board
/Board Link/SPI1_MOSI_LK: J11.5; also elsewhere on the board
/Board Link/SPI1_SCK: J10.4; also elsewhere on the board
/Board Link/SPI1_SCK_LK: J11.4; also elsewhere on the board
/Board Link/~CS_ADC: J10.8; also elsewhere on the board
/Board Link/~CS_ADC_LK: J11.8; also elsewhere on the board
/Board Link/~CS_DAC: J10.7; also elsewhere on the board
/Board Link/~CS_DAC_LK: J11.7; also elsewhere on the board
DGND: J10.10, J10.11, J10.12; also elsewhere on the board
DGND_LK: J11.10, J11.11, J11.12; also elsewhere on the board
VBUS: J10.1, J10.2; also elsewhere on the board
VBUS_LK: J11.1, J11.2; also elsewhere on the board

Notes on the sheet:
Board link: control board J10 to power board J11 over a 12-way IDC ribbon cable
Two boards on one V-scored fabrication panel. Only USB-side digital and 5 V / 3.3 V power cross the cable; the isolation barrier stays on the power board.
power flags: these three rails exist only through J11
Pins 1 2 VBUS 3 +3V3 4 SCK 5 MOSI 6 MISO 7 /CS_DAC 8 /CS_ADC 9 LOAD_OFF 10 11 12 DGND. The two boards are separate nets in the PCB (no ratsnest across the V-score): J11-side nets carry the _LK suffix and CBL1 is a BOM line only. The DC-DC and the isolator sit on the power board, so the cable carrie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
A J10 (control board, back face) - 2x6 IDC ribbon - J11 (power board, USB-side island)

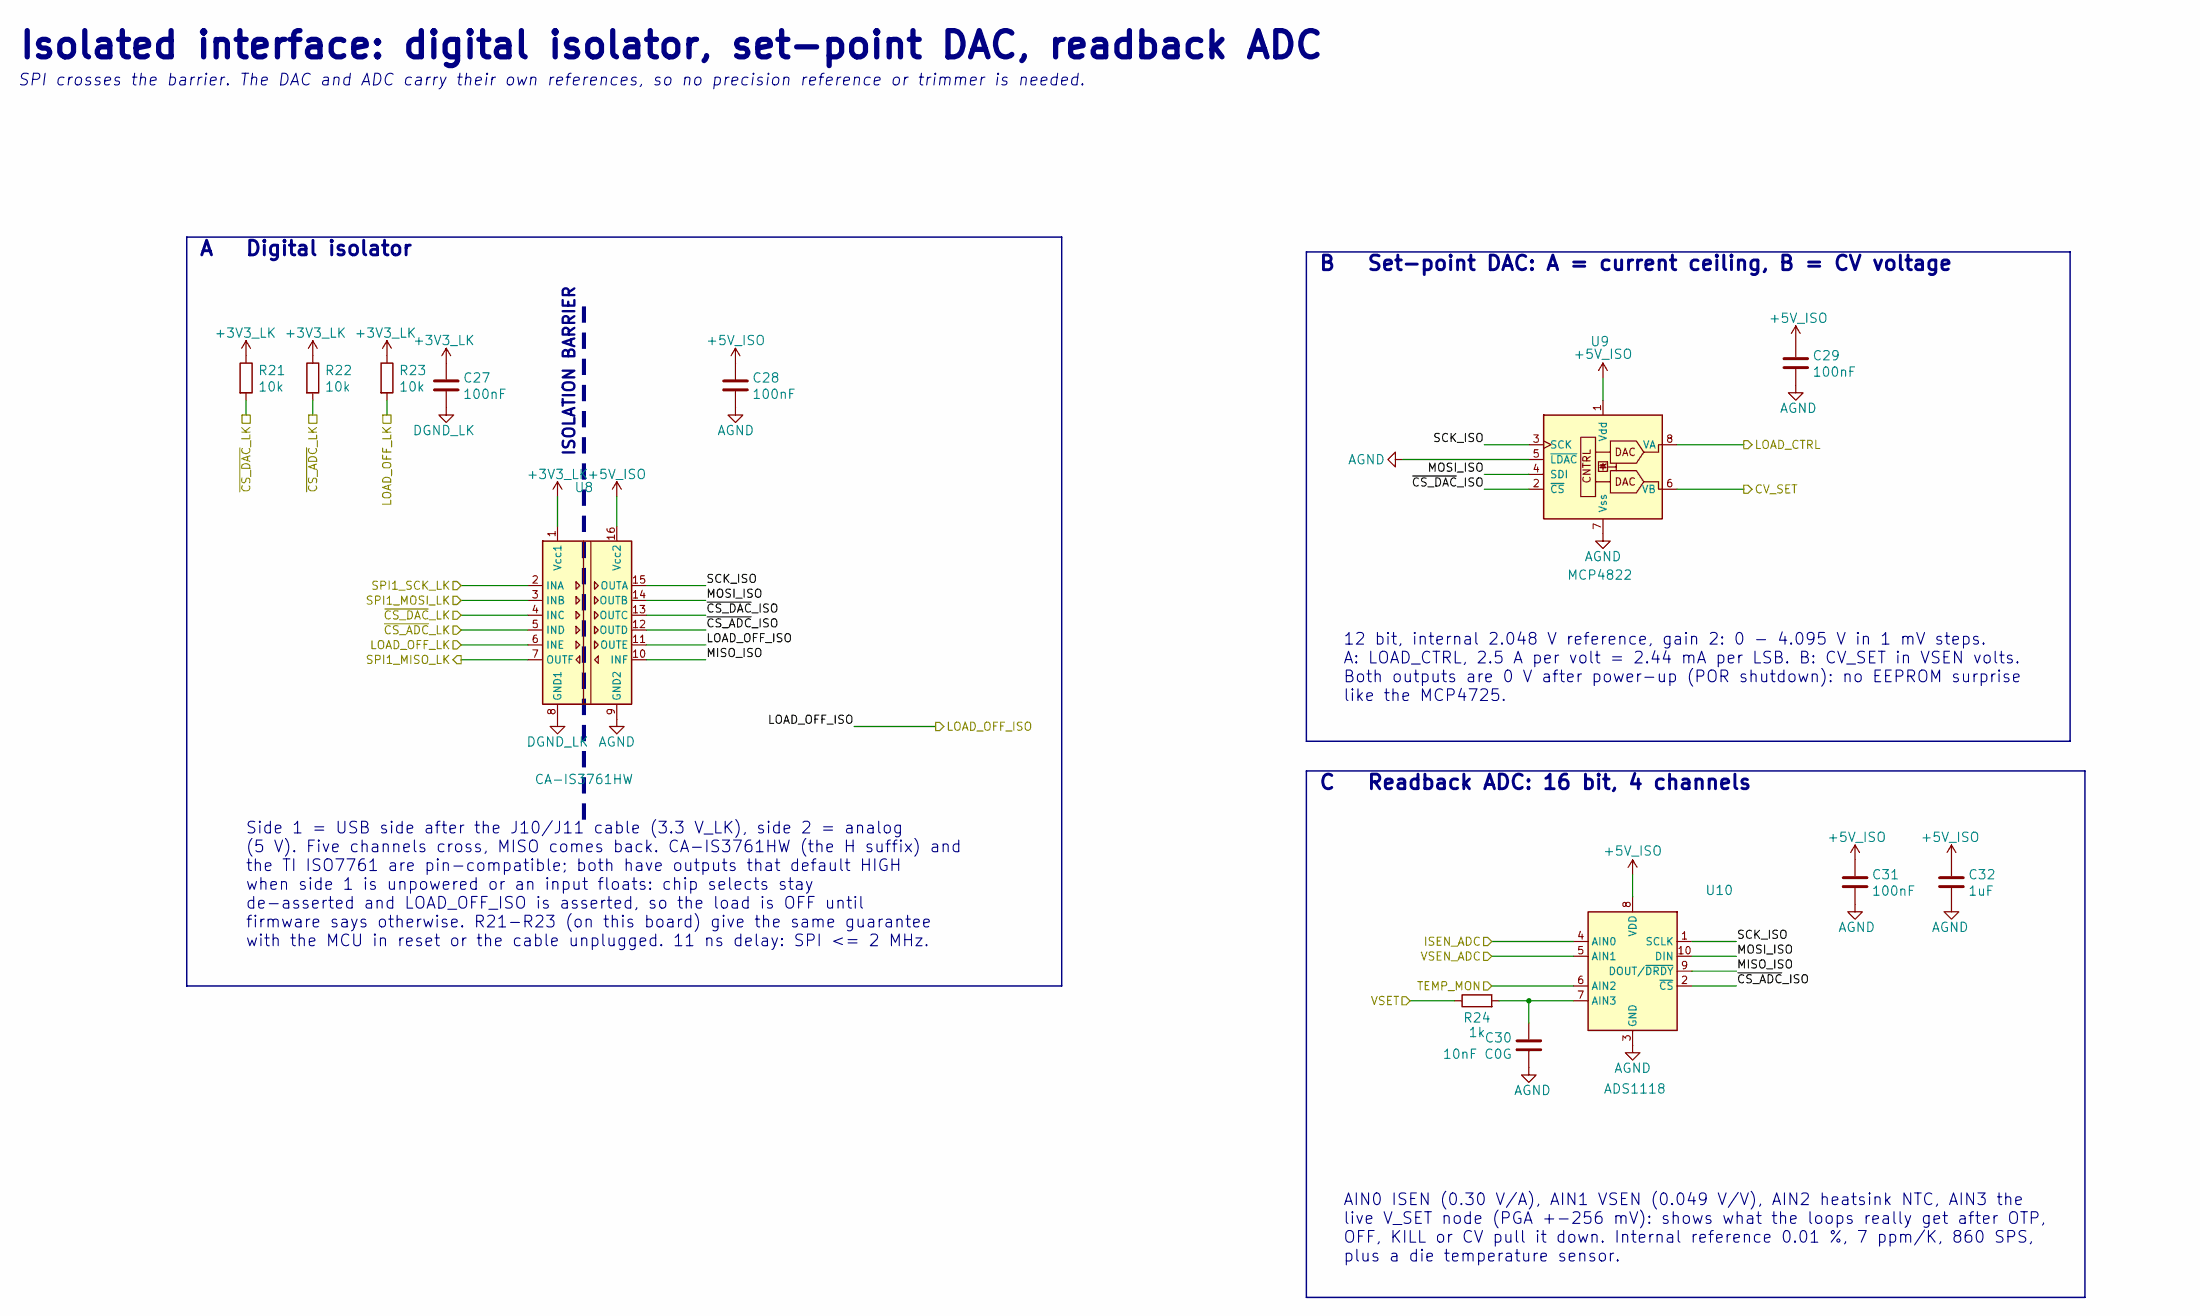
[picture p54: schematic iso_interface.kicad_sch, Isolated interface: digital isolator, set-point DAC, readba…]

Parts:
C27, C28, C29, C31: 100nF; C_0603_1608Metric
C30: 10nF C0G; C_0603_1608Metric
C32: 1uF; C_0603_1608Metric
R21, R22, R23: 10k; R_0603_1608Metric
R24: 1k; R_0603_1608Metric
U8: CA-IS3761HW; SOIC-16W_7.5x10.3mm_P1.27mm; MPN Chipanalog CA-IS3761HW, 5 kVrms, defaul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; LCSC C528656
U9: MCP4822; SOIC-8_3.9x4.9mm_P1.27mm; MPN MCP4822-E/SN; LCSC C16040
U10: ADS1118; TSSOP-10_3x3mm_P0.5mm; MPN ADS1118IDGSR; LCSC C55347

Connections:
+3V3_LK: C27.1, R21.1, R22.1, R23.1, U8.1 (Vcc1); also elsewhere on the board
+5V_ISO: C28.1, C29.1, C31.1, C32.1, U8.16 (Vcc2), U9.1 (Vdd), U10.8 (VDD); also elsewhere on the board
/Board Link/LOAD_OFF_LK: R23.2, U8.6 (INE); also elsewhere on the board
/Board Link/SPI1_MISO_LK: U8.7 (OUTF); also elsewhere on the board
/Board Link/SPI1_MOSI_LK: U8.3 (INB); also elsewhere on the board
/Board Link/SPI1_SCK_LK: U8.2 (INA); also elsewhere on the board
/Board Link/~CS_ADC_LK: R22.2, U8.5 (IND); also elsewhere on the board
/Board Link/~CS_DAC_LK: R21.2, U8.4 (INC); also elsewhere on the board
/Channel 1/VSET: R24.1; also elsewhere on the board
/Isolated Interface/CV_SET: U9.6 (VB); also elsewhere on the board
/Isolated Interface/ISEN_ADC: U10.4 (AIN0); also elsewhere on the board
/Isolated Interface/LOAD_CTRL: U9.8 (VA); also elsewhere on the board
/Isolated Interface/LOAD_OFF_ISO: U8.11 (OUTE); also elsewhere on the board
/Isolated Interface/MISO_ISO: U8.10 (INF), U10.9 (DOUT/~DRDY)
/Isolated Interface/MOSI_ISO: U8.14 (OUTB), U9.4 (SDI), U10.10 (DIN)
/Isolated Interface/SCK_ISO: U8.15 (OUTA), U9.3 (SCK), U10.1 (SCLK)
/Isolated Interface/TEMP_MON: U10.6 (AIN2); also elsewhere on the board
/Isolated Interface/VSEN_ADC: U10.5 (AIN1); also elsewhere on the board
/Isolated Interface/~CS_ADC_ISO: U8.12 (OUTD), U10.2 (~CS)
/Isolated Interface/~CS_DAC_ISO: U8.13 (OUTC), U9.2 (~CS)
AGND: C28.2, C29.2, C30.2, C31.2, C32.2, U8.9 (GND2), U9.5 (~LDAC), U9.7 (Vss), U10.3 (GND); also elsewhere on the board
DGND_LK: C27.2, U8.8 (GND1); also elsewhere on the board
unnamed: C30.1, R24.2, U10.7 (AIN3)

Notes on the sheet:
Isolated interface: digital isolator, set-point DAC, readback ADC
SPI crosses the barrier. The DAC and ADC carry their own references, so no precision reference or trimmer is needed.
ISOLATION BARRIER
Side 1 = USB side after the J10/J11 cable (3.3 V_LK), side 2 = analog (5 V). Five channels cross, MISO comes back. CA-IS3761HW (the H suffix) and the TI ISO7761 are pin-compatible; both have outputs that default HIGH when side 1 is unpowered or an input floats: chip selects stay de-asserted and LOA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
A Digital isolator
12 bit, internal 2.048 V reference, gain 2: 0 - 4.095 V in 1 mV steps. A: LOAD_CTRL, 2.5 A per volt = 2.44 mA per LSB. B: CV_SET in VSEN volts. Both outputs are 0 V after power-up (POR shutdown): no EEPROM surprise like the MCP4725.
B Set-point DAC: A = current ceiling, B = CV voltage
AIN0 ISEN (0.30 V/A), AIN1 VSEN (0.049 V/V), AIN2 heatsink NTC, AIN3 the live V_SET node (PGA +-256 mV): shows what the loops really get after OTP, OFF, KILL or CV pull it down. Internal reference 0.01 %, 7 ppm/K, 860 SPS, plus a die temperature sensor.
C Readback ADC: 16 bit, 4 channels
