WeymenKoo/dc-electronic-load/hardware/rev_e/DC_Load_RevE.kicad_pcb

## KiCad design hardware/rev_e/DC_Load_RevE.kicad_pcb (continued)

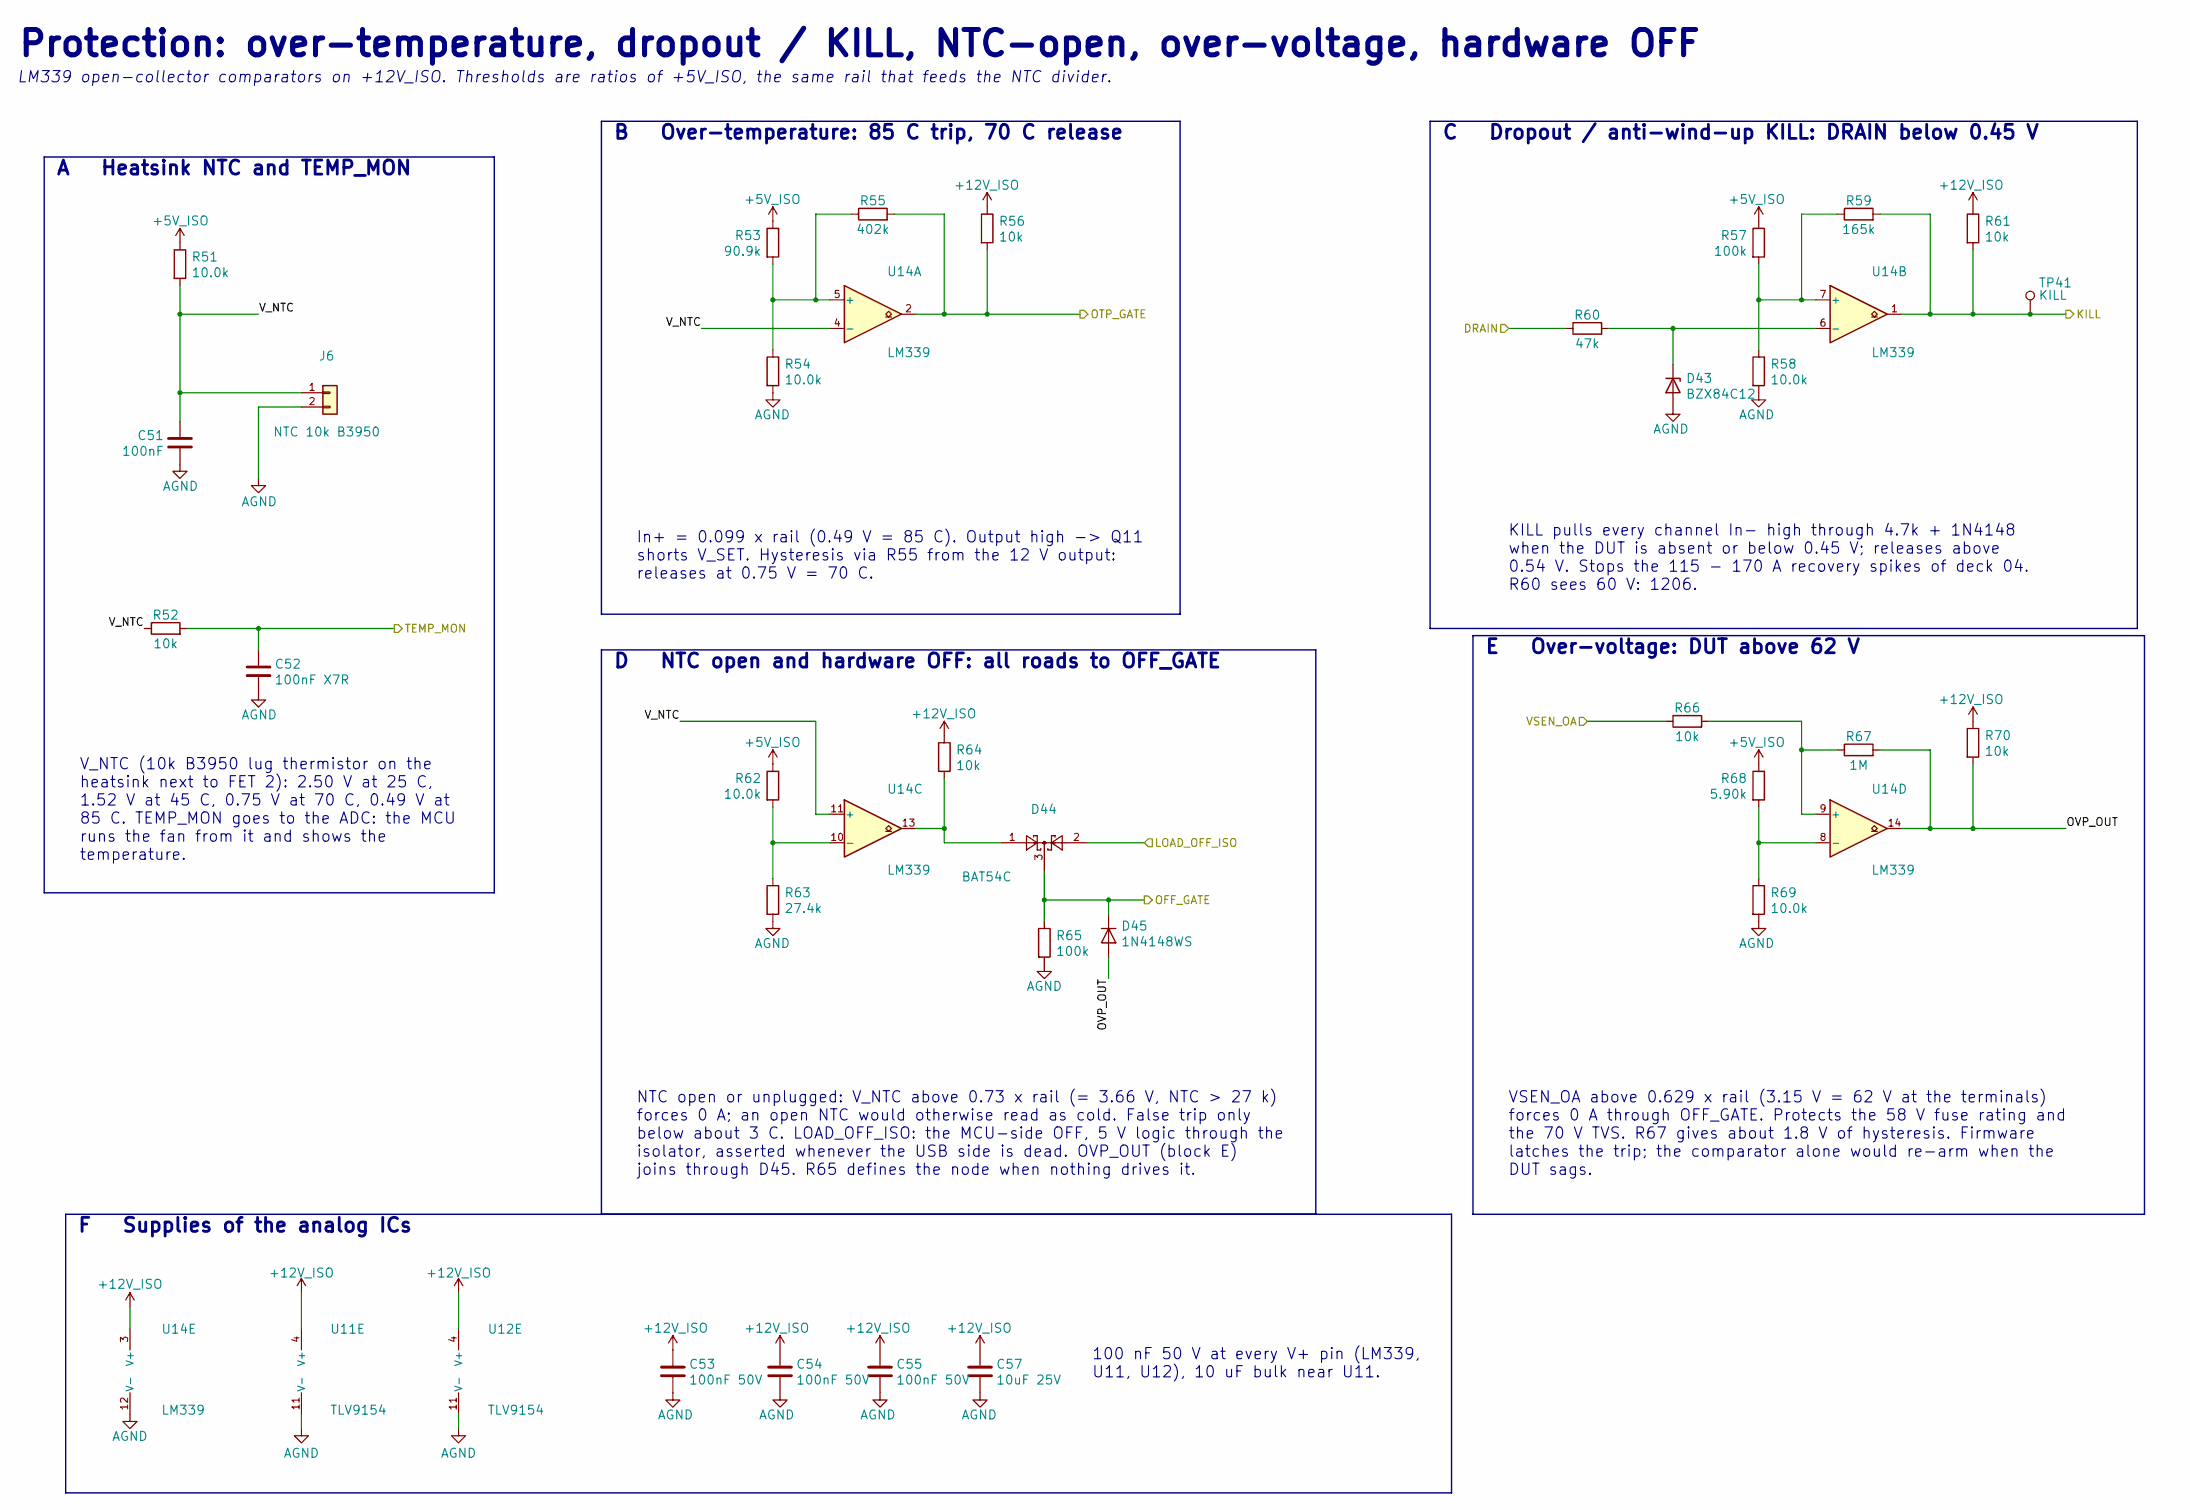
[picture p55: schematic protection.kicad_sch, Protection: over-temperature, dropout / KILL, NTC-open, ove…]

Parts:
C51: 100nF; C_0603_1608Metric
C52: 100nF X7R; C_0603_1608Metric
C53, C54, C55: 100nF 50V; C_0603_1608Metric
C57: 10uF 25V; C_0805_2012Metric
D43: BZX84C12; SOT-23; LCSC C118577
D44: BAT54C; SOT-23; LCSC C2135
D45: 1N4148WS; D_SOD-323; LCSC C2128
J6: NTC 10k B3950; JST_XH_B2B-XH-A_1x02_P2.50mm_Vertical; MPN JST B2B-XH-A(LF)(SN); NTC = 10k B3950 r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; LCSC C158012
R51, R54, R58, R62, R69: 10.0k; R_0603_1608Metric; Tolerance 1%
R52, R56, R61, R64, R70: 10k; R_0603_1608Metric
R53: 90.9k; R_0603_1608Metric; Tolerance 1%
R55: 402k; R_0603_1608Metric; Tolerance 1%
R57: 100k; R_0603_1608Metric; Tolerance 1%
R59: 165k; R_0603_1608Metric; Tolerance 1%
R60: 47k; R_1206_3216Metric; Tolerance 1%; LCSC C102201
R63: 27.4k; R_0603_1608Metric; Tolerance 1%
R65: 100k; R_0603_1608Metric
R66: 10k; R_0603_1608Metric; Tolerance 1%
R67: 1M; R_0603_1608Metric; Tolerance 1%
R68: 5.90k; R_0603_1608Metric; Tolerance 1%
TP41: KILL; TestPoint_THTPad_D1.5mm_Drill0.7mm
U11, U12: TLV9154; SOIC-14_3.9x8.7mm_P1.27mm; MPN TLV9154IDR; LCSC C2873614
U14: LM339; SOIC-14_3.9x8.7mm_P1.27mm; MPN LM339DR; LCSC C5236695

Connections:
+5V_ISO: R51.1, R53.1, R57.1, R62.1, R68.1; also elsewhere on the board
+12V_ISO: C53.1, C54.1, C55.1, C57.1, R56.1, R61.1, R64.1, R70.1, U11.4 (V+), U12.4 (V+), U14.3 (V+); also elsewhere on the board
/Channel 1/DRAIN: R60.1; also elsewhere on the board
/Channel 1/KILL: R59.2, R61.2, TP41.1, U14.1; also elsewhere on the board
/Channel 1/VSET: U11.5 (+), U11.10 (+), U11.12 (+); also elsewhere on the board
/Isolated Interface/LOAD_OFF_ISO: D44.2; also elsewhere on the board
/Isolated Interface/TEMP_MON: C52.1, R52.2; also elsewhere on the board
/Protection/OFF_GATE: D44.3, D45.1 (K), R65.1; also elsewhere on the board
/Protection/OTP_GATE: R55.2, R56.2, U14.2; also elsewhere on the board
/Protection/OVP_OUT: D45.2 (A), R67.2, R70.2, U14.14
/Protection/VSEN_OA: R66.1; also elsewhere on the board
/Protection/V_NTC: C51.1, J6.1, R51.2, R52.1, U14.4 (-), U14.11 (+)
AGND: C51.2, C52.2, C53.2, C54.2, C55.2, C57.2, D43.1 (A), J6.2, R54.2, R58.2, R63.2, R65.2, R69.2, U11.11 (V-), U12.11 (V-), U14.12 (V-); also elsewhere on the board
unnamed: D43.3 (K), R60.2, U14.6 (-)
unnamed: D44.1, R64.2, U14.13
unnamed 82: U11.6 (-); also elsewhere on the board
unnamed 83: U11.7; also elsewhere on the board
unnamed 87: U11.9 (-); also elsewhere on the board
unnamed 88: U11.8; also elsewhere on the board
unnamed 92: U11.13 (-); also elsewhere on the board
unnamed 93: U11.14; also elsewhere on the board
unnamed: R53.2, R54.1, R55.1, U14.5 (+)
unnamed: R57.2, R58.1, R59.1, U14.7 (+)
unnamed: R62.2, R63.1, U14.10 (-)
unnamed: R66.2, R67.1, U14.9 (+)
unnamed: R68.2, R69.1, U14.8 (-)

Notes on the sheet:
Protection: over-temperature, dropout / KILL, NTC-open, over-voltage, hardware OFF
LM339 open-collector comparators on +12V_ISO. Thresholds are ratios of +5V_ISO, the same rail that feeds the NTC divider.
V_NTC (10k B3950 lug thermistor on the heatsink next to FET 2): 2.50 V at 25 C, 1.52 V at 45 C, 0.75 V at 70 C, 0.49 V at 85 C. TEMP_MON goes to the ADC: the MCU runs the fan from it and shows the temperature.
A Heatsink NTC and TEMP_MON
In+ = 0.099 x rail (0.49 V = 85 C). Output high -> Q11 shorts V_SET. Hysteresis via R55 from the 12 V output: releases at 0.75 V = 70 C.
B Over-temperature: 85 C trip, 70 C release
KILL pulls every channel In- high through 4.7k + 1N4148 when the DUT is absent or below 0.45 V; releases above 0.54 V. Stops the 115 - 170 A recovery spikes of deck 04. R60 sees 60 V: 1206.
C Dropout / anti-wind-up KILL: DRAIN below 0.45 V
NTC open or unplugged: V_NTC above 0.73 x rail (= 3.66 V, NTC > 27 k) forces 0 A; an open NTC would otherwise read as cold. False trip only below about 3 C. LOAD_OFF_ISO: the MCU-side OFF, 5 V logic through the isolator, asserted whenever the USB side is dead. OVP_OUT (block E) joins through D45. R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
D NTC open and hardware OFF: all roads to OFF_GATE
VSEN_OA above 0.629 x rail (3.15 V = 62 V at the terminals) forces 0 A through OFF_GATE. Protects the 58 V fuse rating and the 70 V TVS. R67 gives about 1.8 V of hysteresis. Firmware latches the trip; the comparator alone would re-arm when the DUT sags.
E Over-voltage: DUT above 62 V
100 nF 50 V at every V+ pin (LM339, U11, U12), 10 uF bulk near U11.
F Supplies of the analog ICs

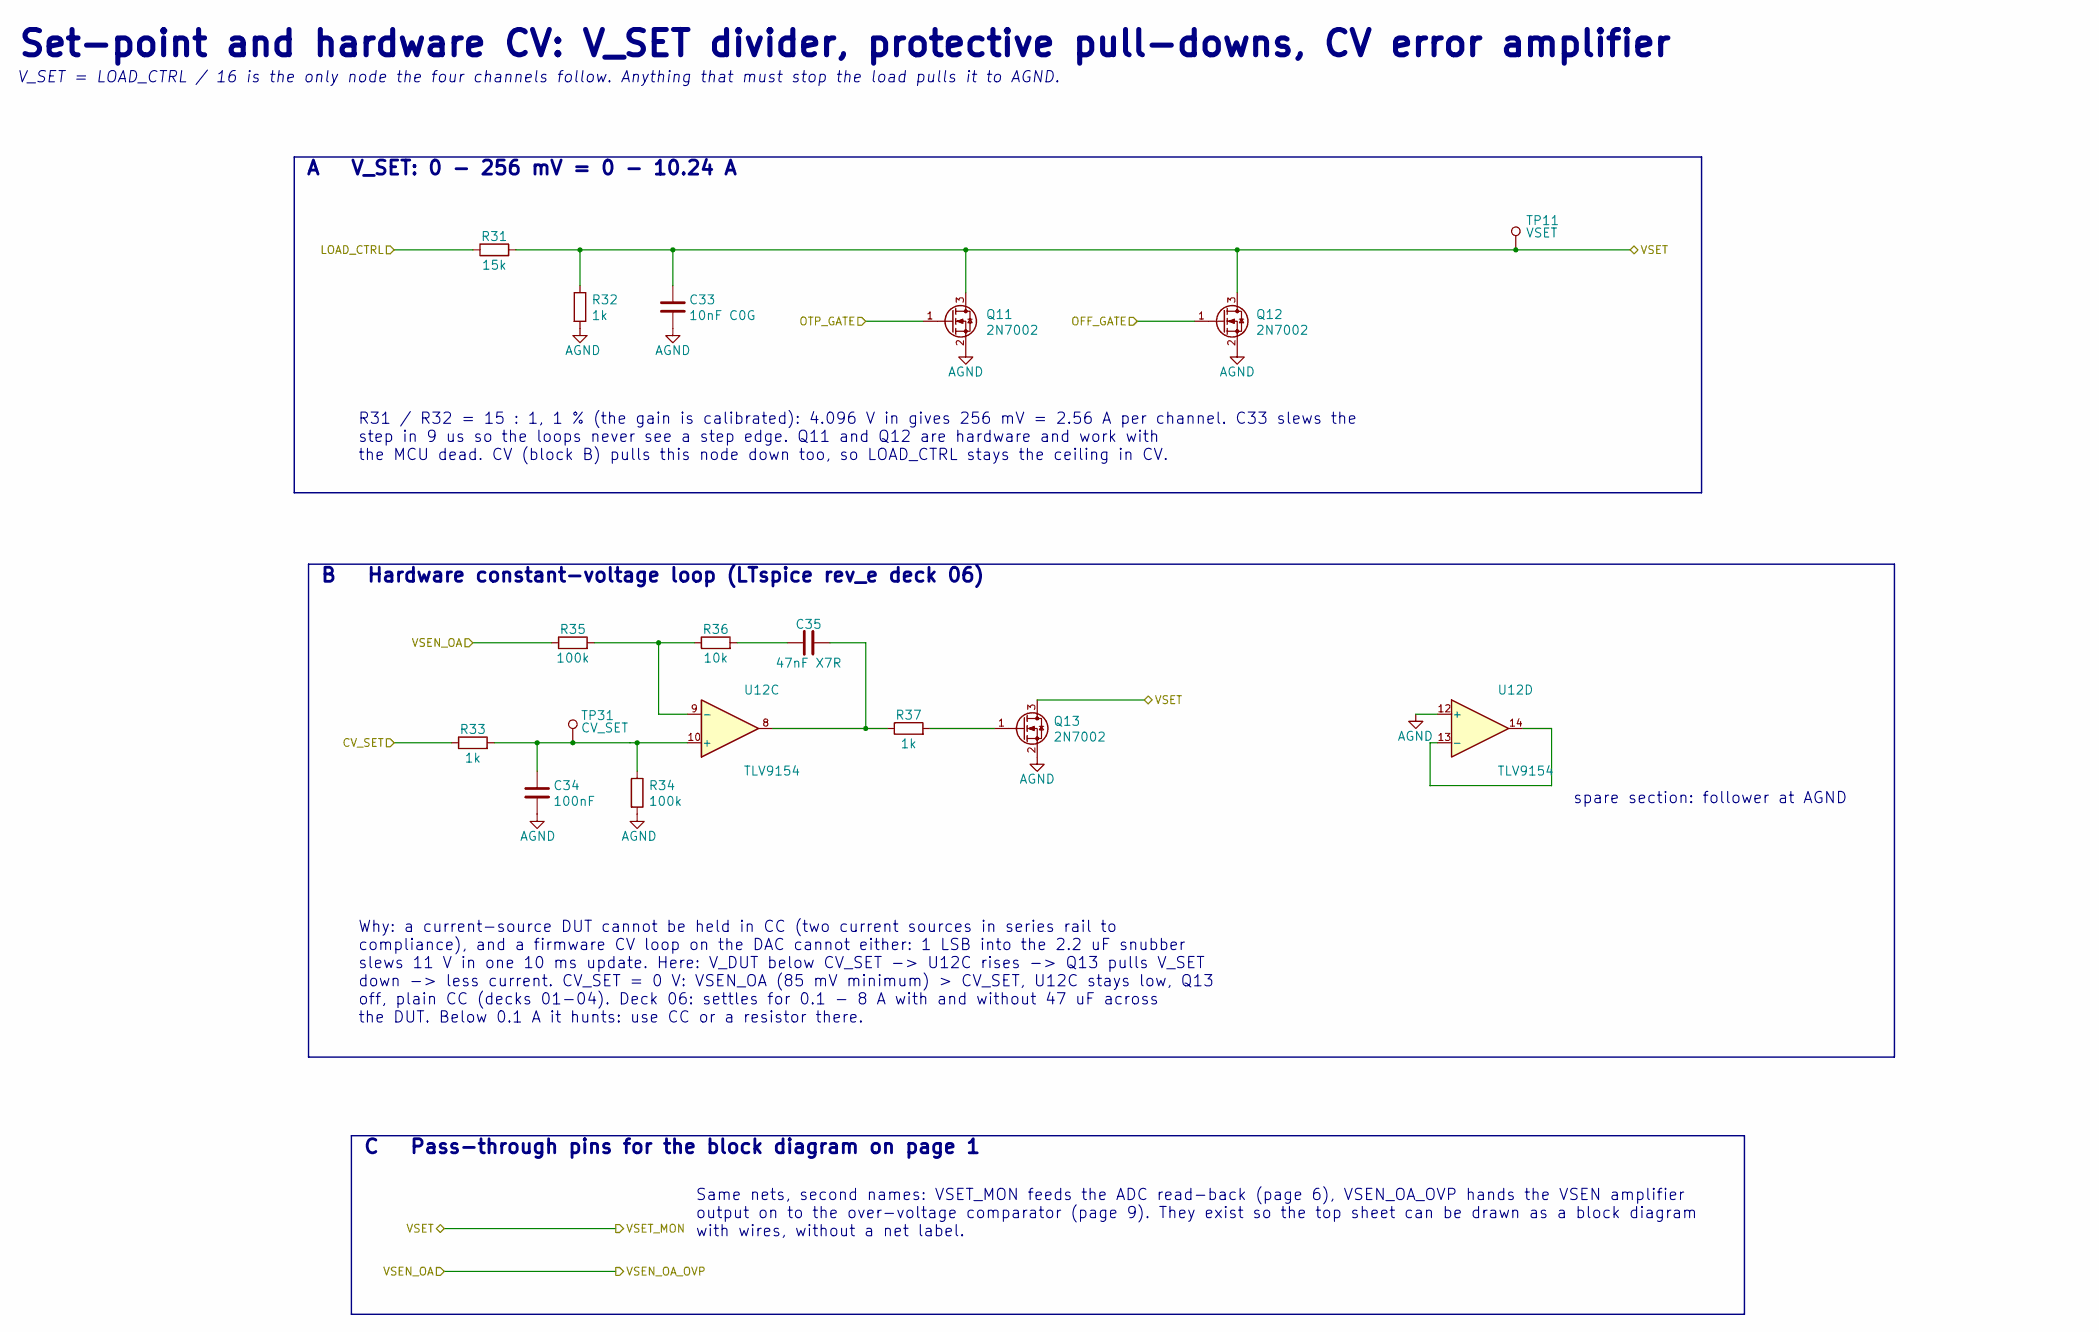
[picture p56: schematic setpoint_cv.kicad_sch, Set-point and hardware CV: V_SET divider, protective pull-d…]

Parts:
C33: 10nF C0G; C_0603_1608Metric
C34: 100nF; C_0603_1608Metric
C35: 47nF X7R; C_0603_1608Metric
Q11, Q12, Q13: 2N7002; SOT-23; LCSC C8545
R31: 15k; R_0603_1608Metric; Tolerance 1%
R32: 1k; R_0603_1608Metric; Tolerance 1%
R33, R37: 1k; R_0603_1608Metric
R34, R35: 100k; R_0603_1608Metric; Tolerance 1%
R36: 10k; R_0603_1608Metric; Tolerance 1%
TP11: VSET; TestPoint_THTPad_D1.5mm_Drill0.7mm
TP31: CV_SET; TestPoint_THTPad_D1.5mm_Drill0.7mm
U12: TLV9154; SOIC-14_3.9x8.7mm_P1.27mm; MPN TLV9154IDR; LCSC C2873614

Connections:
/Channel 1/VSET: C33.1, Q11.3 (D), Q12.3 (D), Q13.3 (D), R31.2, R32.1, TP11.1; also elsewhere on the board
/Isolated Interface/CV_SET: R33.1; also elsewhere on the board
/Isolated Interface/LOAD_CTRL: R31.1; also elsewhere on the board
/Protection/OFF_GATE: Q12.1 (G); also elsewhere on the board
/Protection/OTP_GATE: Q11.1 (G); also elsewhere on the board
/Protection/VSEN_OA: R35.1; also elsewhere on the board
AGND: C33.2, C34.2, Q11.2 (S), Q12.2 (S), Q13.2 (S), R32.2, R34.2, U12.12 (+); also elsewhere on the board
unnamed: C35.1, R36.2
unnamed: C35.2, R37.1, U12.8
unnamed: Q13.1 (G), R37.2
unnamed: C34.1, R33.2, R34.1, TP31.1, U12.10 (+)
unnamed: R35.2, R36.1, U12.9 (-)
unnamed: U12.13 (-), U12.14

Notes on the sheet:
Set-point and hardware CV: V_SET divider, protective pull-downs, CV error amplifier
V_SET = LOAD_CTRL / 16 is the only node the four channels follow. Anything that must stop the load pulls it to AGND.
R31 / R32 = 15 : 1, 1 % (the gain is calibrated): 4.096 V in gives 256 mV = 2.56 A per channel. C33 slews the step in 9 us so the loops never see a step edge. Q11 and Q12 are hardware and work with the MCU dead. CV (block B) pulls this node down too, so LOAD_CTRL stays the ceiling in CV.
A V_SET: 0 - 256 mV = 0 - 10.24 A
spare section: follower at AGND
Why: a current-source DUT cannot be held in CC (two current sources in series rail to compliance), and a firmware CV loop on the DAC cannot either: 1 LSB into the 2.2 uF snubber slews 11 V in one 10 ms update. Here: V_DUT below CV_SET -> U12C rises -> Q13 pulls V_SET down -> less current. CV_SET = 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
B Hardware constant-voltage loop (LTspice rev_e deck 06)
Same nets, second names: VSET_MON feeds the ADC read-back (page 6), VSEN_OA_OVP hands the VSEN amplifier output on to the over-voltage comparator (page 9). They exist so the top sheet can be drawn as a block diagram with wires, without a net label.
C Pass-through pins for the block diagram on page 1

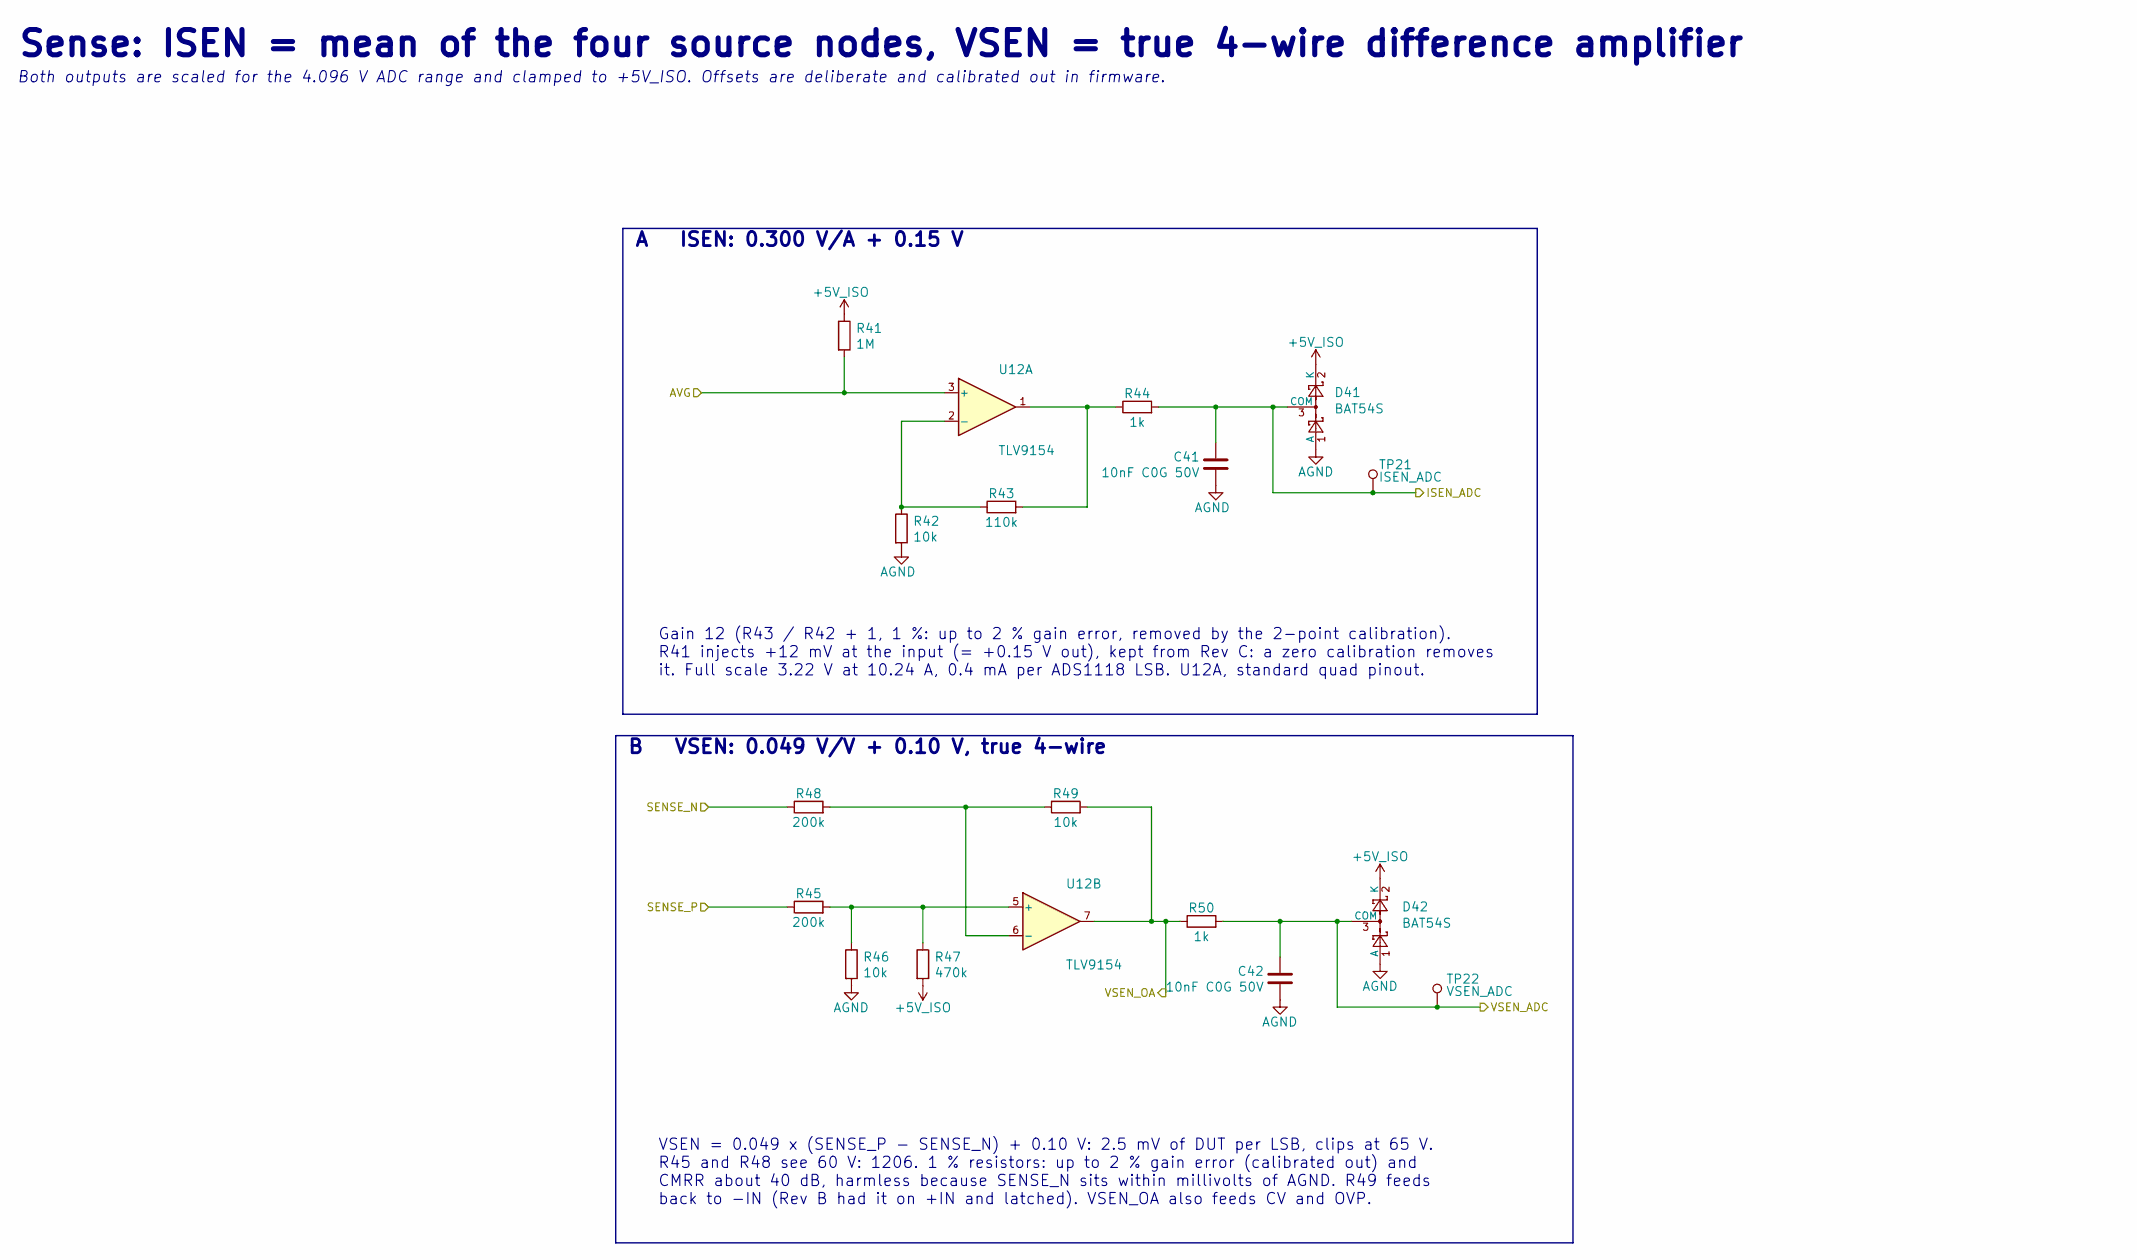
[picture p57: schematic sense.kicad_sch, Sense: ISEN = mean of the four source nodes, VSEN = true 4-…]

Parts:
C41, C42: 10nF C0G 50V; C_0603_1608Metric
D41, D42: BAT54S; SOT-23; LCSC C12765
R41: 1M; R_0603_1608Metric; Tolerance 1%
R42, R46, R49: 10k; R_0603_1608Metric; Tolerance 1%
R43: 110k; R_0603_1608Metric; Tolerance 1%
R44, R50: 1k; R_0603_1608Metric; Tolerance 1%
R45, R48: 200k; R_1206_3216Metric; Tolerance 1%; LCSC C17954
R47: 470k; R_0603_1608Metric; Tolerance 1%
TP21: ISEN_ADC; TestPoint_THTPad_D1.5mm_Drill0.7mm
TP22: VSEN_ADC; TestPoint_THTPad_D1.5mm_Drill0.7mm
U12: TLV9154; SOIC-14_3.9x8.7mm_P1.27mm; MPN TLV9154IDR; LCSC C2873614

Connections:
+5V_ISO: D41.2 (K), D42.2 (K), R41.1, R47.2; also elsewhere on the board
/Channel 1/AVG: R41.2, U12.3 (+); also elsewhere on the board
/Isolated Interface/ISEN_ADC: C41.1, D41.3 (COM), R44.2, TP21.1; also elsewhere on the board
/Isolated Interface/VSEN_ADC: C42.1, D42.3 (COM), R50.2, TP22.1; also elsewhere on the board
/Power Path/SENSE_N: R48.1; also elsewhere on the board
/Power Path/SENSE_P: R45.1; also elsewhere on the board
/Protection/VSEN_OA: R49.2, R50.1, U12.7; also elsewhere on the board
AGND: C41.2, C42.2, D41.1 (A), D42.1 (A), R42.2, R46.2; also elsewhere on the board
unnamed: R43.2, R44.1, U12.1
unnamed: R42.1, R43.1, U12.2 (-)
unnamed: R45.2, R46.1, R47.1, U12.5 (+)
unnamed: R48.2, R49.1, U12.6 (-)

Notes on the sheet:
Sense: ISEN = mean of the four source nodes, VSEN = true 4-wire difference amplifier
Both outputs are scaled for the 4.096 V ADC range and clamped to +5V_ISO. Offsets are deliberate and calibrated out in firmware.
Gain 12 (R43 / R42 + 1, 1 %: up to 2 % gain error, removed by the 2-point calibration). R41 injects +12 mV at the input (= +0.15 V out), kept from Rev C: a zero calibration removes it. Full scale 3.22 V at 10.24 A, 0.4 mA per ADS1118 LSB. U12A, standard quad pinout.
A ISEN: 0.300 V/A + 0.15 V
VSEN = 0.049 x (SENSE_P - SENSE_N) + 0.10 V: 2.5 mV of DUT per LSB, clips at 65 V. R45 and R48 see 60 V: 1206. 1 % resistors: up to 2 % gain error (calibrated out) and CMRR about 40 dB, harmless because SENSE_N sits within millivolts of AGND. R49 feeds back to -IN (Rev B had it on +IN and latched).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
B VSEN: 0.049 V/V + 0.10 V, true 4-wire

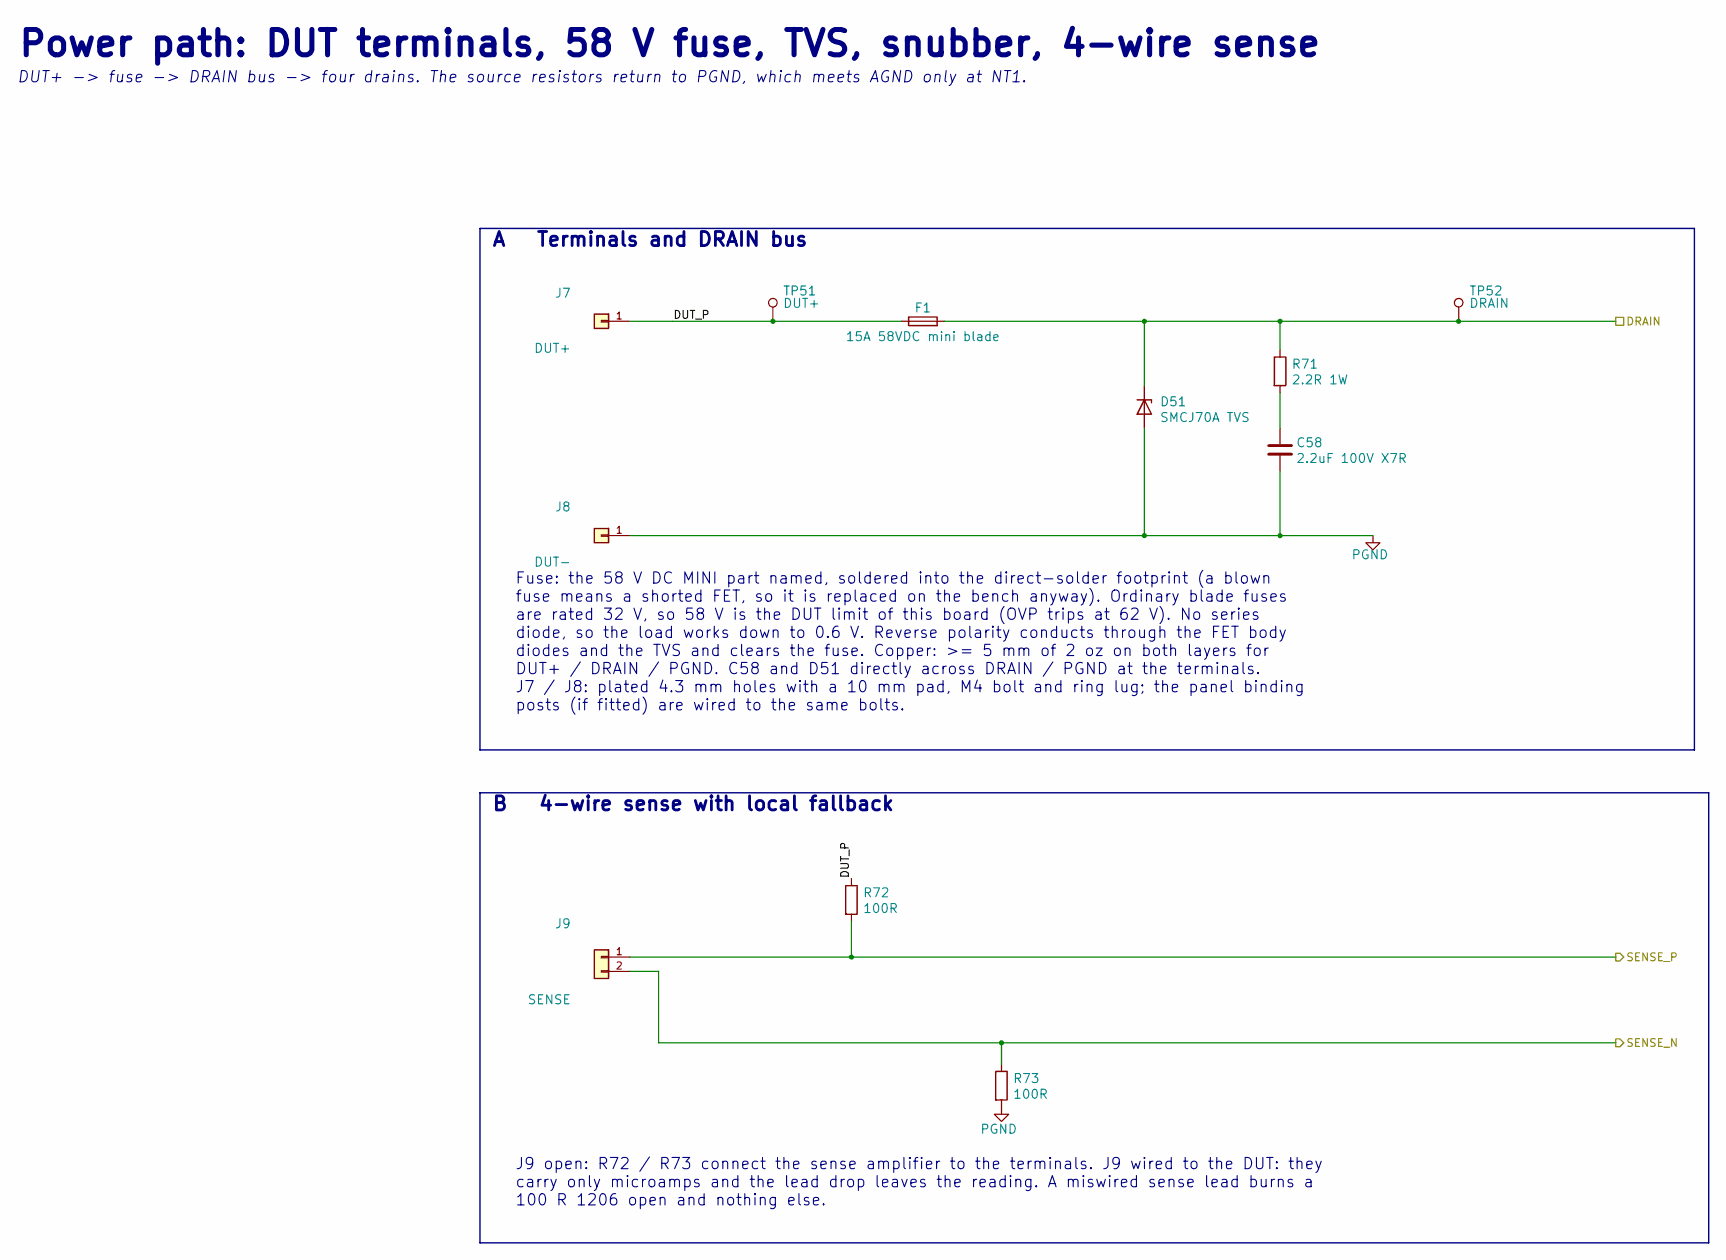
[picture p58: schematic power_path.kicad_sch, Power path: DUT terminals, 58 V fuse, TVS, snubber, 4-wire …]

Parts:
C58: 2.2uF 100V X7R; C_1206_3216Metric; LCSC C170101
D51: SMCJ70A TVS; D_SMC; LCSC C2943781
F1: 15A 58VDC mini blade; Fuse_Blade_Mini_directSolder; MPN Littelfuse 0997015.WXN, soldered in (pl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; LCSC C207027
J7: DUT+; MountingHole_4.3mm_M4_Pad; MPN M4 x 12 bolt, nut, 2 washers (hardware 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
J8: DUT-; MountingHole_4.3mm_M4_Pad; MPN M4 x 12 bolt, nut, 2 washers (hardware 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
J9: SENSE; JST_XH_B2B-XH-A_1x02_P2.50mm_Vertical; MPN JST B2B-XH-A(LF)(SN); LCSC C158012
R71: 2.2R 1W; R_2512_6332Metric; Tolerance 5%; LCSC C25480
R72, R73: 100R; R_1206_3216Metric; LCSC C17901
TP51: DUT+; TestPoint_THTPad_D1.5mm_Drill0.7mm
TP52: DRAIN; TestPoint_THTPad_D1.5mm_Drill0.7mm

Connections:
/Channel 1/DRAIN: D51.1 (K), F1.2, R71.1, TP52.1; also elsewhere on the board
/Power Path/DUT_P: F1.1, J7.1, R72.1, TP51.1
/Power Path/SENSE_N: J9.2, R73.1; also elsewhere on the board
/Power Path/SENSE_P: J9.1, R72.2; also elsewhere on the board
unnamed: C58.1, R71.2
PGND: C58.2, D51.2 (A), J8.1, R73.2; also elsewhere on the board

Notes on the sheet:
Power path: DUT terminals, 58 V fuse, TVS, snubber, 4-wire sense
DUT+ -> fuse -> DRAIN bus -> four drains. The source resistors return to PGND, which meets AGND only at NT1.
Fuse: the 58 V DC MINI part named, soldered into the direct-solder footprint (a blown fuse means a shorted FET, so it is replaced on the bench anyway). Ordinary blade fuses are rated 32 V, so 58 V is the DUT limit of this board (OVP trips at 62 V). No series diode, so the load works down to 0.6 V. 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
A Terminals and DRAIN bus
J9 open: R72 / R73 connect the sense amplifier to the terminals. J9 wired to the DUT: they carry only microamps and the lead drop leaves the reading. A miswired sense lead burns a 100 R 1206 open and nothing else.
B 4-wire sense with local fallback

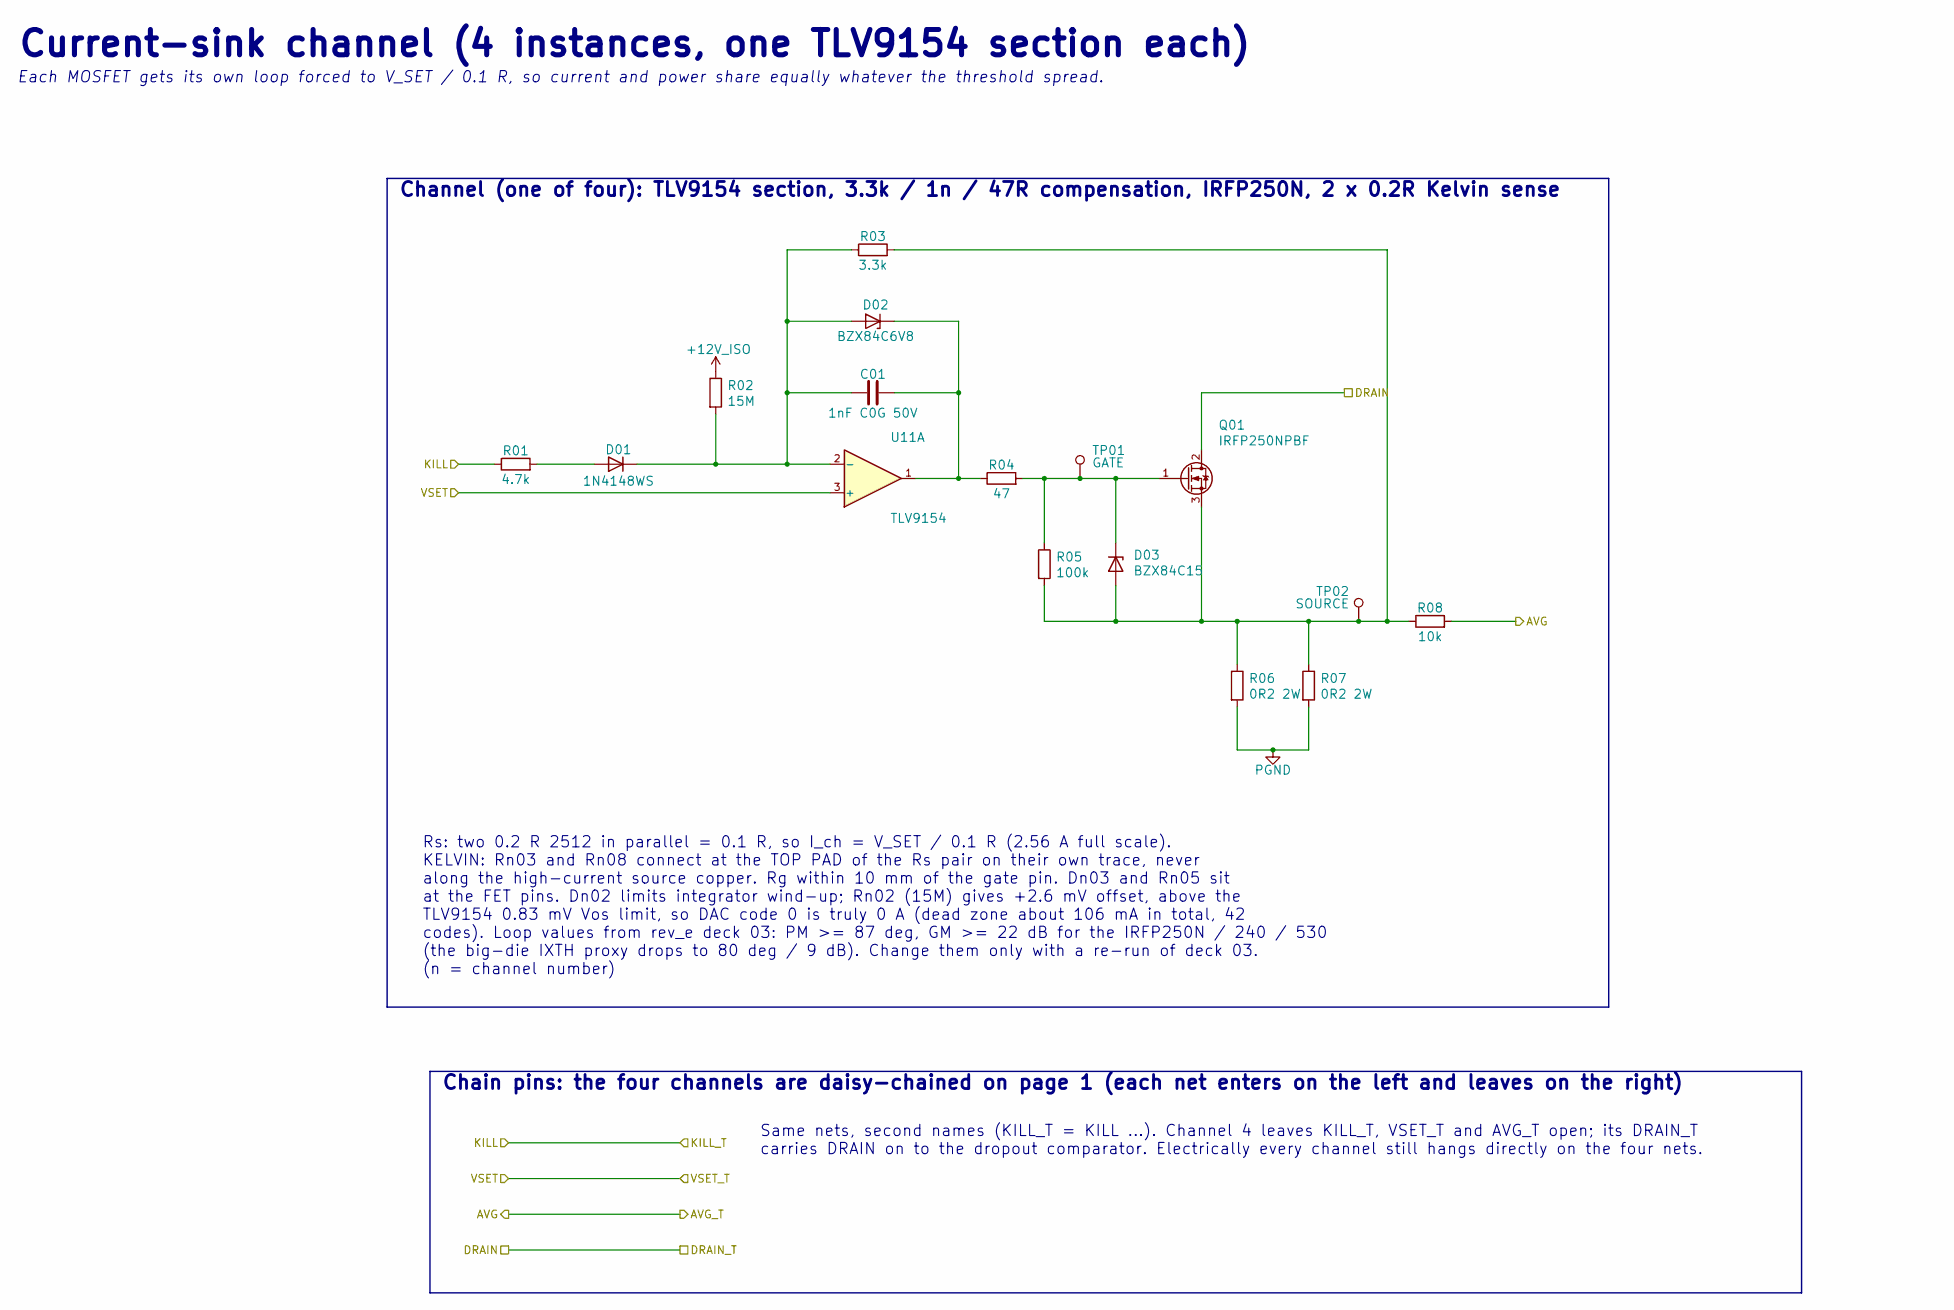
[picture p59: schematic channel.kicad_sch, Current-sink channel (4 instances, one TLV9154 section each)]

Parts:
C01: 1nF C0G 50V; C_0603_1608Metric
D01: 1N4148WS; D_SOD-323; LCSC C2128
D02: BZX84C6V8; SOT-23; LCSC C118571
D03: BZX84C15; SOT-23; LCSC C328579
Q01: IRFP250NPBF; TO-247-3_Vertical; MPN IRFP250NPBF (Infineon, LCSC C2580; not 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; LCSC C2580
R01: 4.7k; R_0603_1608Metric; Tolerance 1%
R02: 15M; R_0603_1608Metric; Tolerance 5%
R03: 3.3k; R_0603_1608Metric; Tolerance 1%
R04: 47; R_0603_1608Metric; Tolerance 1%
R05: 100k; R_0603_1608Metric
R06, R07: 0R2 2W; R_2512_6332Metric; Tolerance 1%; LCSC C5375444
R08: 10k; R_0603_1608Metric; Tolerance 1%
TP01: GATE; TestPoint_THTPad_D1.5mm_Drill0.7mm
TP02: SOURCE; TestPoint_THTPad_D1.5mm_Drill0.7mm
U11: TLV9154; SOIC-14_3.9x8.7mm_P1.27mm; MPN TLV9154IDR; LCSC C2873614

Connections:
/Channel 1/VSET: U11.3 (+), U11.5 (+), U11.10 (+), U11.12 (+); also elsewhere on the board
unnamed 77: U11.2 (-); also elsewhere on the board
unnamed 78: U11.1; also elsewhere on the board
unnamed 82: U11.6 (-); also elsewhere on the board
unnamed 83: U11.7; also elsewhere on the board
unnamed 87: U11.9 (-); also elsewhere on the board
unnamed 88: U11.8; also elsewhere on the board
unnamed 92: U11.13 (-); also elsewhere on the board
unnamed 93: U11.14; also elsewhere on the board

Parts of its further copies:
C101, C201, C301, C401: 1nF C0G 50V; C_0603_1608Metric
D101, D201, D301, D401: 1N4148WS; D_SOD-323; LCSC C2128
D102, D202, D302, D402: BZX84C6V8; SOT-23; LCSC C118571
D103, D203, D303, D403: BZX84C15; SOT-23; LCSC C328579
Q101, Q201, Q301, Q401: IRFP250NPBF; TO-247-3_Vertical; MPN IRFP250NPBF (Infineon, LCSC C2580; not 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; LCSC C2580
R101, R201, R301, R401: 4.7k; R_0603_1608Metric; Tolerance 1%
R102, R202, R302, R402: 15M; R_0603_1608Metric; Tolerance 5%
R103, R203, R303, R403: 3.3k; R_0603_1608Metric; Tolerance 1%
R104, R204, R304, R404: 47; R_0603_1608Metric; Tolerance 1%
R105, R205, R305, R405: 100k; R_0603_1608Metric
R106, R107, R206, R207, R306, R307, R406, R407: 0R2 2W; R_2512_6332Metric; Tolerance 1%; LCSC C5375444
R108, R208, R308, R408: 10k; R_0603_1608Metric; Tolerance 1%
TP101, TP201, TP301, TP401: GATE; TestPoint_THTPad_D1.5mm_Drill0.7mm
TP102, TP202, TP302, TP402: SOURCE; TestPoint_THTPad_D1.5mm_Drill0.7mm

Connections of its further copies:
+12V_ISO: R102.1, R202.1, R302.1, R402.1; also elsewhere on the board
/Channel 1/AVG: R108.2, R208.2, R308.2, R408.2; also elsewhere on the board
/Channel 1/DRAIN: Q101.2 (D), Q201.2 (D), Q301.2 (D), Q401.2 (D); also elsewhere on the board
/Channel 1/KILL: R101.1, R201.1, R301.1, R401.1; also elsewhere on the board
unnamed: D101.2 (A), R101.2
unnamed 77: C101.1, D101.1 (K), D102.1 (A), R102.2, R103.1; also elsewhere on the board
unnamed 78: C101.2, D102.3 (K), R104.1; also elsewhere on the board
unnamed: D103.1 (A), Q101.3 (S), R103.2, R105.2, R106.1, R107.1, R108.1, TP102.1
unnamed: D103.3 (K), Q101.1 (G), R104.2, R105.1, TP101.1
unnamed: D201.2 (A), R201.2
unnamed 82: C201.1, D201.1 (K), D202.1 (A), R202.2, R203.1; also elsewhere on the board
unnamed 83: C201.2, D202.3 (K), R204.1; also elsewhere on the board
unnamed: D203.1 (A), Q201.3 (S), R203.2, R205.2, R206.1, R207.1, R208.1, TP202.1
unnamed: D203.3 (K), Q201.1 (G), R204.2, R205.1, TP201.1
unnamed: D301.2 (A), R301.2
unnamed 87: C301.1, D301.1 (K), D302.1 (A), R302.2, R303.1; also elsewhere on the board
unnamed 88: C301.2, D302.3 (K), R304.1; also elsewhere on the board
unnamed: D303.1 (A), Q301.3 (S), R303.2, R305.2, R306.1, R307.1, R308.1, TP302.1
unnamed: D303.3 (K), Q301.1 (G), R304.2, R305.1, TP301.1
unnamed: D401.2 (A), R401.2
unnamed 92: C401.1, D401.1 (K), D402.1 (A), R402.2, R403.1; also elsewhere on the board
unnamed 93: C401.2, D402.3 (K), R404.1; also elsewhere on the board
unnamed: D403.1 (A), Q401.3 (S), R403.2, R405.2, R406.1, R407.1, R408.1, TP402.1
unnamed: D403.3 (K), Q401.1 (G), R404.2, R405.1, TP401.1
PGND: R106.2, R107.2, R206.2, R207.2, R306.2, R307.2, R406.2, R407.2; also elsewhere on the board

Notes on the sheet:
Current-sink channel (4 instances, one TLV9154 section each)
Each MOSFET gets its own loop forced to V_SET / 0.1 R, so current and power share equally whatever the threshold spread.
Rs: two 0.2 R 2512 in parallel = 0.1 R, so I_ch = V_SET / 0.1 R (2.56 A full scale). KELVIN: Rn03 and Rn08 connect at the TOP PAD of the Rs pair on their own trace, never along the high-current source copper. Rg within 10 mm of the gate pin. Dn03 and Rn05 sit at the FET pins. Dn02 limits integrator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
Channel (one of four): TLV9154 section, 3.3k / 1n / 47R compensation, IRFP250N, 2 x 0.2R Kelvin sense
Same nets, second names (KILL_T = KILL ...). Channel 4 leaves KILL_T, VSET_T and AVG_T open; its DRAIN_T carries DRAIN on to the dropout comparator. Electrically every channel still hangs directly on the four nets.
Chain pins: the four channels are daisy-chained on page 1 (each net enters on the left and leaves on the right)

Board: 2 copper layers, 223 parts (1 on the bottom side), 119 nets, no tracks yet.

Other parts of the board:
H1, H2, H3, H4, H5, H6, H7, H8: MountingHole_3.2mm_M3
HA1, HA2, HA3, HA4: ScrewAccess_D7
