WeymenKoo/dc-electronic-load/reference/jay_diddy_b_lt1014_loads/Dual LT1013/LT1013 DS Electronic Load (1).kicad_pcb

## KiCad design reference/jay_diddy_b_lt1014_loads/Dual LT1013/LT1013 DS Electronic Load (1).kicad_pcb (2026-10-31)

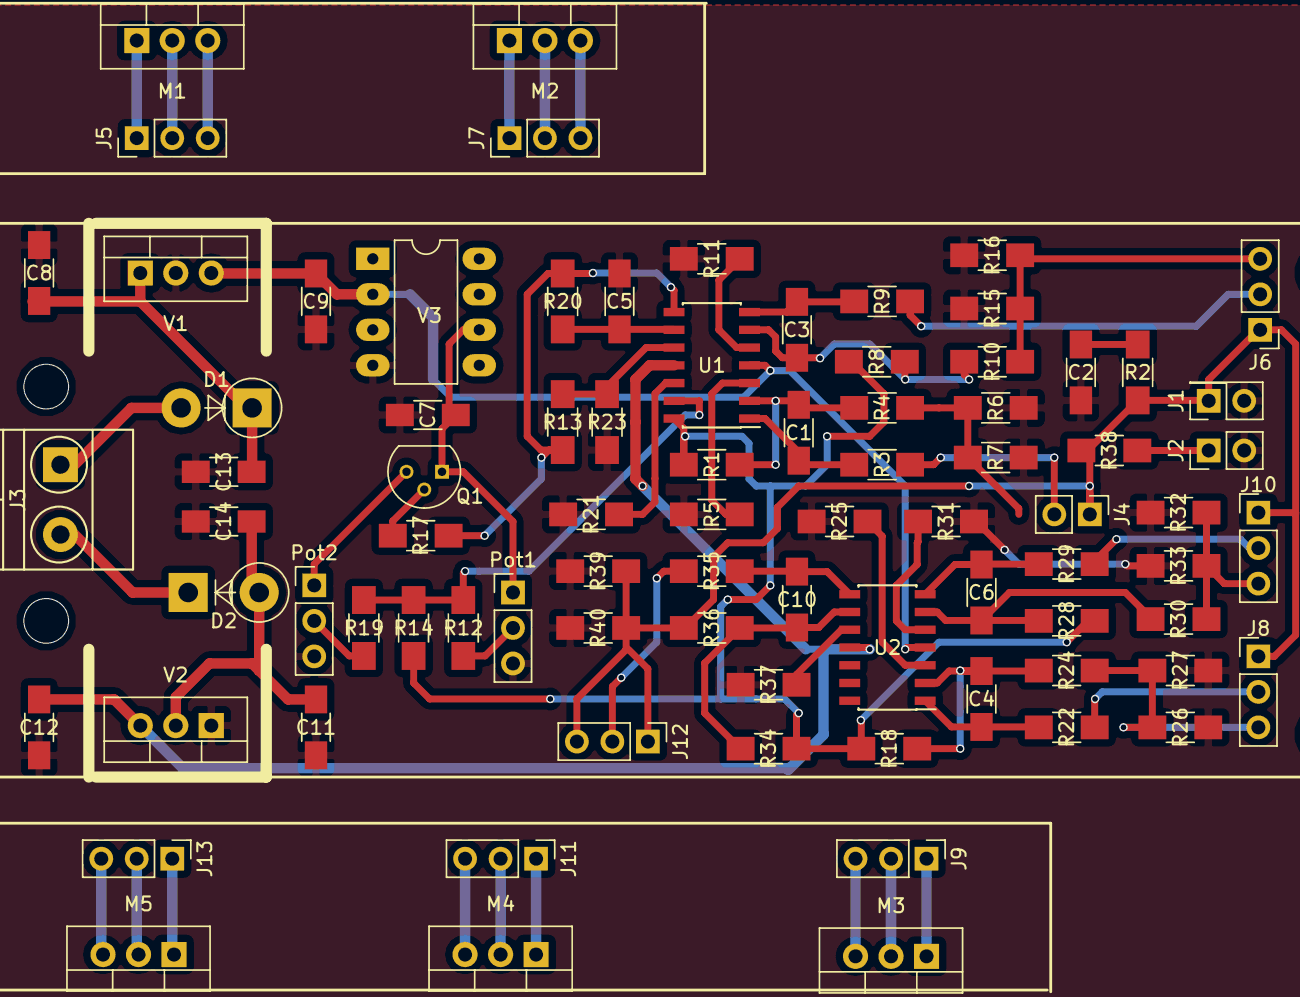
[picture p60: board LT1013 DS Electronic Load (1).kicad_pcb from above]

Board: 2 copper layers, 82 parts (0 on the bottom side), 60 nets.

Parts:
C1, C3, C4, C6, C10: 220pF; C_1206_HandSoldering
C2, C11: 2.2uF; C_1206_HandSoldering
C5, C7, C9: 0.1uF; C_1206_HandSoldering
C8: 0.33uF; C_1206_HandSoldering
C12: 1uF; C_1206_HandSoldering
C13, C14: 220uF; C_1206_HandSoldering
D1: 1N4002; D_5W_P5.08mm_Vertical_AnodeUp
D2: 1N4002; D_5W_P5.08mm_Vertical_KathodeUp
J1: Conn_01x02; Socket_Strip_Straight_2x01_Pitch2.54mm
J2: Conn_01x02; Pin_Header_Straight_1x02_Pitch2.54mm
J3: Screw_Terminal_01x02; TerminalBlock_Pheonix_MKDS1.5-2pol
J4: Conn_01x03; Pin_Header_Straight_1x02_Pitch2.54mm
J5, J6, J7, J8, J9, J10, J11, J12, J13: Conn_01x03; Pin_Header_Straight_1x03_Pitch2.54mm
M1, M2, M3, M4, M5: IRF530; TO-220-3_Vertical
Pot1, Pot2: 10K; Pin_Header_Straight_1x03_Pitch2.54mm
Q1: 2N3906; TO-92_Molded_Narrow
R1, R8, R13, R18, R21, R28, R34: 33K; R_1206_HandSoldering
R2: 2.2; R_1206_HandSoldering
R3, R9, R22, R29, R35: 100; R_1206_HandSoldering
R4, R5, R10, R11, R24, R25, R30, R31, R36, R37: 3K3; R_1206_HandSoldering
R6, R7, R15, R16, R26, R27, R32, R33, R39, R40: 0.2; R_1206_HandSoldering
R12, R14, R19: 100K; R_1206_HandSoldering
R17, R20, R23: 15K; R_1206_HandSoldering
R38: 51R; R_1206_HandSoldering
U1, U2: LT1013; SOIC-14_3.9x8.7mm_Pitch1.27mm
V1: L7809; TO-220-3_Vertical
V2: LM7909_TO220; TO-220-3_Vertical
V3: LT1019_Voltage_Reference; DIP-8_W7.62mm_LongPads

Connections:
/+9V: C9.1, U1.4, U2.4, V1.3, V3.2
/-9v: C12.1, U1.11, U2.11, V2.3
/Vref: C7.1, Pot1.1, Q1.1, V3.6
GND: C2.2, C5.2, C7.2, C8.2, C9.2, C11.2, C12.2, C13.1, C14.2, J1.2, J2.2, Pot1.3, Pot2.3, R5.2, R6.2, R7.2, R11.2, R15.2, R16.2, R21.1, R23.2, R25.2, R26.2, R27.2, R31.2, R32.2, R33.2, R37.2, R39.2, R40.2, V1.2, V2.1, V3.4
unnamed: C1.1, R3.2, U1.1
unnamed: C1.2, R1.2, R4.1, U1.2
unnamed: C2.1, R2.2
unnamed: C3.1, R9.2, U1.7
unnamed: C3.2, R8.2, R10.1, U1.6
unnamed: C4.1, R22.2, U2.1
unnamed: C4.2, R18.2, R24.1, U2.2
unnamed: C5.1, R20.2, U1.9
unnamed: C6.1, R29.2, U2.7
unnamed: C6.2, R28.2, R30.1, U2.6
unnamed: C10.1, R35.2, U2.8
unnamed: C10.2, R34.2, R36.1, U2.9
unnamed: C11.1, C14.1, D2.2, V2.2
unnamed: C8.1, C13.2, D1.1, V1.1
unnamed: D1.2, J3.1
unnamed: D2.1, J3.2
unnamed: J1.1, J4.1, J6.1, J8.1, J10.1, J12.1, J12.3, R2.1, R36.2, R38.2, R39.1, R40.1
unnamed: J2.1, R38.1
unnamed: J4.2, R3.1
unnamed: R4.2, R6.1, R7.1
unnamed: J5.1, M1.1
unnamed: J5.2, M1.2
unnamed: J5.3, M1.3
unnamed: J6.2, R9.1
unnamed: J6.3, R10.2, R15.1, R16.1
unnamed: J7.1, M2.1
unnamed: J7.2, M2.2
unnamed: J7.3, M2.3
unnamed: J8.2, R22.1
unnamed: J8.3, R24.2, R26.1, R27.1
unnamed: J9.1, M3.1
unnamed: J9.2, M3.2
unnamed: J9.3, M3.3
unnamed: J10.2, R29.1
unnamed: J10.3, R30.2, R32.1, R33.1
unnamed: J11.1, M4.1
unnamed: J11.2, M4.2
unnamed: J11.3, M4.3
unnamed: J12.2, R35.1
unnamed: J13.1, M5.1
unnamed: J13.2, M5.2
unnamed: J13.3, M5.3
unnamed: Pot1.2, R12.2
unnamed: Pot2.1, Q1.3
unnamed: Pot2.2, R19.2
unnamed: Q1.2, R17.1
unnamed: R1.1, R8.1, R14.1, R18.1, R28.1, R34.1, U1.14
unnamed: R5.1, U1.3
unnamed: R11.1, U1.5
unnamed: R12.1, R14.2, R19.1, U1.13
unnamed: R13.1, R17.2, R20.1, U1.8
unnamed: R13.2, R23.1, U1.10
unnamed: R21.2, U1.12
unnamed: R25.1, U2.3
unnamed: R31.1, U2.5
unnamed: R37.1, U2.10
