WeymenKoo/dc-electronic-load/(commit log)

2026-10-31 DC electronic load: Rev D integrated isolated schematic, reorganised repository
    Rev D: one KiCad 10 board replacing the Rev B control board + Rev C power board.
    STM32G0B1 with USB-C (power, CDC, DFU), ISO7761 digital isolator and 1 W DC-DC
    between the USB side and the floating analog stage, MCP4822 set-point DAC,
    ADS1118 16-bit readback, 7-segment front panel with encoder and buttons, LM339
    protection (OTP, dropout/KILL, NTC-open, OVP). Analog stage is the LTspice-verified
    Rev C design; check_netlist_revd.py proves the netlist against deck 06.
    ERC 0/0. Schematic readability: outline font, 1.5 mm text, A4 sheets, colour-coded
    nets, block frames, barrier drawn.
    Repository reorganised: hardwar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
2026-10-31 Rev D schematic: drawing rules enforced by lint, A3 + JetBrains Mono, power tree, STM32G0B1CBT6
    - kgen: bounding boxes for every item, lint (text/text, text/symbol, text/wire,
    symbol/symbol, symbol/wire, junction degree >= 4, frame overlap, margins,
    title-block corner, crossing list), auto-fitted block frames, sheet centring,
    grid snapping. Build fails on any violation; currently 0.
    - All sheets A3, JetBrains Mono (4.5 / 2.5 / 2.0 / 1.6 / 1.4 mm), notes dark grey,
    18 mm sheet margin, hop-overs enabled in the project file.
    - USB & Power sheet redrawn as a power tree (VBUS trunk, three branches, rails
    aligned). Staggered joints replace 4-way junctions (channel source bus, VSEN tap).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
2026-11-03 Rev E: cost-reduced build of the Rev D load, re-simulated on the TLV9154, priced at JLCPCB, block-diagram root sheet
    Simulation: simulation/rev_e re-runs decks 01-04 and 06 with TI's TLV9152 PSpice model (lib/tlv915x.lib), Rb 22M -> 15M,
    same .meas so results compare line by line with the untouched Rev C set; ltrun_local.sh runs LTspice from a local copy
    (Google Drive breaks its .raw writes). Planar FETs keep the Rev C margins; the big-die IXTH proxy loses gain margin.
    Schematic: hardware/rev_e replaces rev_d. TLV9154 quads, OLED + encoder UI, 5 V blower on VBUS, 78L05, CA-IS3761HW,
    STM32G0B1RBT6 (the G0B1 JLC stocks), M4 bolt terminals, soldered mini-blade fuse, all 1 % resistors, LCSC cod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
